EE23DP003/eFuse/inkscape/Pics/Setup Pic/overall_setup.jpg

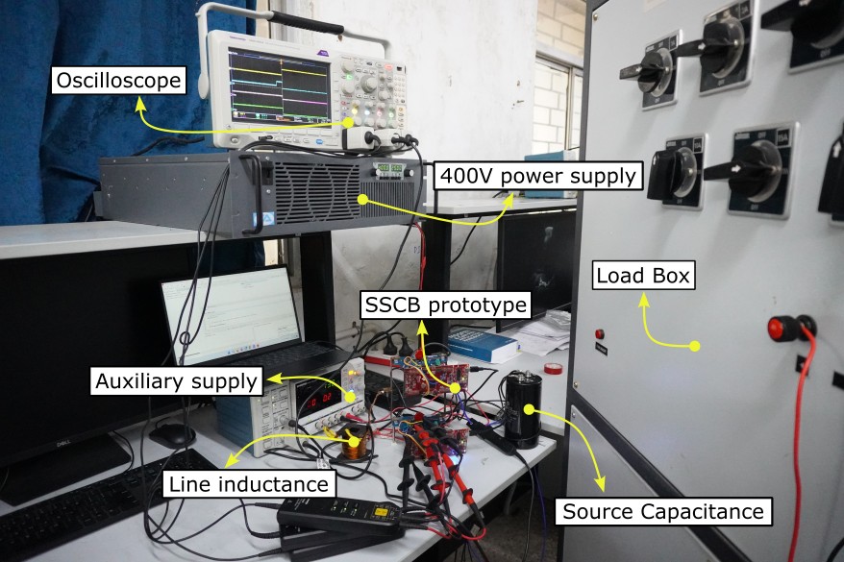
inkscape/Pics/Setup Pic/overall_setup.jpg
