EE23DP003/eFuse/inkscape/Pics/Modular pic/modular_image.jpg

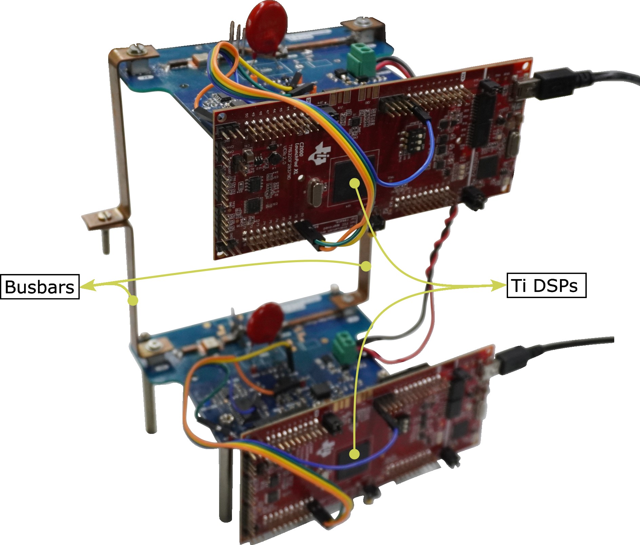
inkscape/Pics/Modular pic/modular_image.jpg
