EE23DP003/eFuse/inkscape/Fixed time modular/fixed-time-modular-10-15A.pdf

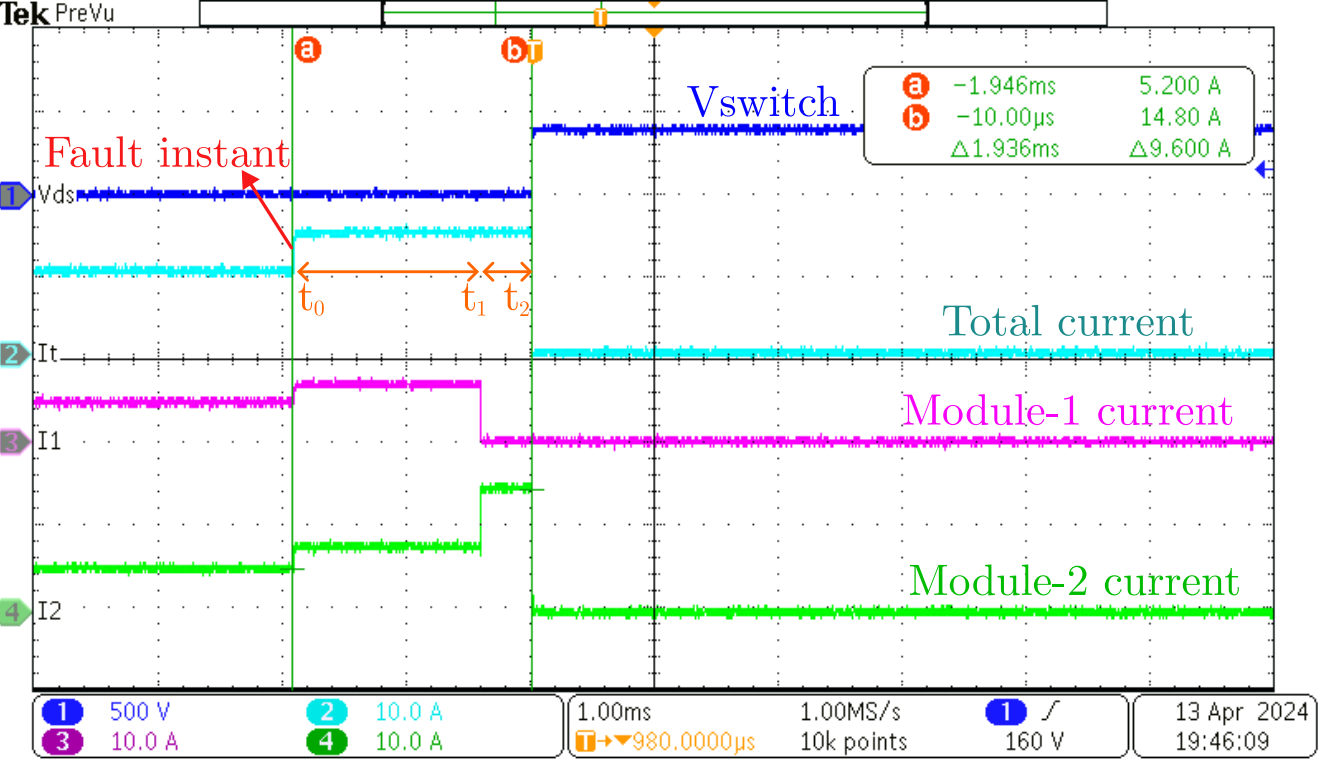
[picture p3: page 1]
