EE23DP003/eFuse/inkscape/Fixed time tripping/Fixed_time_tripping-10-20A.pdf

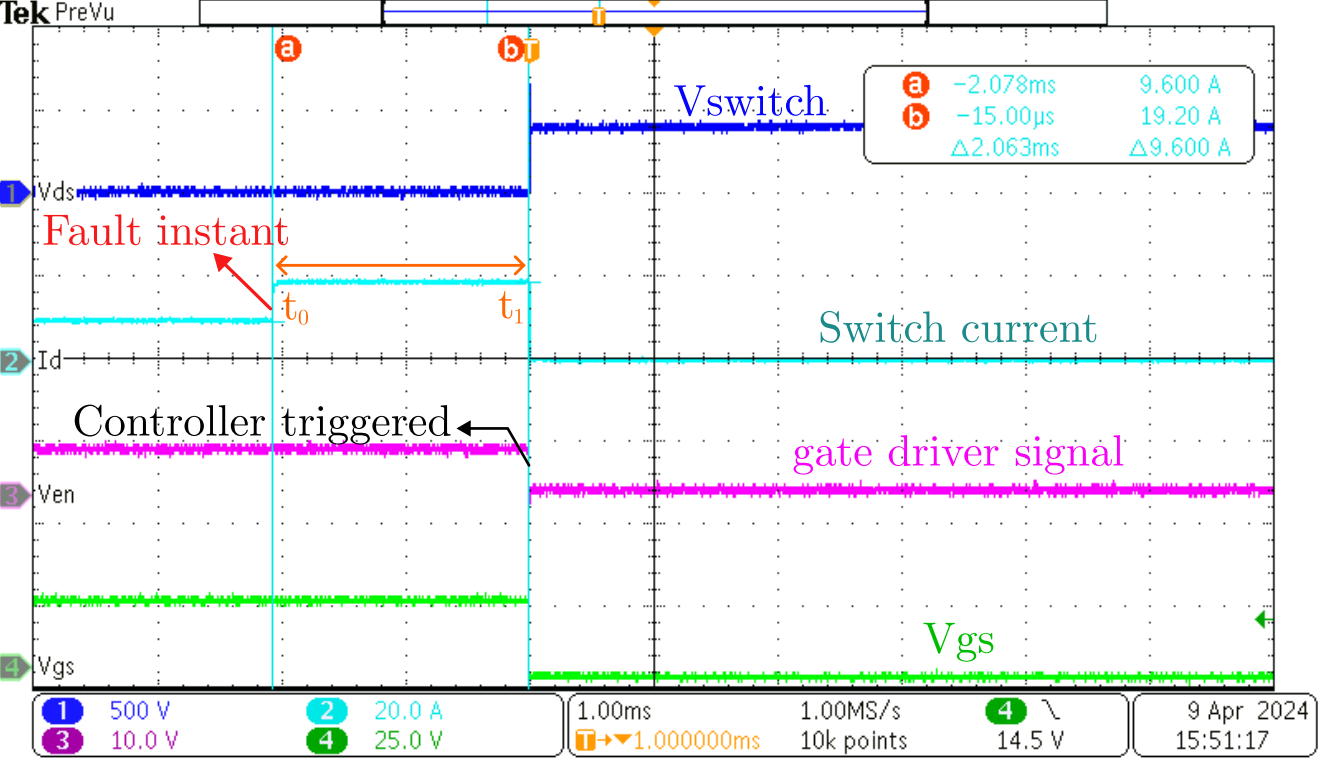
[picture p4: page 1]
