EE23DP003/eFuse/inkscape/Fixed time tripping/Fixed_time_tripping-10-25A.pdf

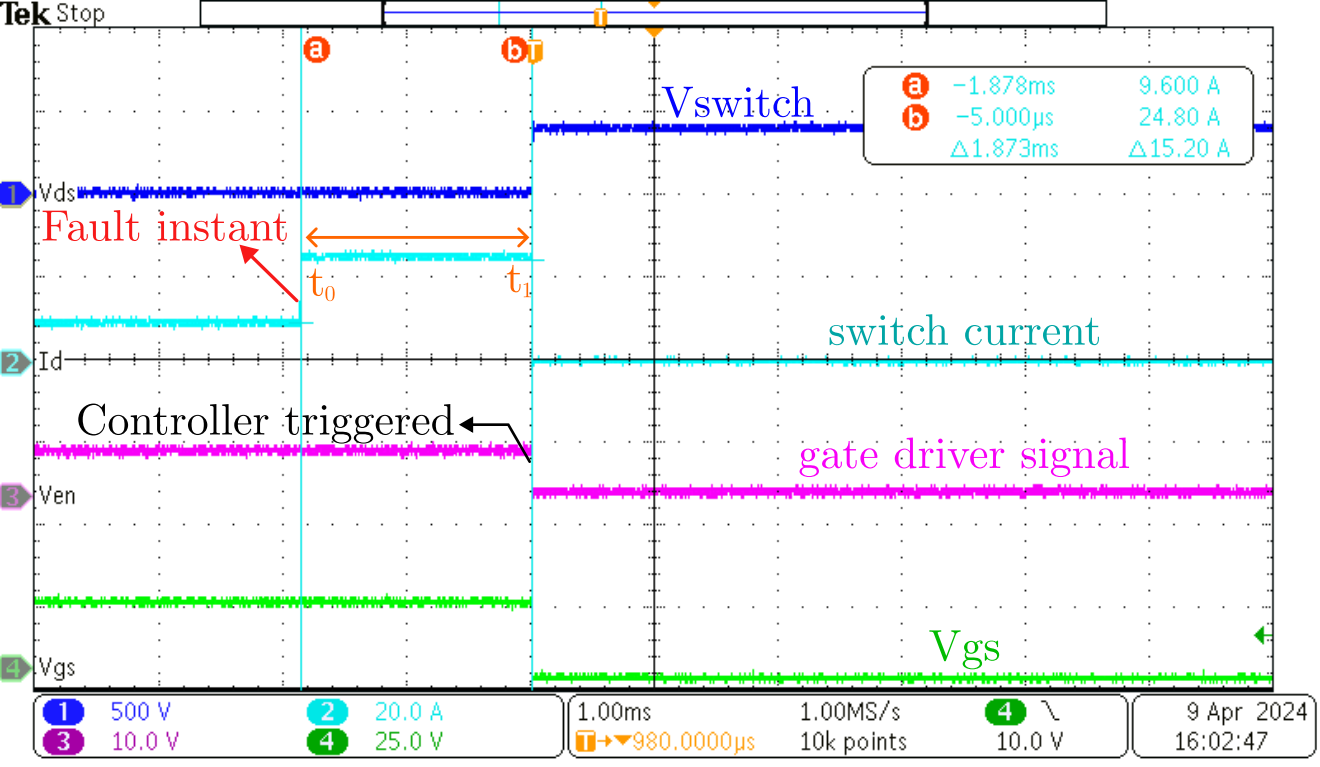
[picture p5: page 1]
