EE23DP003/eFuse/inkscape/I2T back to normal current/I2t_back_to_normal_current.pdf

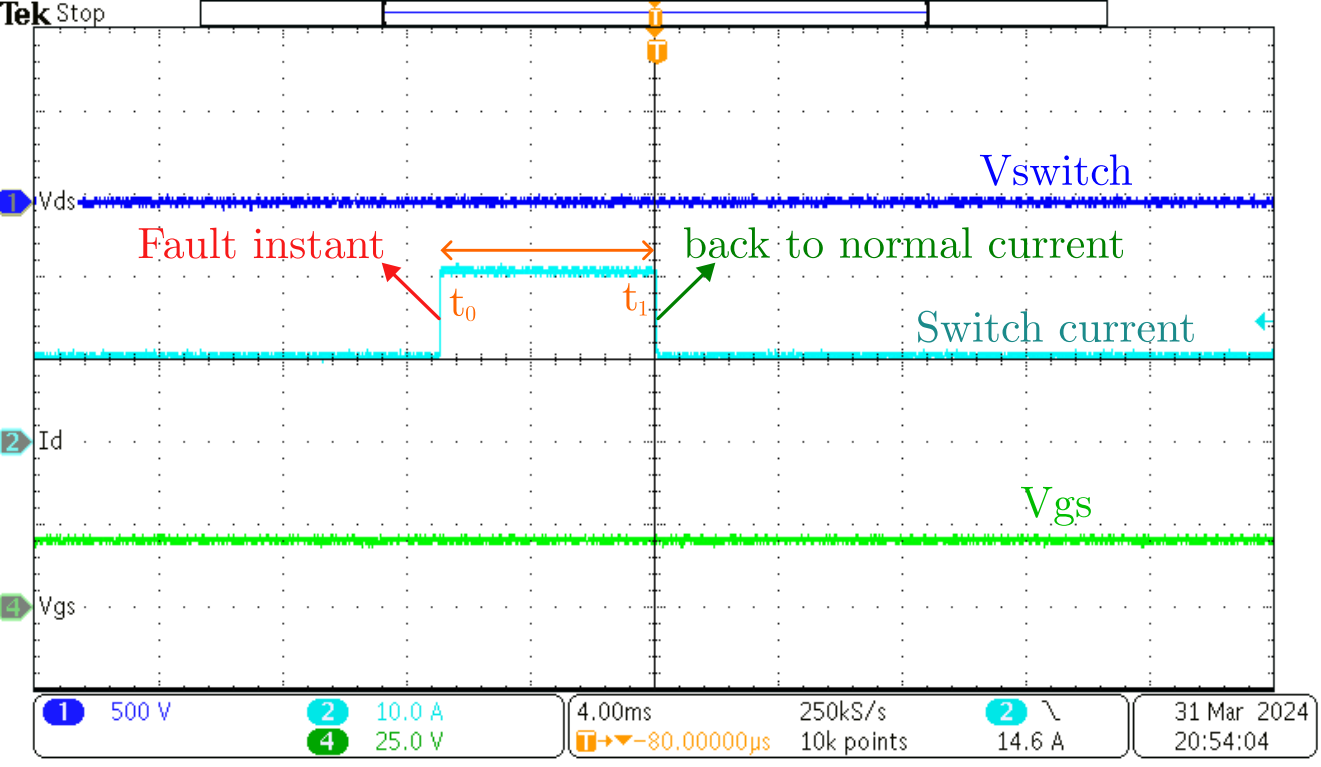
[picture p6: page 1]
