EE23DP003/eFuse/inkscape/I2T single module/i2T_single_module_4-23A.pdf

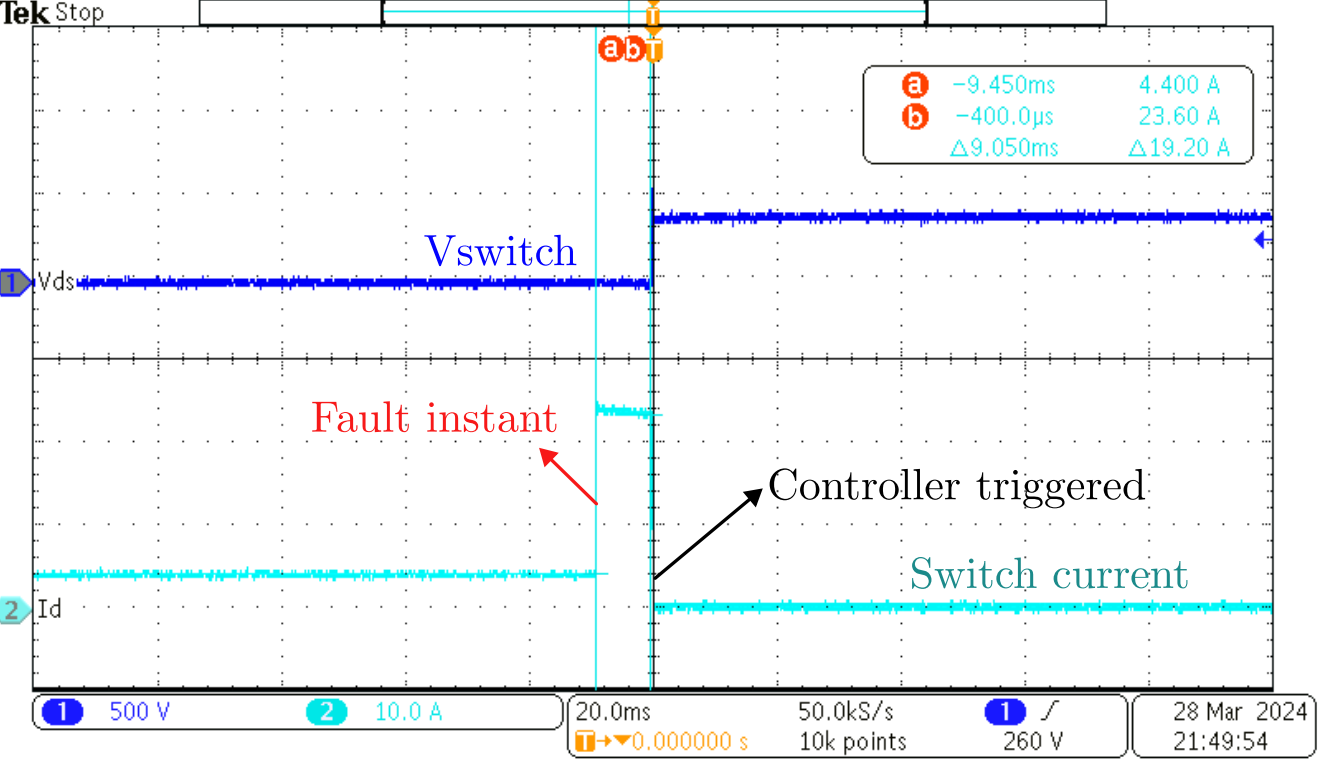
[picture p7: page 1]
