EE23DP003/eFuse/inkscape/I2T single module/i2T_single_module_4-8A.pdf

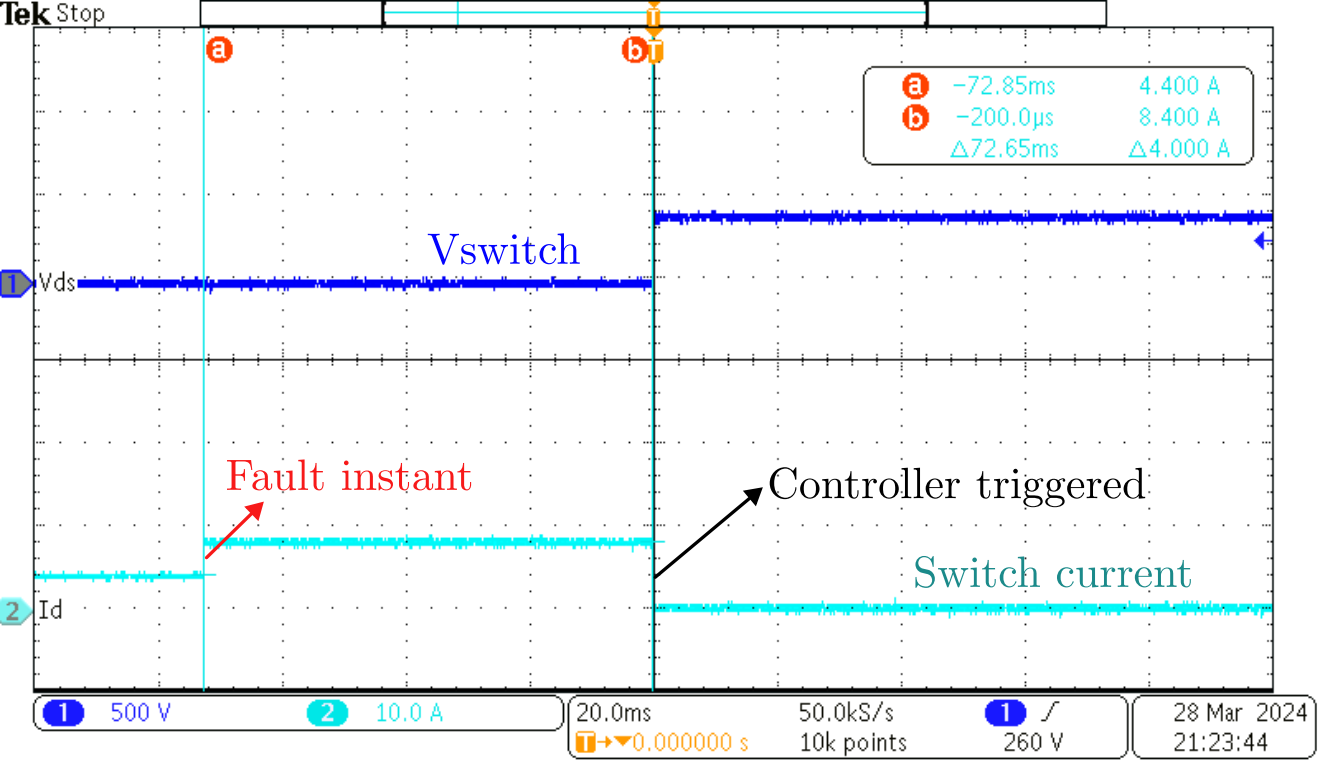
[picture p8: page 1]
