EE23DP003/eFuse/inkscape/I2T-modular/i2t_modular_10-16A_zoomed.pdf

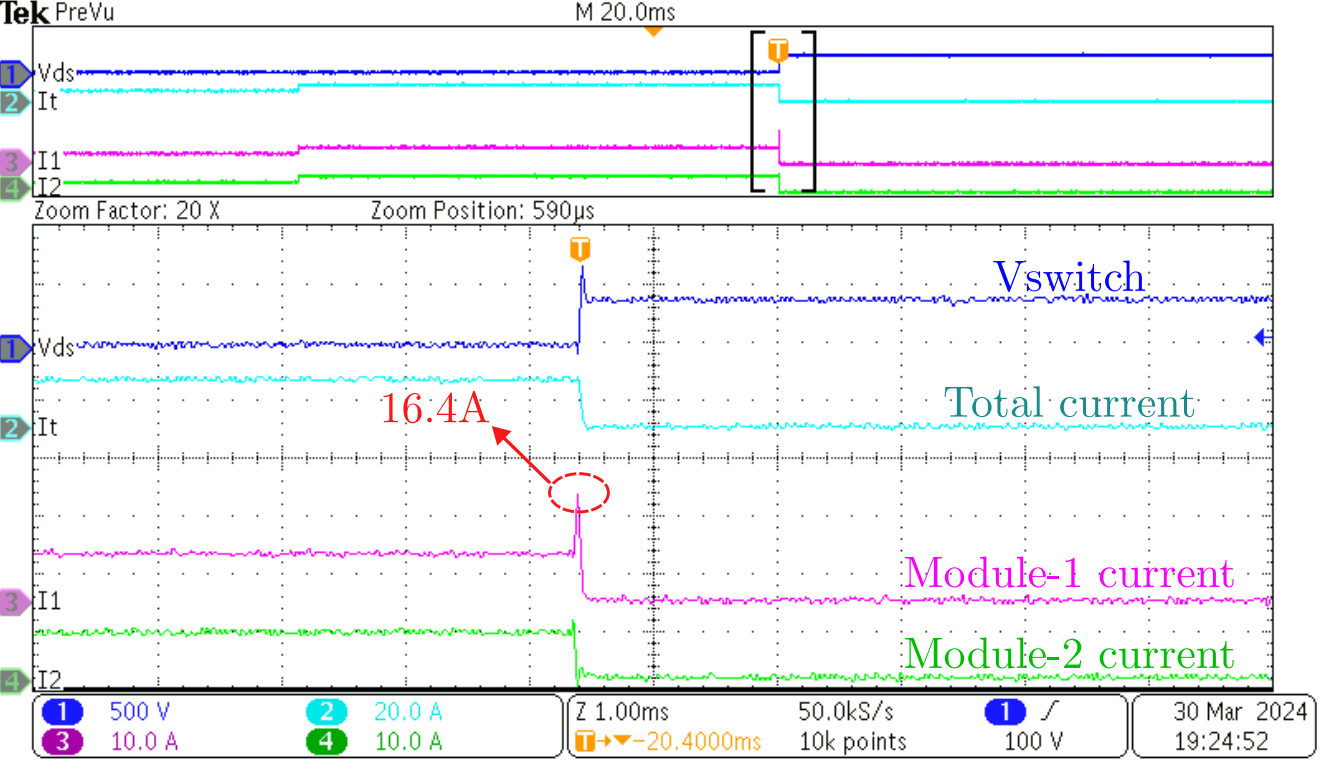
[picture p9: page 1]
