EE23DP003/eFuse/inkscape/I2T-modular/i2t_modular_10-19A.pdf

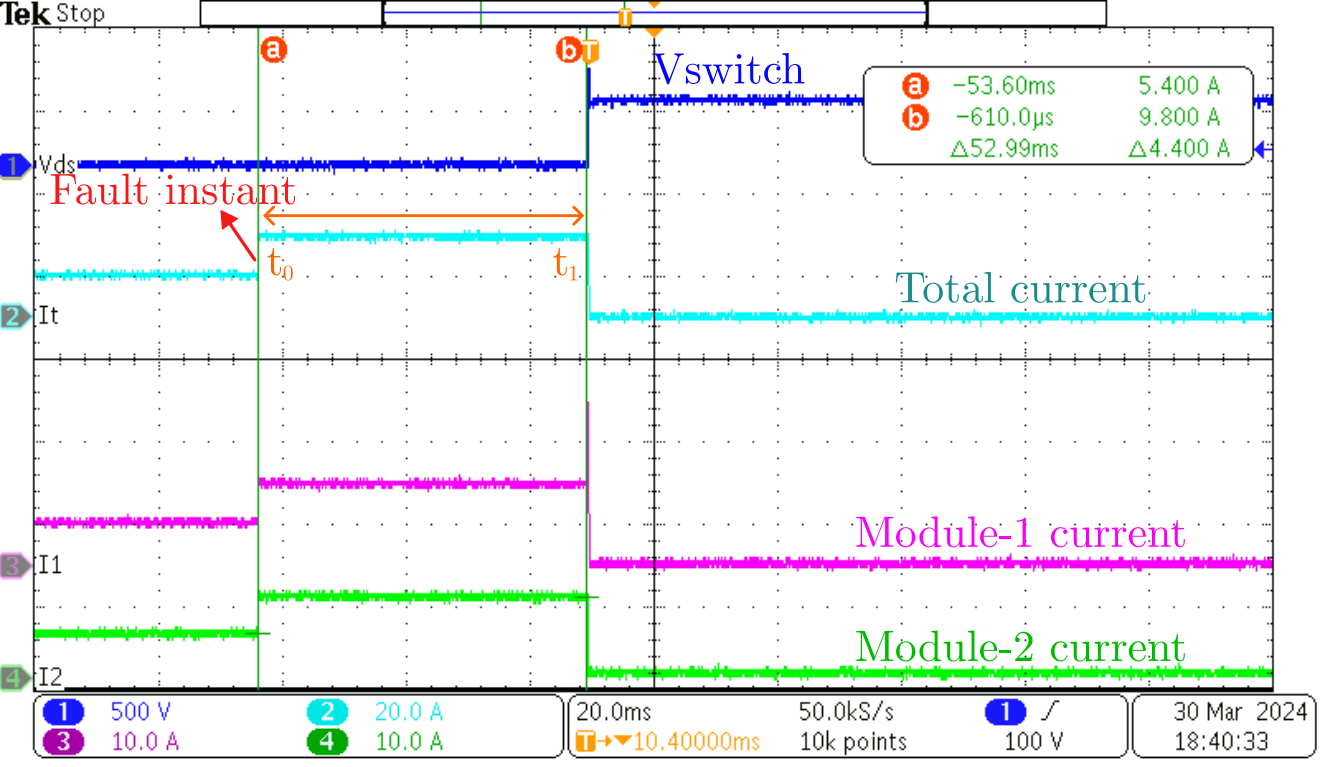
[picture p10: page 1]
