EE23DP003/eFuse/inkscape/I2T-modular/i2t_modular_10-19A_zoomed.pdf

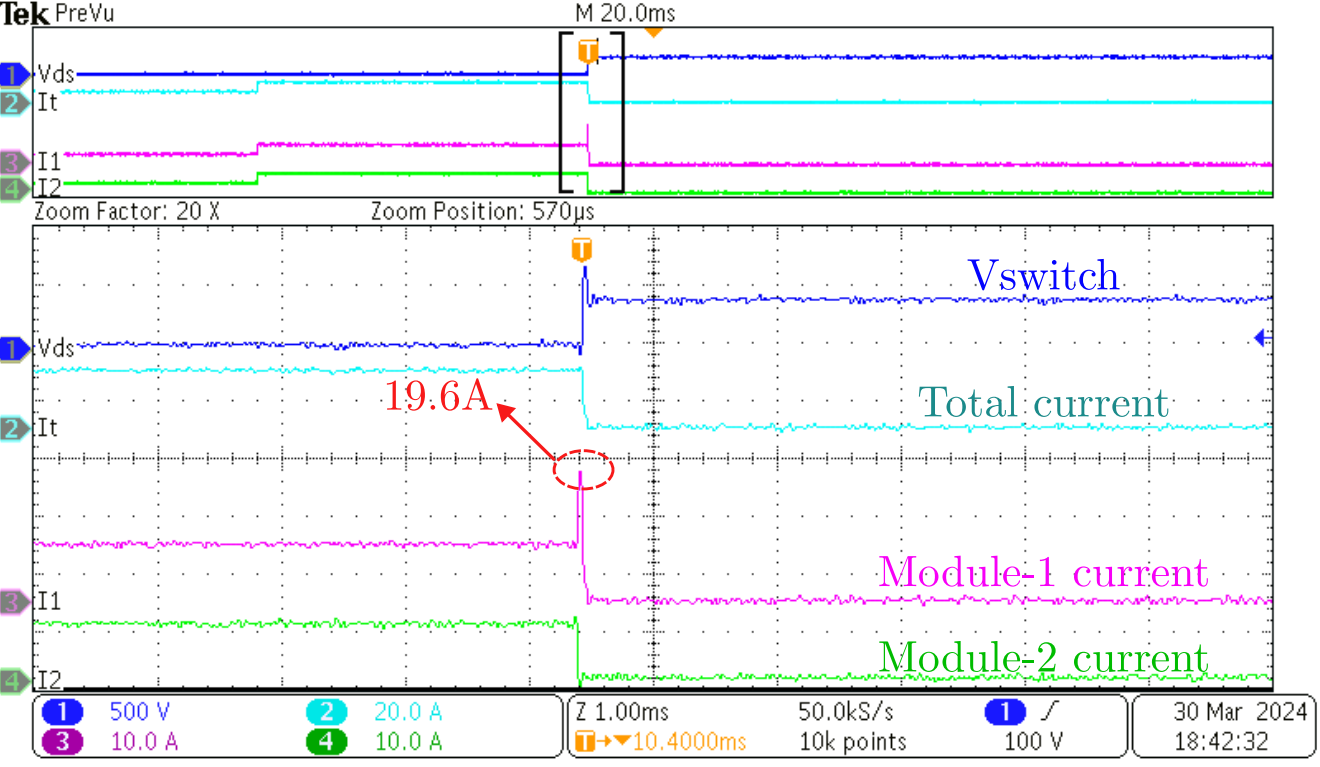
[picture p11: page 1]
