EE23DP003/eFuse/inkscape/I2T-modular/i2t_modular_10-22A.pdf

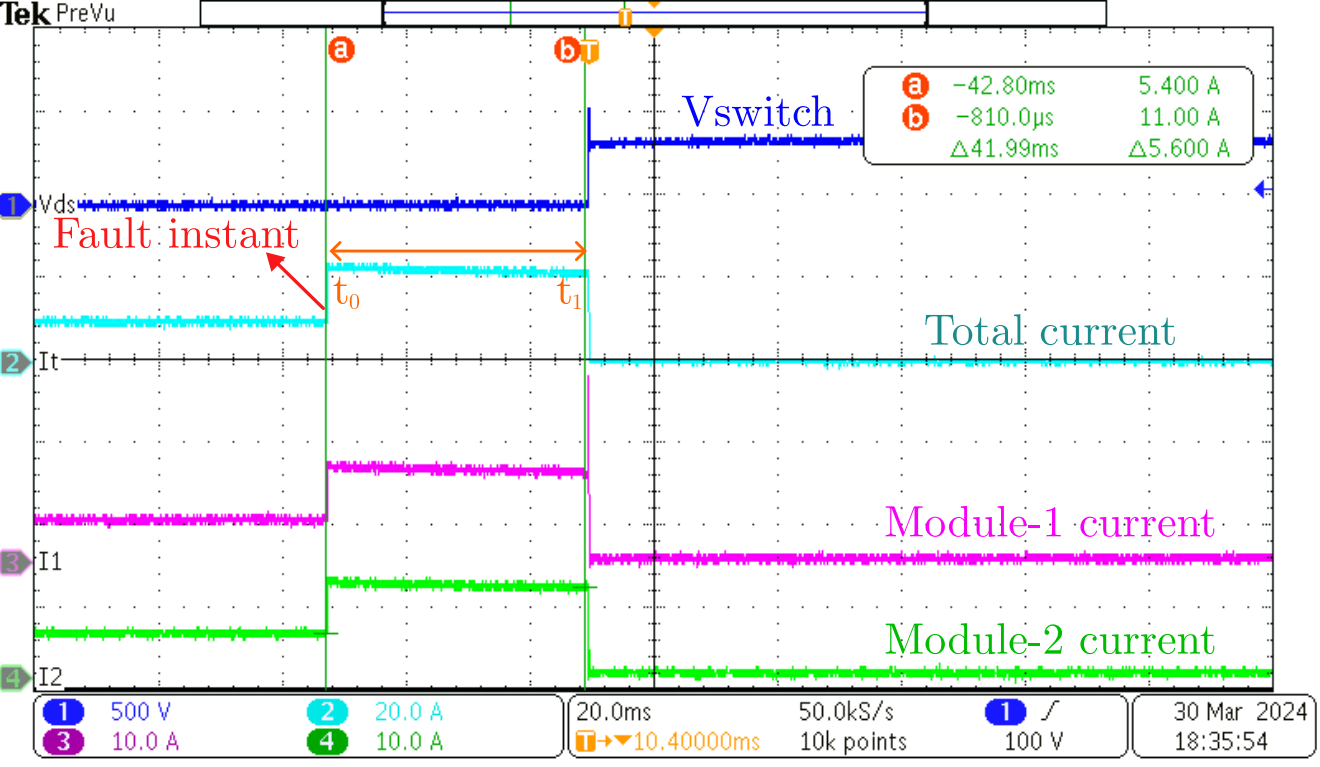
[picture p12: page 1]
