EE23DP003/eFuse/inkscape/I2T-modular/i2t_modular_10-22A_zoomed.pdf

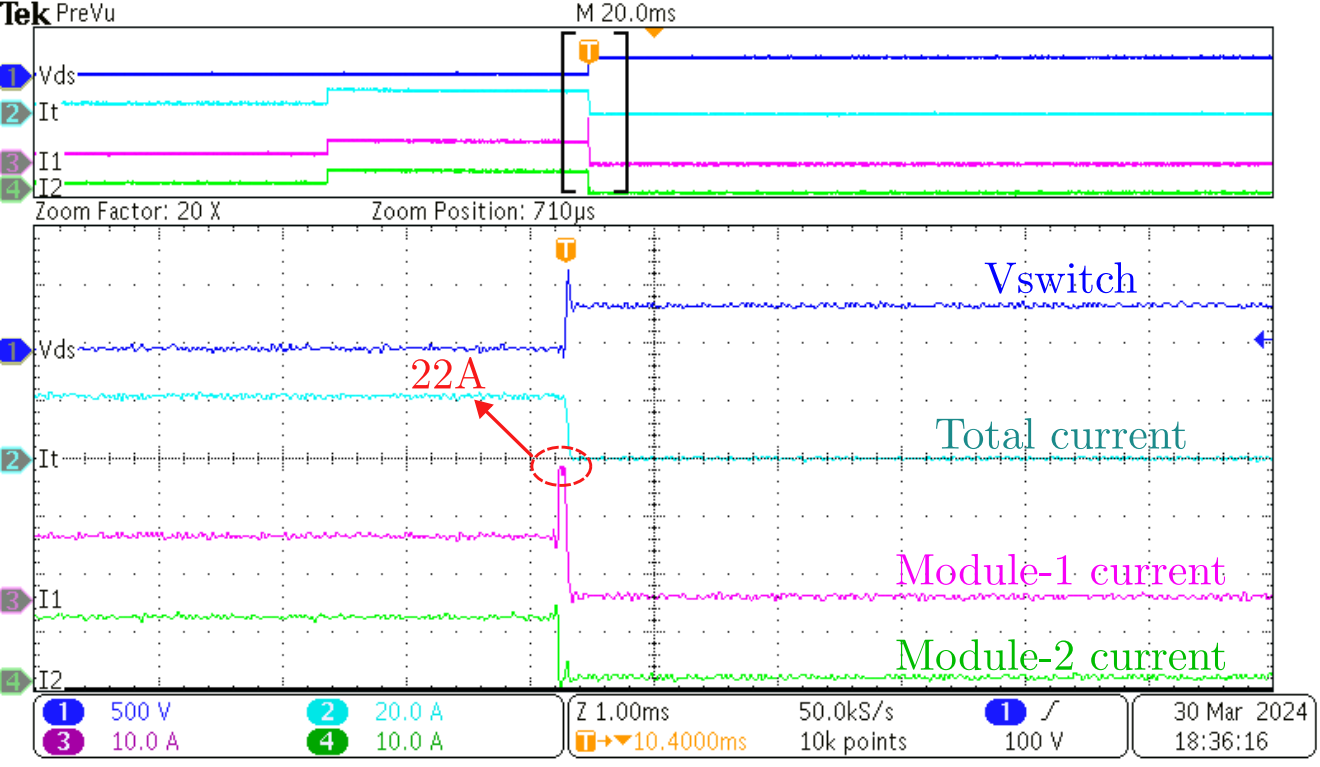
[picture p13: page 1]
