EE23DP003/eFuse/inkscape/Shortcircuit-Modular/modular-shortcircuit_33A.pdf

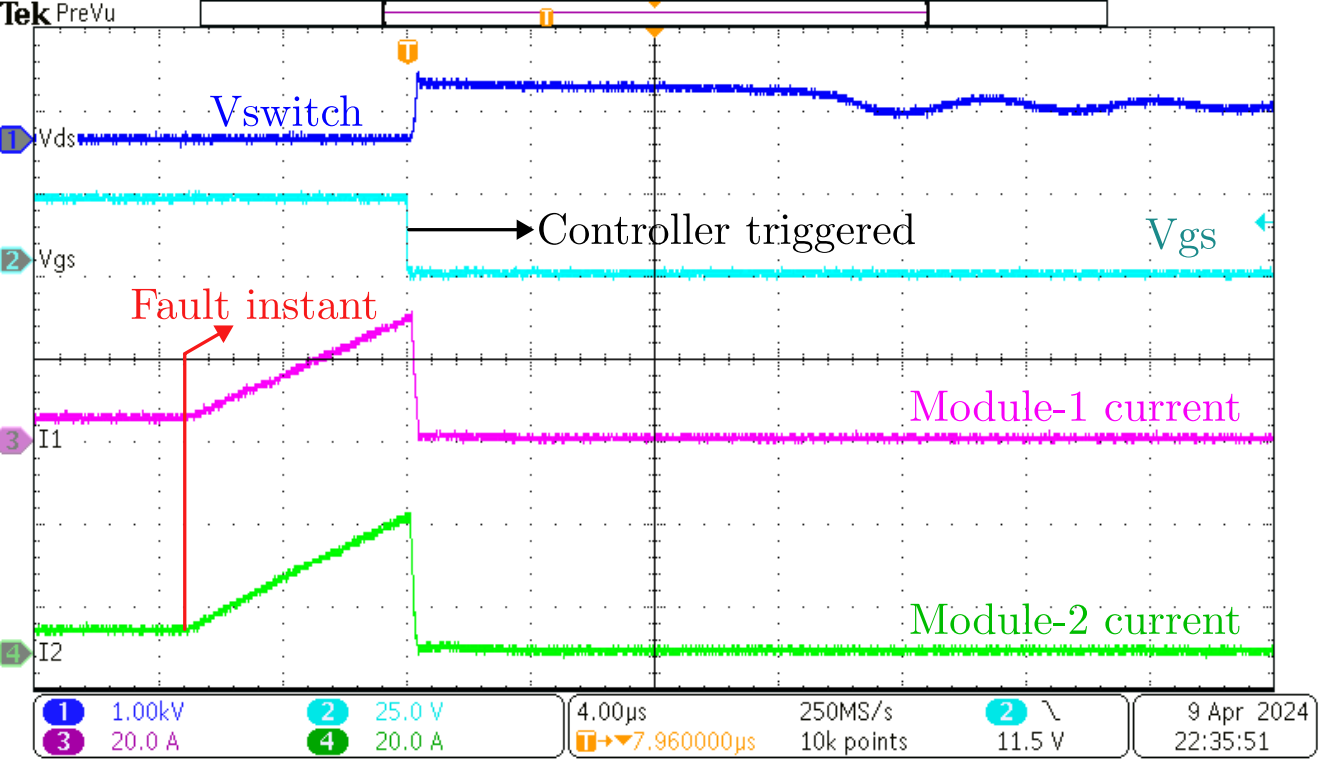
[picture p14: page 1]
