EE23DP003/eFuse/inkscape/Shortcircuit-Modular/modular-shortcircuit_33A_total.pdf

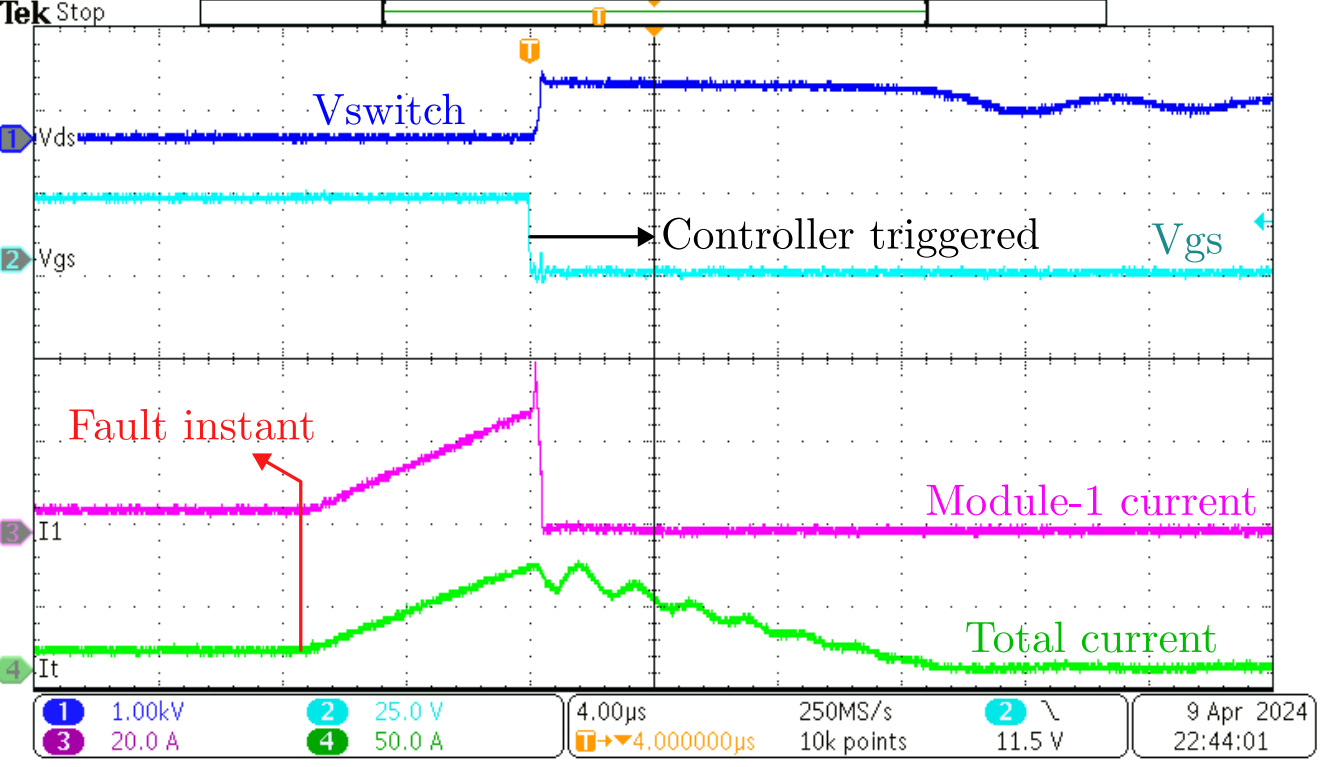
[picture p15: page 1]
