EE23DP003/eFuse/inkscape/Shortcircuit-Modular/modular-shortcircuit_66A_Ovsh.pdf

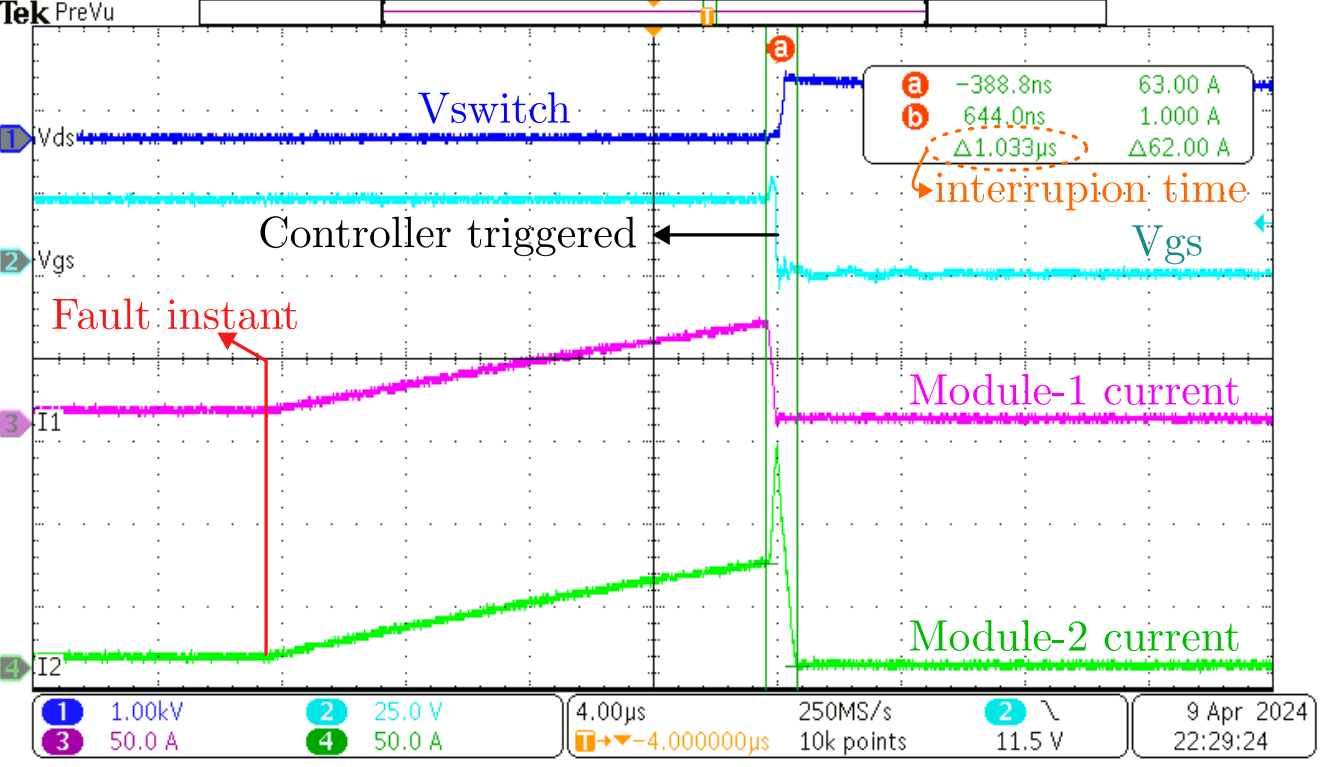
[picture p16: page 1]
