EE23DP003/eFuse/inkscape/Shortcircuit-Modular/modular-shortcircuit_66A_total.pdf

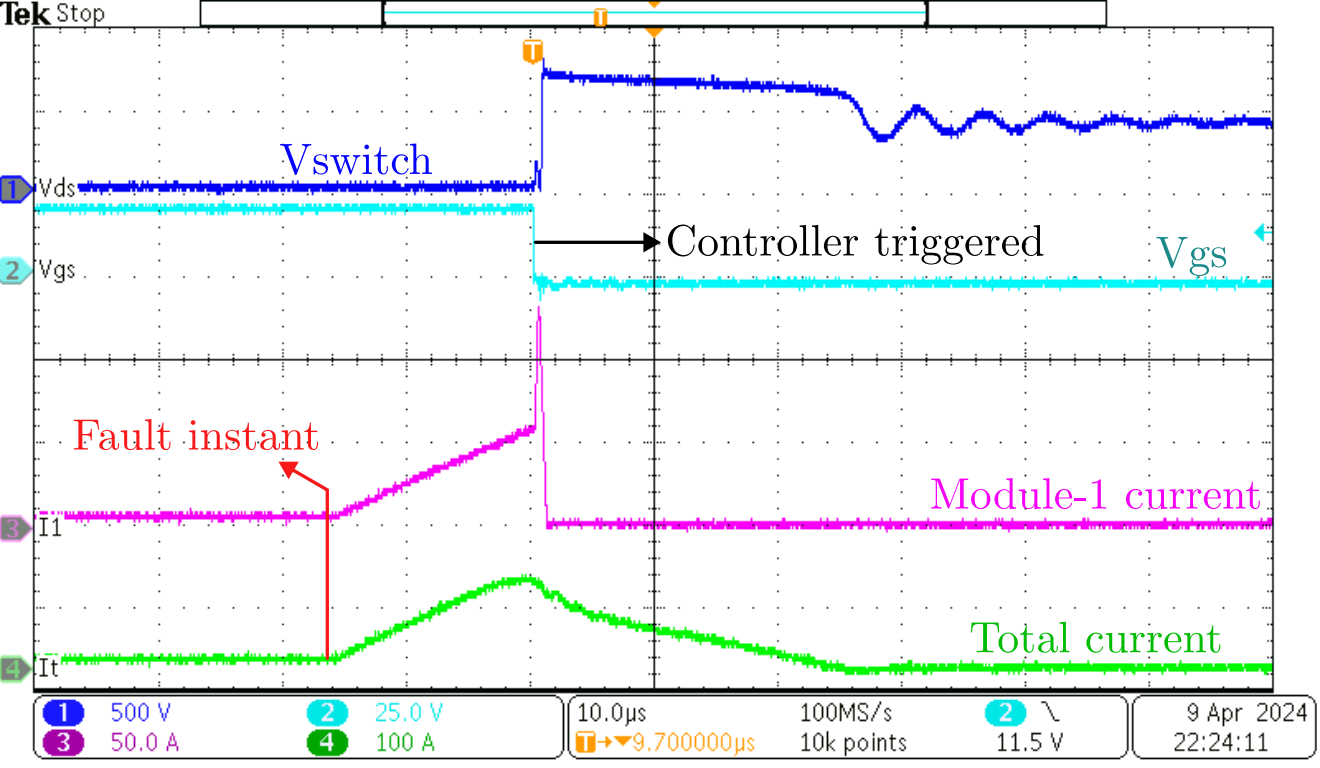
[picture p17: page 1]
