EE23DP003/eFuse/inkscape/Shortcircuit/shortcircuit_32A.pdf

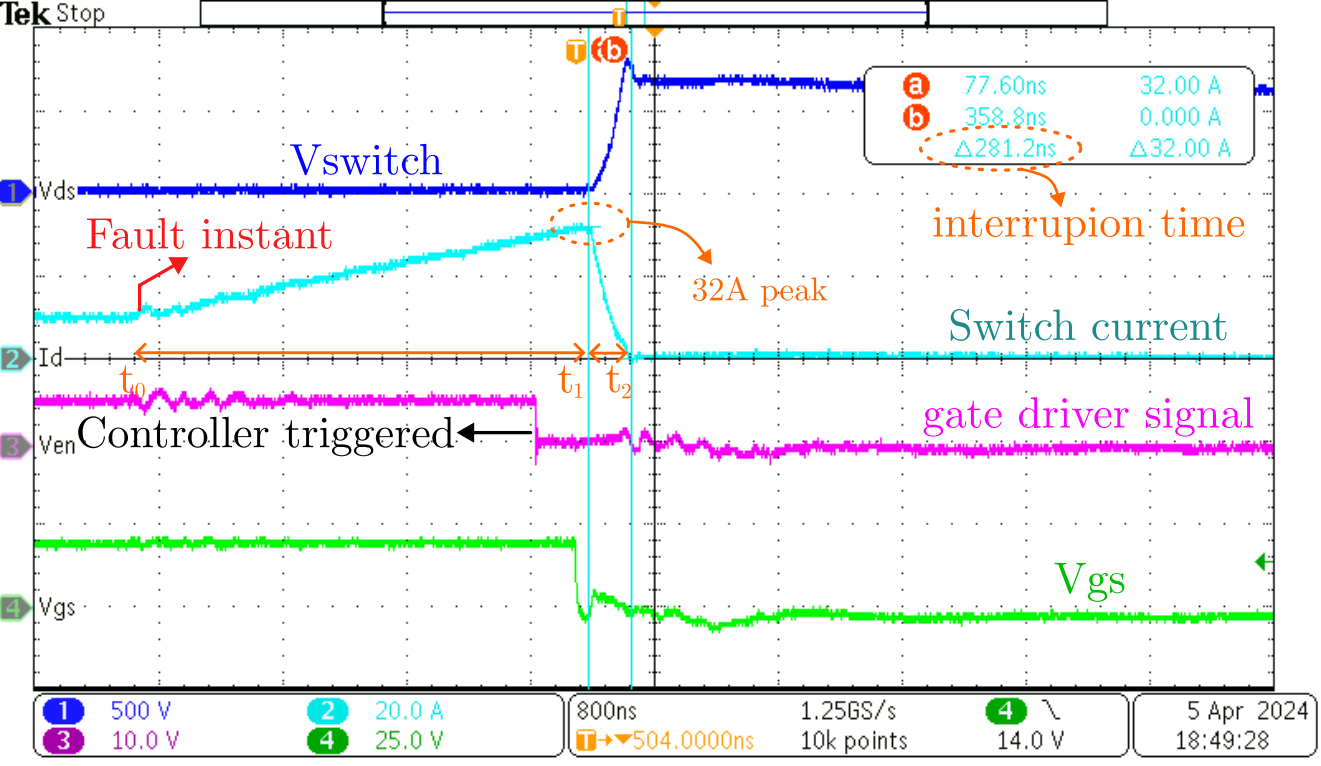
[picture p18: page 1]
