EE23DP003/eFuse/inkscape/Archived/circuit.pdf

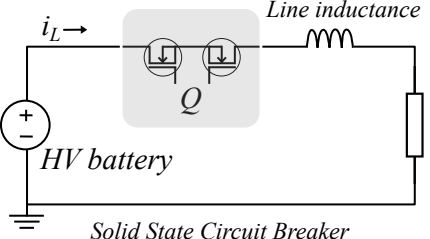
[picture p19: figure]
Solid State Circuit Breaker; Line inductance; HV battery

RL
