EE23DP003/eFuse/inkscape/Archived/overcurrent.pdf

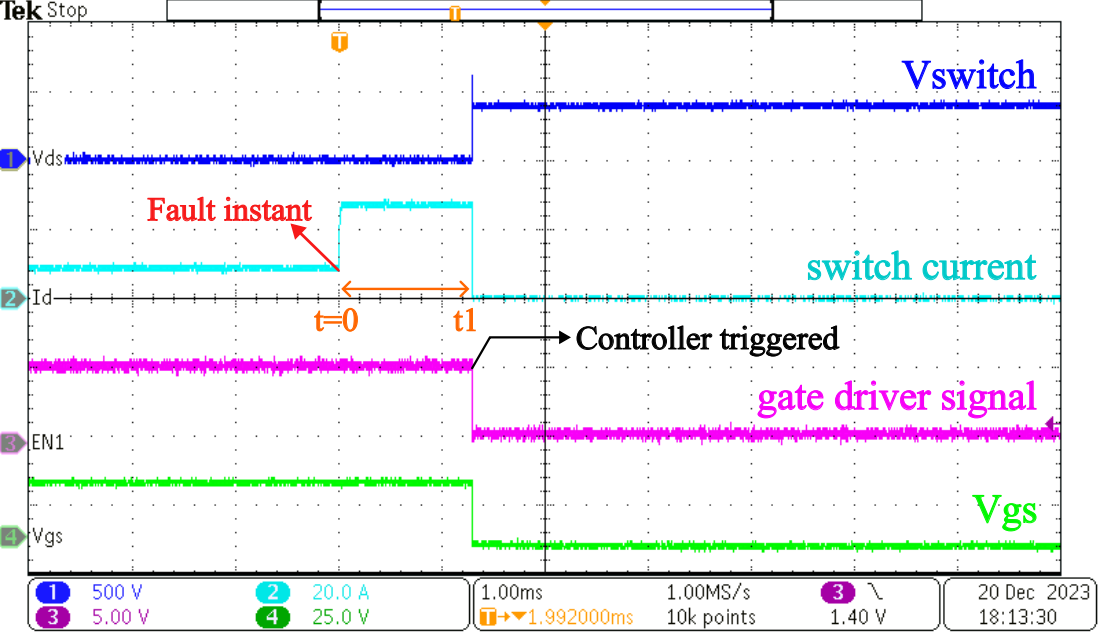
[picture p20: page 1]
switch current; Vgs; Vswitch; Fault instant; Controller triggered

gate driver signal
