EE23DP003/eFuse/inkscape/Archived/shortcircuit.pdf

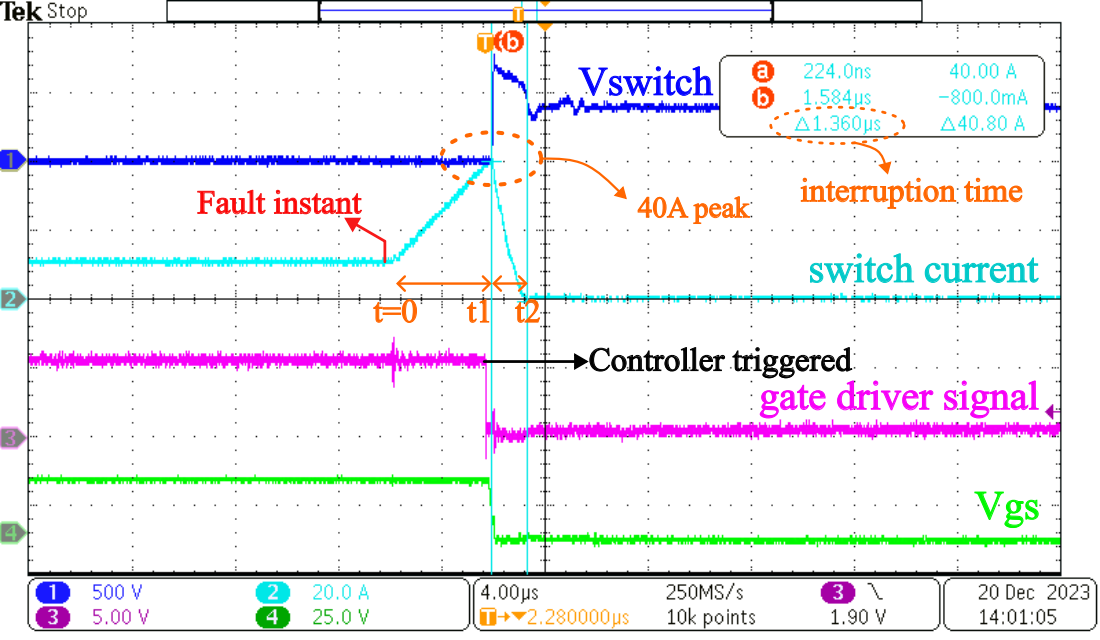
[picture p21: page 1]
Vgs; switch current; Vswitch; 40A peak; Fault instant; interruption time; Controller triggered

gate driver signal
