EE23DP003/eFuse/inkscape/Pics/Single module pic/single_module.jpg

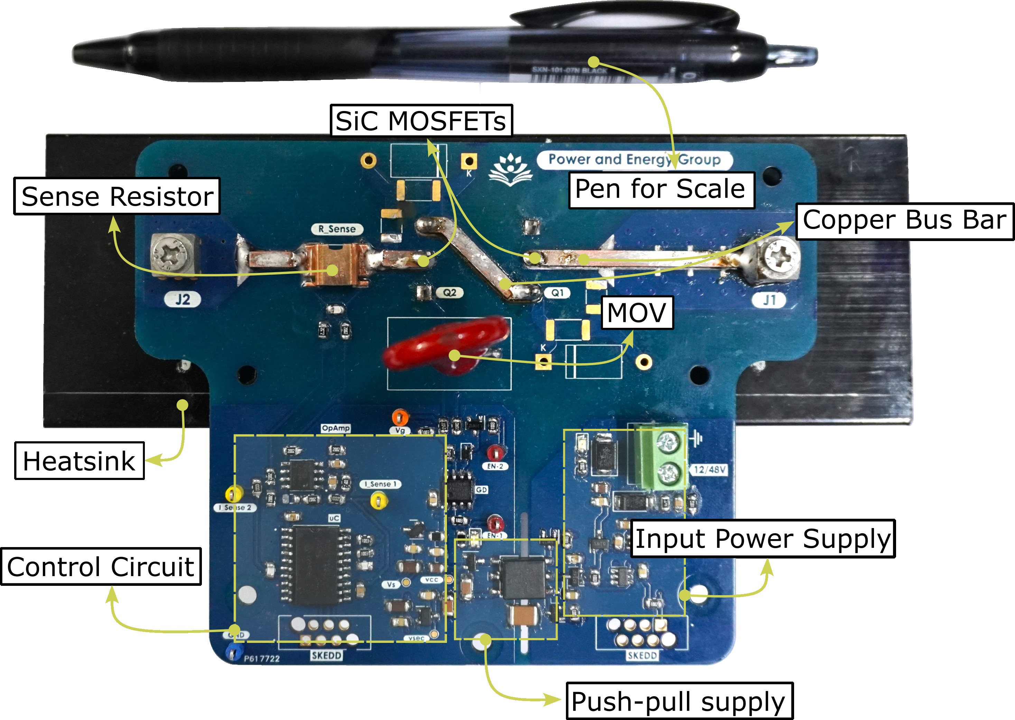
inkscape/Pics/Single module pic/single_module.jpg
