EE23DP003/eFuse/MATLAB/I2T_matlab.jpg

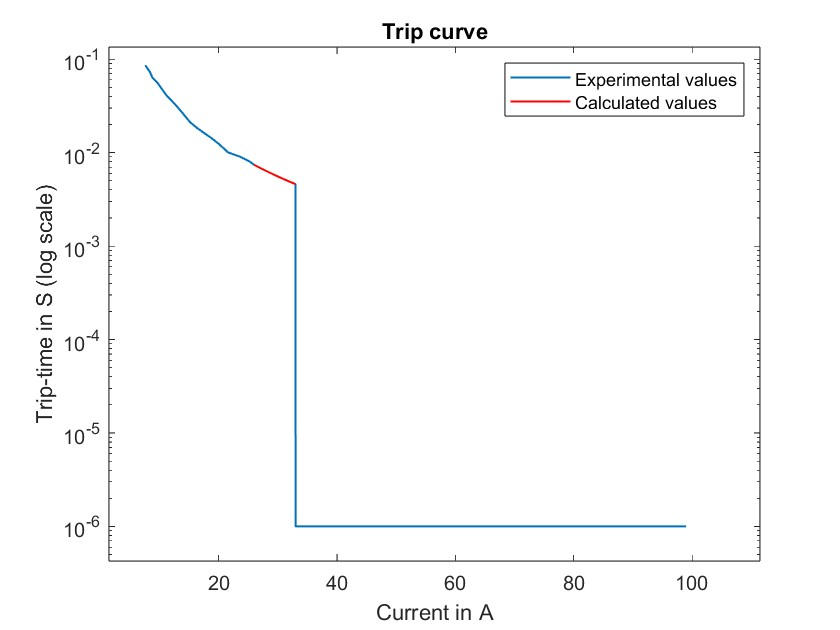
MATLAB/I2T_matlab.jpg
