EE23DP003/eFuse/Pics/Single module pics/board_top.png

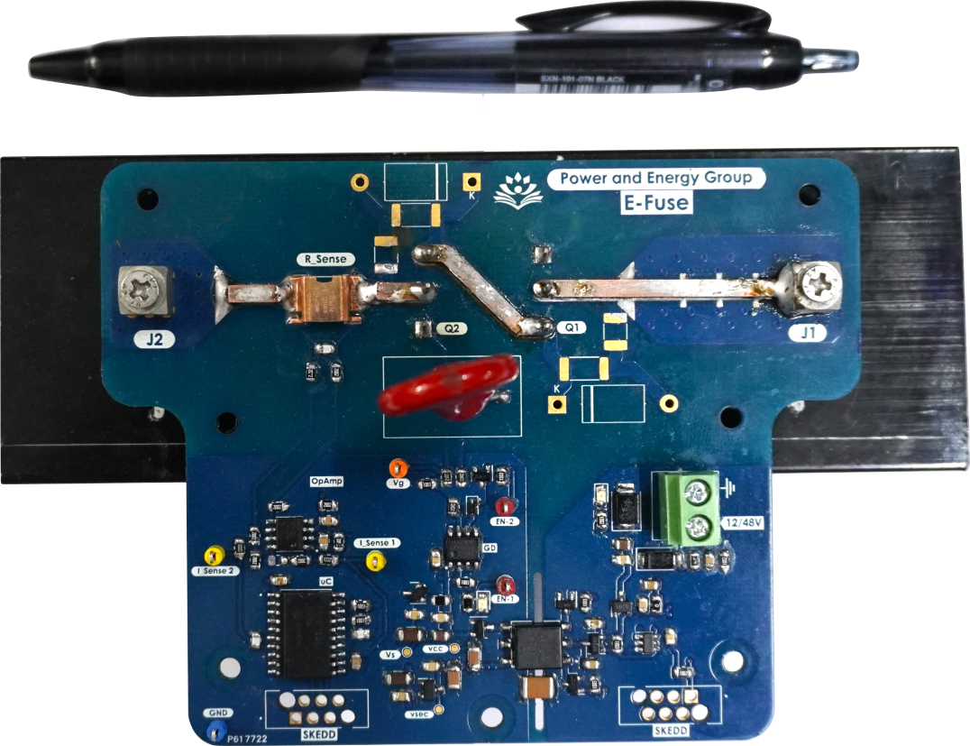
Pics/Single module pics/board_top.png
