EE23DP003/eFuse/PCB files/Footprints&symbols/2EDF7275F/3D/2EDF7275F.stp

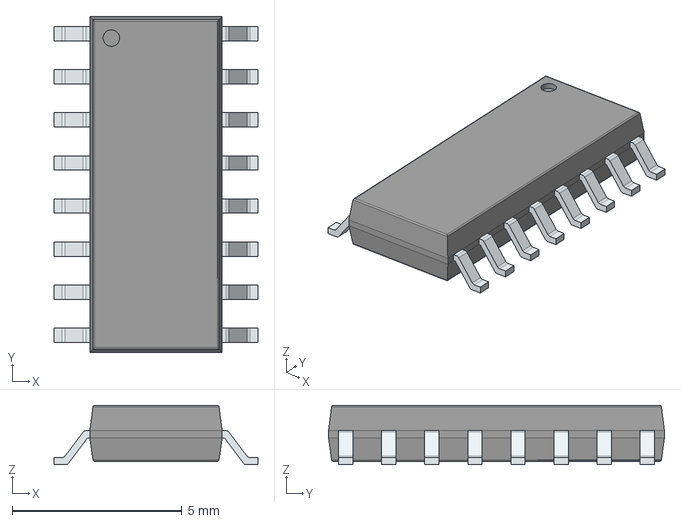
[picture p25: CAD file, 2025-01-24]
PCB files/Footprints&symbols/2EDF7275F/3D/2EDF7275F.stp
6.00 x 9.90 x 1.75 mm
PinsArrayLR
