EE23DP003/eFuse/PCB files/Footprints&symbols/3.3V murata module/3D/NXE2S1205MC-R13.stp

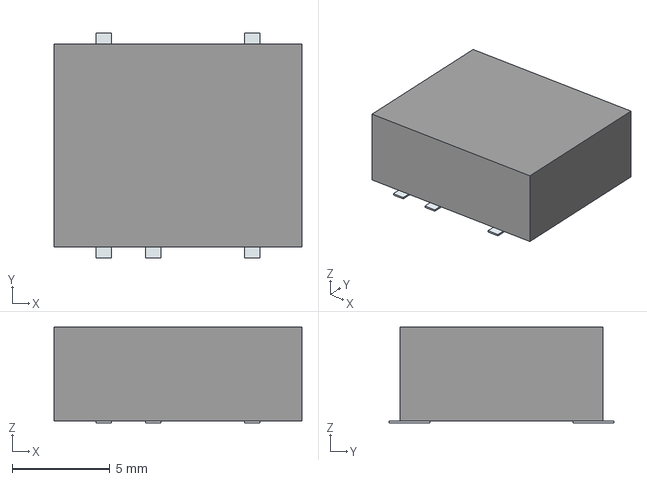
[picture p26: CAD file, 2025-01-24]
PCB files/Footprints&symbols/3.3V murata module/3D/NXE2S1205MC-R13.stp
12.7 x 11.5 x 4.91 mm
Pins
