EE23DP003/eFuse/PCB files/Footprints&symbols/5001 tp/5001.step

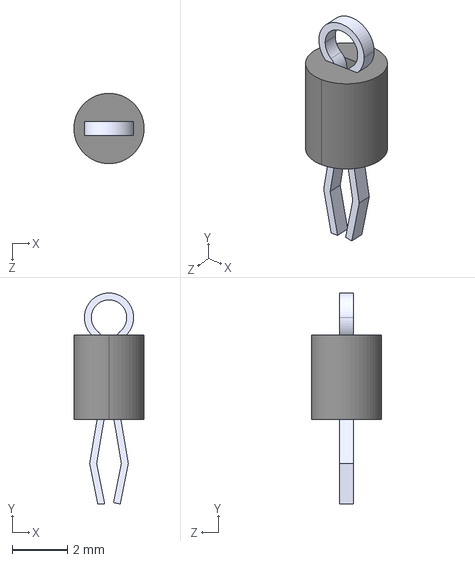
[picture p27: CAD file, 2025-01-24]
PCB files/Footprints&symbols/5001 tp/5001.step
2.54 x 7.62 x 2.54 mm
