EE23DP003/eFuse/PCB files/Footprints&symbols/AP2210N-3.3TRG1/AP2210N-3.3TRG1.step

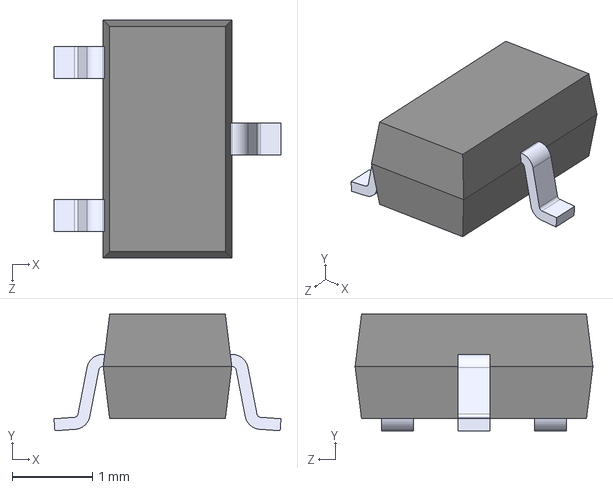
[picture p28: CAD file, 2025-01-24]
PCB files/Footprints&symbols/AP2210N-3.3TRG1/AP2210N-3.3TRG1.step
2.83 x 1.45 x 2.96 mm
