EE23DP003/eFuse/PCB files/Footprints&symbols/GS065060-5TA/GS-065-060-5-T-A.stp

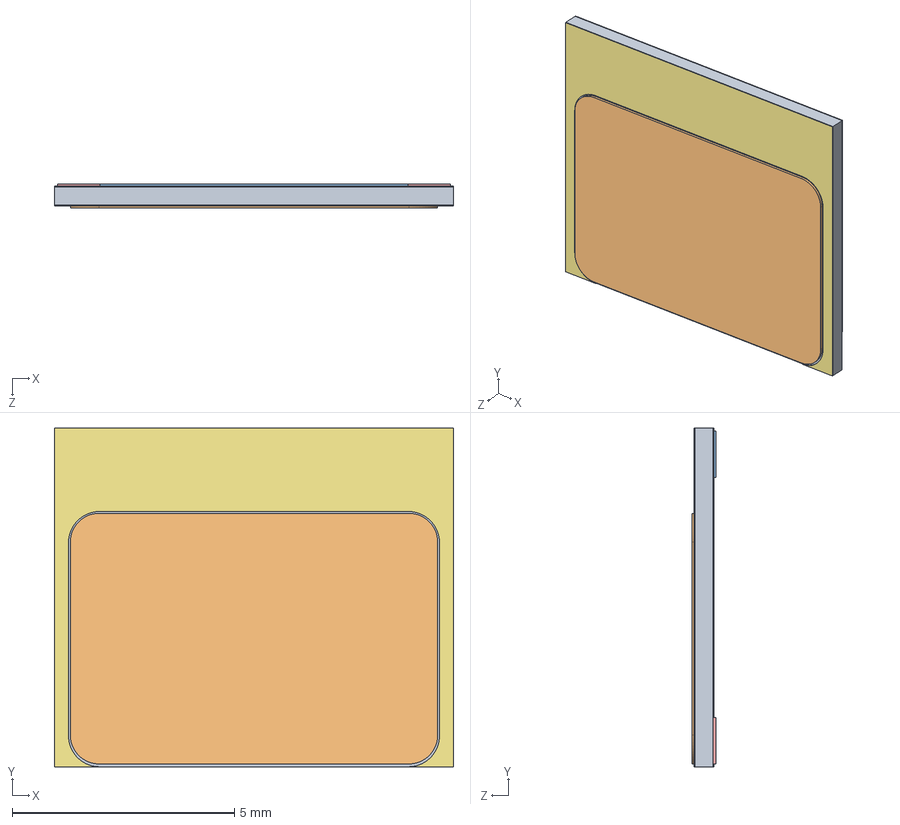
[picture p29: CAD file, 2025-01-24]
PCB files/Footprints&symbols/GS065060-5TA/GS-065-060-5-T-A.stp
8.98 x 7.62 x 0.54 mm
Package
PCB Top
PCB Bottom
SolderMask Bottom
SolderMask Top
