EE23DP003/eFuse/PCB files/Footprints&symbols/IMW120R014M1H/IMW120R014M1H.stp

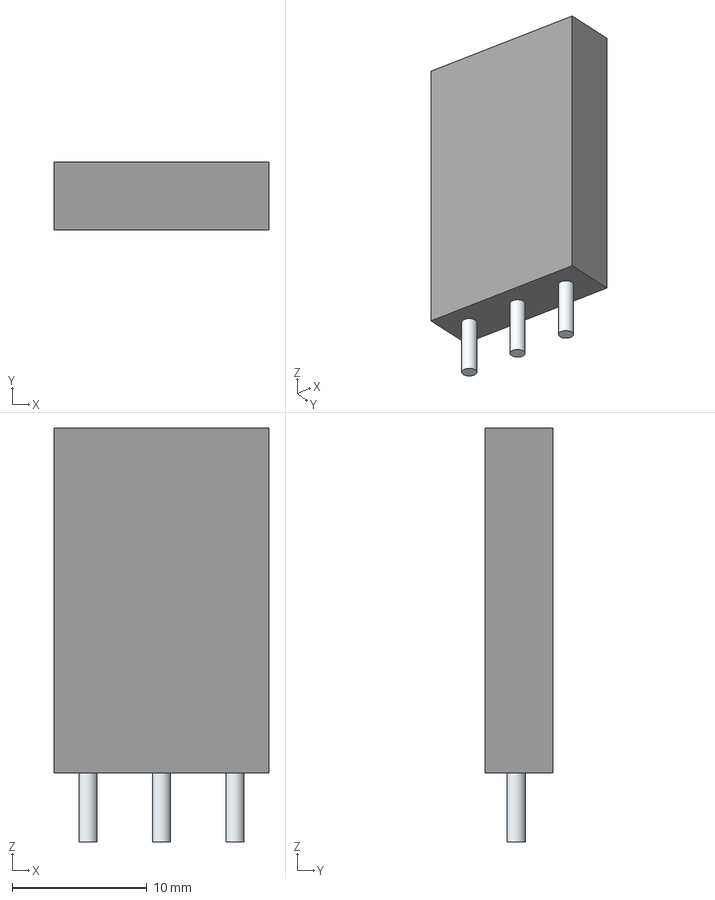
[picture p30: CAD file, 2025-01-24]
PCB files/Footprints&symbols/IMW120R014M1H/IMW120R014M1H.stp
15.9 x 5.03 x 30.7 mm
Leads
