EE23DP003/eFuse/PCB files/Footprints&symbols/MCP1792T-5002H_CB/MCP1792T-5002H_CB.stp

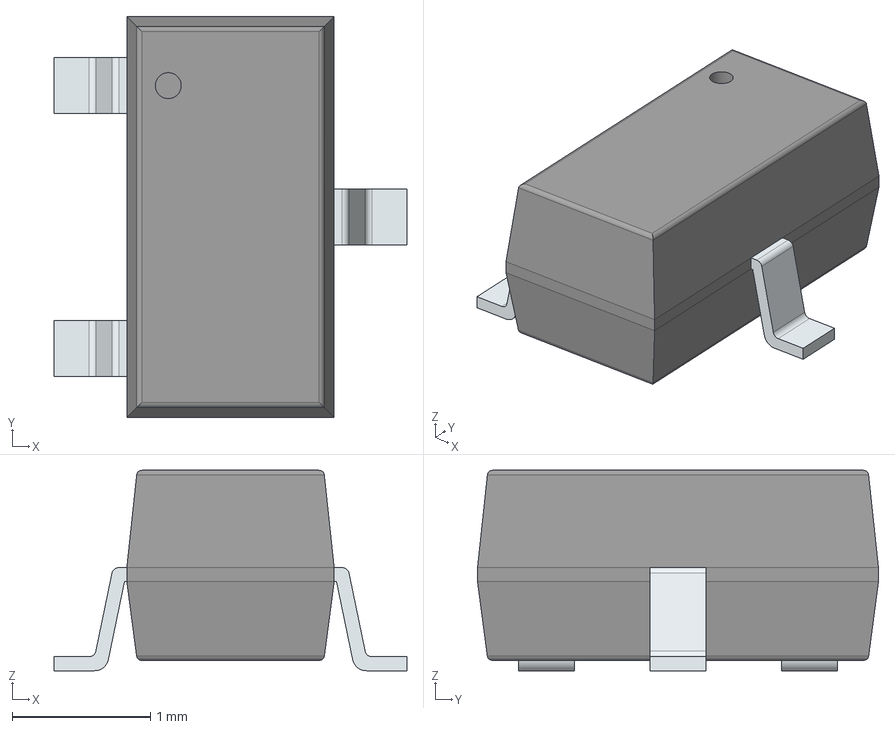
[picture p31: CAD file, 2025-01-24]
PCB files/Footprints&symbols/MCP1792T-5002H_CB/MCP1792T-5002H_CB.stp
2.55 x 2.90 x 1.45 mm
PinsArrayL
FilletPinR
