EE23DP003/eFuse/PCB files/Footprints&symbols/MCP1793T-5002H_OT/MCP1793T-5002H_OT.stp

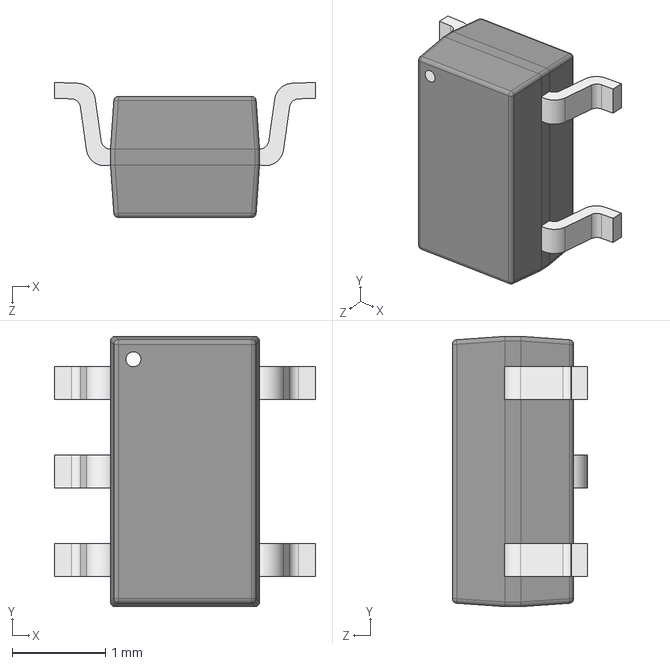
[picture p32: CAD file, 2025-01-24]
PCB files/Footprints&symbols/MCP1793T-5002H_OT/MCP1793T-5002H_OT.stp
2.80 x 2.90 x 1.45 mm
