EE23DP003/eFuse/PCB files/Footprints&symbols/MCP6022-E_SN/MCP6022-E_SN.step

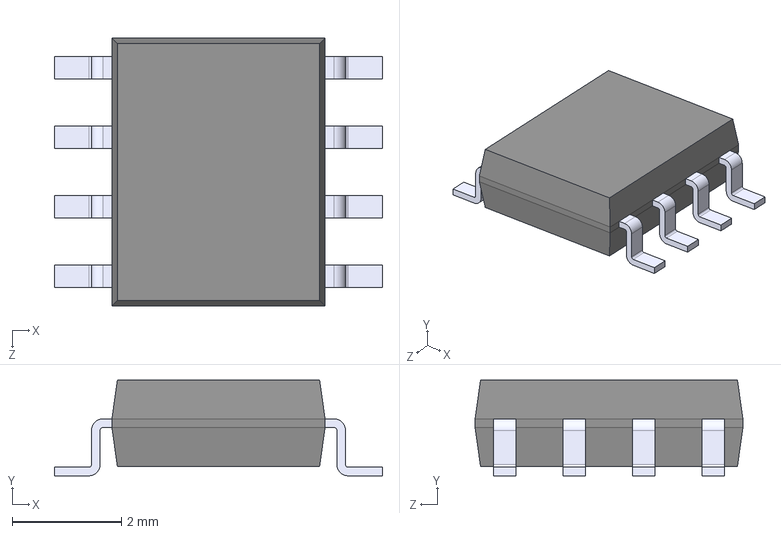
[picture p33: CAD file, 2025-01-24]
PCB files/Footprints&symbols/MCP6022-E_SN/MCP6022-E_SN.step
6.00 x 1.75 x 4.90 mm
