EE23DP003/eFuse/PCB files/Footprints&symbols/MGN1D120603MC/MGN1D120603MC-R7.stp

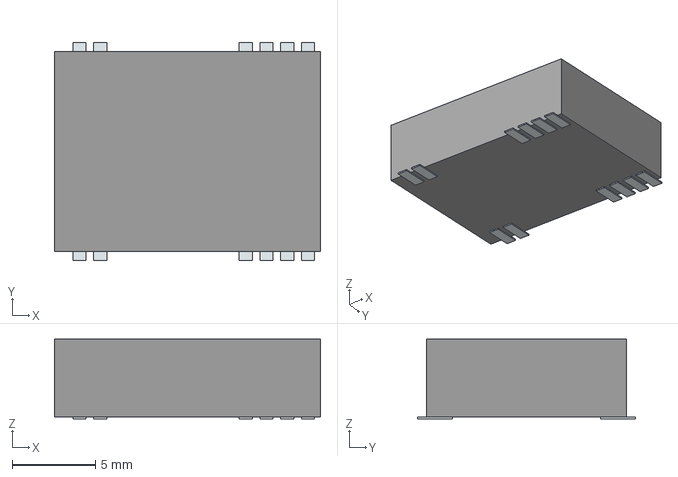
[picture p34: CAD file, 2025-01-24]
PCB files/Footprints&symbols/MGN1D120603MC/MGN1D120603MC-R7.stp
16.0 x 13.1 x 4.80 mm
Pins
