EE23DP003/eFuse/PCB files/Footprints&symbols/OMNI-UNI-27-50/OMNI-UNI-27-50.stp

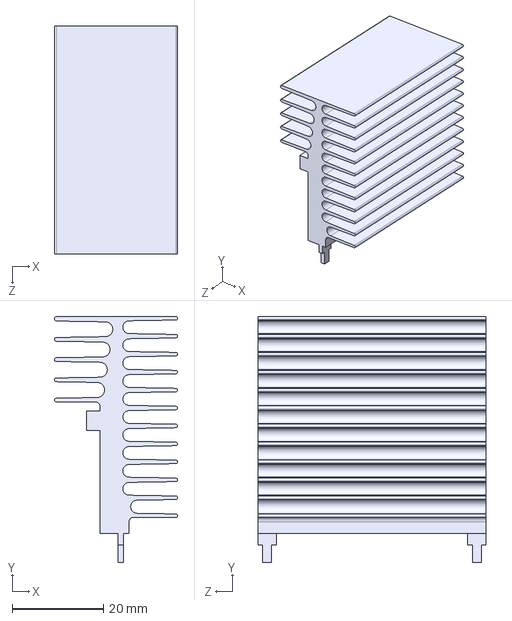
[picture p35: CAD file, 2025-01-24]
PCB files/Footprints&symbols/OMNI-UNI-27-50/OMNI-UNI-27-50.stp
27.0 x 53.9 x 50.0 mm
