EE23DP003/eFuse/PCB files/Footprints&symbols/PIC16F15345-ISO/SOIC127P1030X265-20N.step

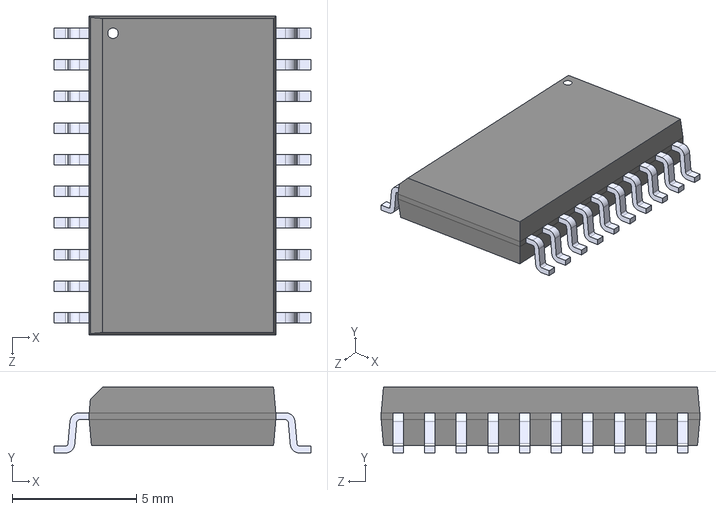
[picture p36: CAD file, 2025-01-24]
PCB files/Footprints&symbols/PIC16F15345-ISO/SOIC127P1030X265-20N.step
10.3 x 2.65 x 12.8 mm
