EE23DP003/eFuse/PCB files/Footprints&symbols/TLE4971/TLE4971A050T5UE0001XUMA1.step

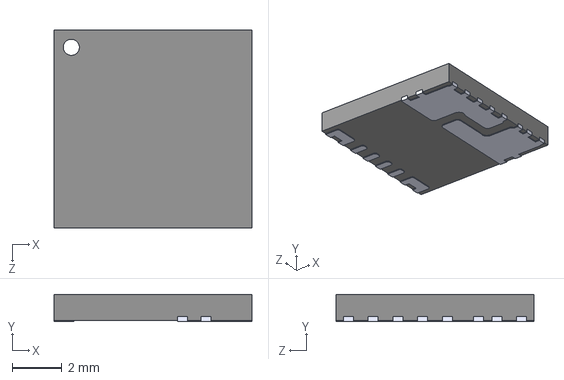
[picture p37: CAD file, 2025-01-24]
PCB files/Footprints&symbols/TLE4971/TLE4971A050T5UE0001XUMA1.step
8.00 x 1.10 x 8.00 mm
