EE23DP003/eFuse/PCB files/Footprints&symbols/WSLP40261L000FEA/3D/WSLP40261L000FEA.stp

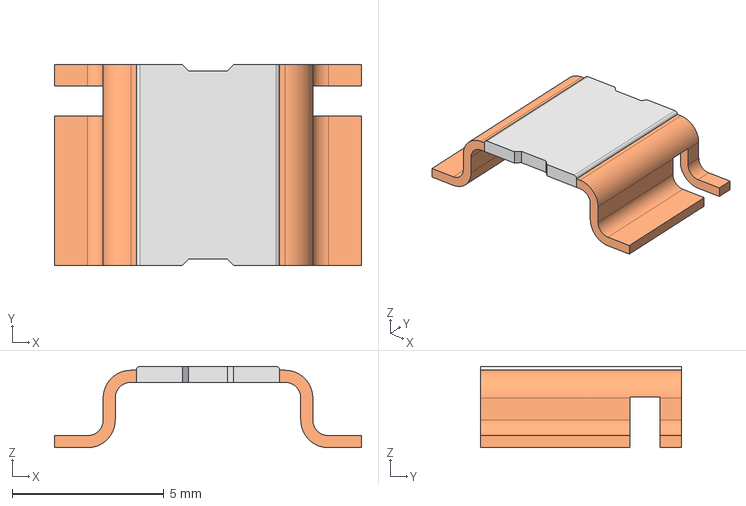
[picture p38: CAD file, 2025-01-24]
PCB files/Footprints&symbols/WSLP40261L000FEA/3D/WSLP40261L000FEA.stp
10.1 x 6.60 x 2.68 mm
