EE23DP003/eFuse/PCB files/Footprints&symbols/IMW120R014M1H/IMW120R045M1.STEP

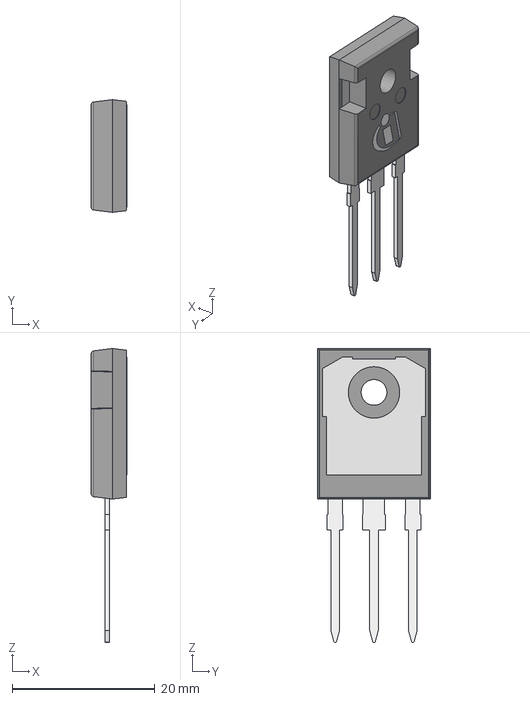
[picture p40: CAD file, 2025-01-24]
PCB files/Footprints&symbols/IMW120R014M1H/IMW120R045M1.STEP
5.01 x 15.8 x 41.2 mm
