EE23DP003/eFuse/(list of files, cad)

Other CAD files:
DSP+PIC codes/I2t codes/i2t_SSCB_with_syscfg/CPU1_FLASH/device/device.obj
DSP+PIC codes/I2t codes/i2t_SSCB_with_syscfg/CPU1_FLASH/syscfg/c2000ware_libraries.obj
DSP+PIC codes/UVLO/CPU1_RAM/device/F2837xD_CodeStartBranch.obj
DSP+PIC codes/UVLO/CPU1_RAM/i2t_SSCB_syscfg.obj
DSP+PIC codes/UVLO/CPU1_RAM/syscfg/board.obj
PCB files/Footprints&symbols/TC4432VOA/TC4432VOA.step
DSP+PIC codes/I2t codes/i2t_SSCB_with_syscfg/CPU1_FLASH/device/F2837xD_CodeStartBranch.obj
DSP+PIC codes/I2t codes/i2t_SSCB_with_syscfg/CPU1_FLASH/syscfg/board.obj
DSP+PIC codes/UVLO/CPU1_RAM/device/device.obj
DSP+PIC codes/UVLO/CPU1_RAM/syscfg/c2000ware_libraries.obj
PCB files/Footprints&symbols/7461057/7461057.stp
PCB files/Footprints&symbols/push pull Transformer/760390014.stp
Solidworks busbar/busbar.SLDDRW
Solidworks busbar/busbar_dec10.DWG
Solidworks busbar/modular_busbar.SLDDRW
