EE23DP003/eFuse/Results/Efficiency/Screen_20231229_132015.png

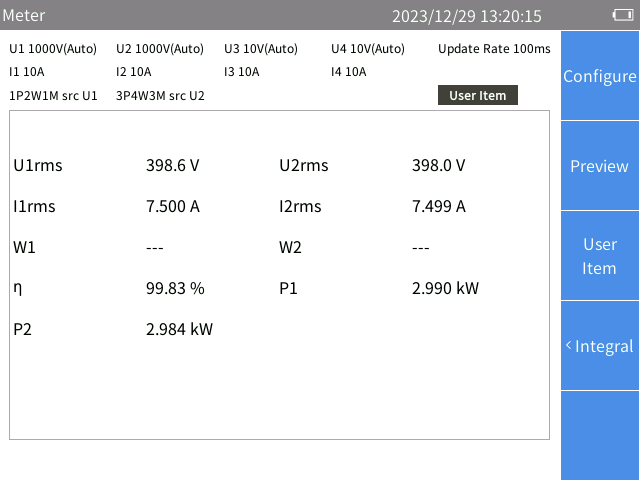
Results/Efficiency/Screen_20231229_132015.png
