EE23DP003/eFuse/Results/Efficiency/Screen_20231230_155959.png

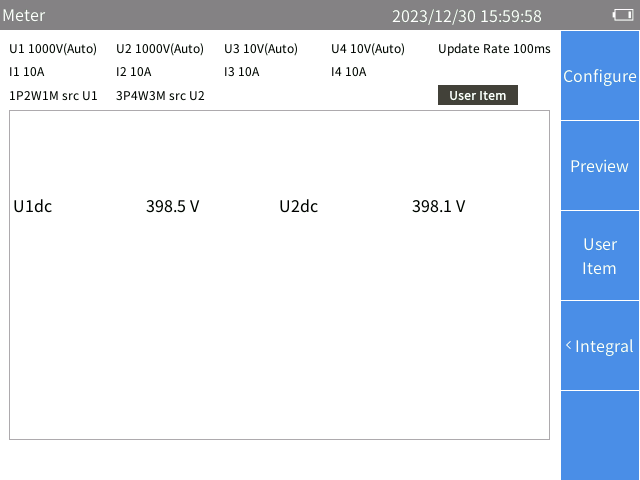
Results/Efficiency/Screen_20231230_155959.png
