EE23DP003/eFuse/Results/Fixed time modular/tek00161.png

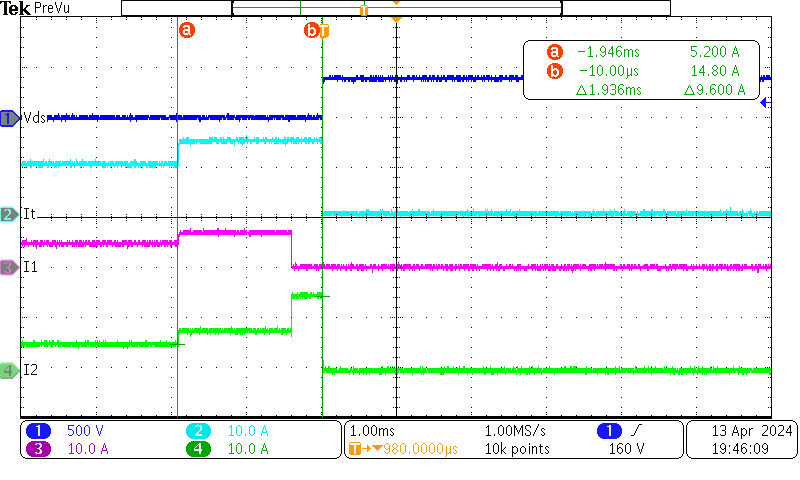
Results/Fixed time modular/tek00161.png
