EE23DP003/eFuse/Results/Fixed time modular/tek00162.png

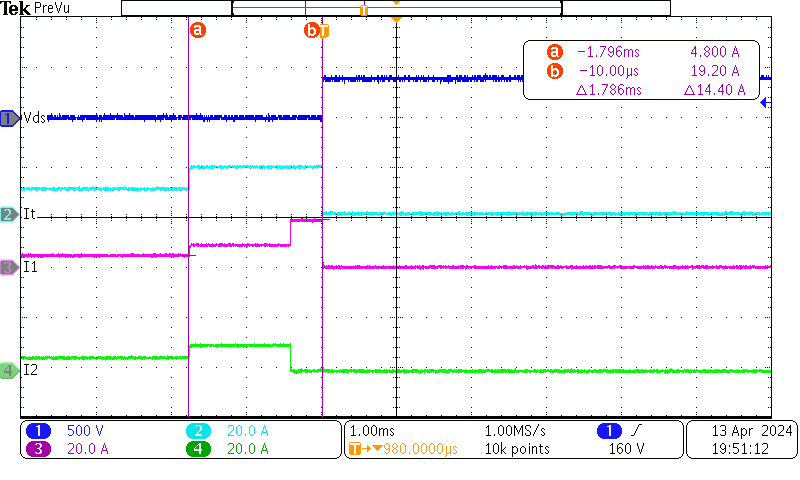
Results/Fixed time modular/tek00162.png
