EE23DP003/eFuse/Results/Fixed time modular/tek00164.png

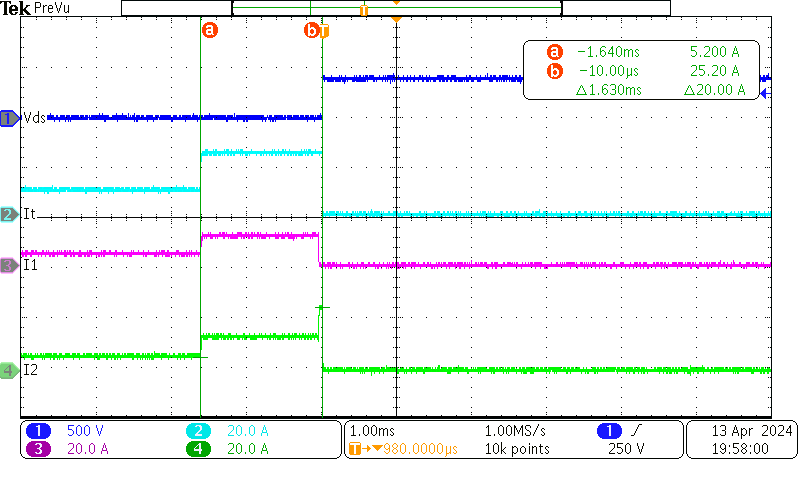
Results/Fixed time modular/tek00164.png
