EE23DP003/eFuse/Results/fixed time tripping/tek00133.png

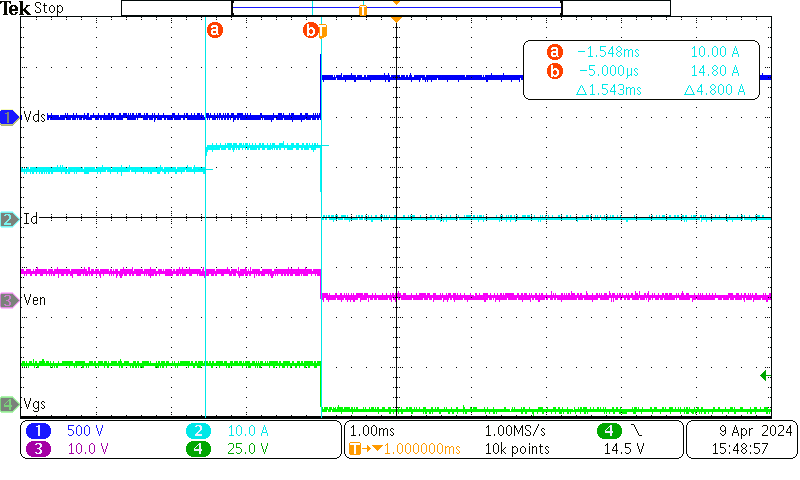
Results/fixed time tripping/tek00133.png
