EE23DP003/eFuse/Results/fixed time tripping/tek00134.png

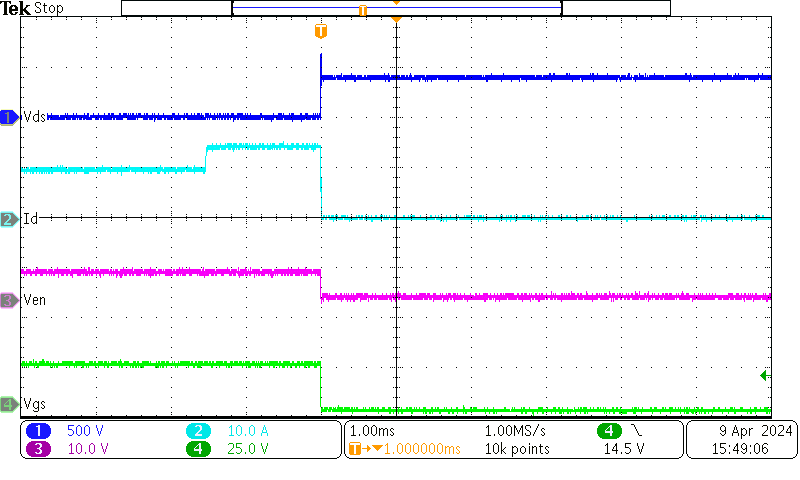
Results/fixed time tripping/tek00134.png
