EE23DP003/eFuse/Results/fixed time tripping/tek00135.png

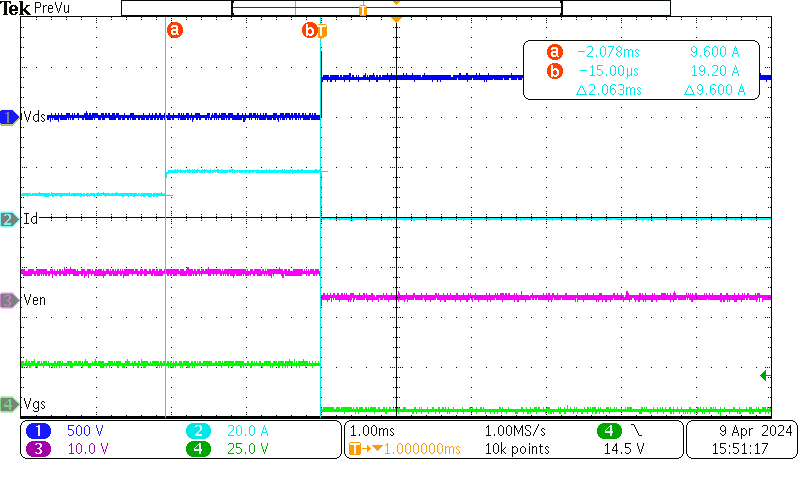
Results/fixed time tripping/tek00135.png
