EE23DP003/eFuse/Results/fixed time tripping/tek00136.png

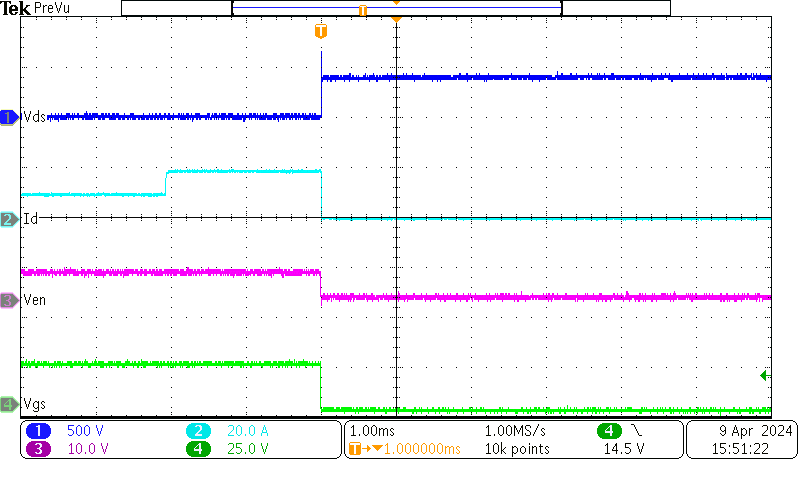
Results/fixed time tripping/tek00136.png
