EE23DP003/eFuse/Results/I2T back to normal current/tek00078.png

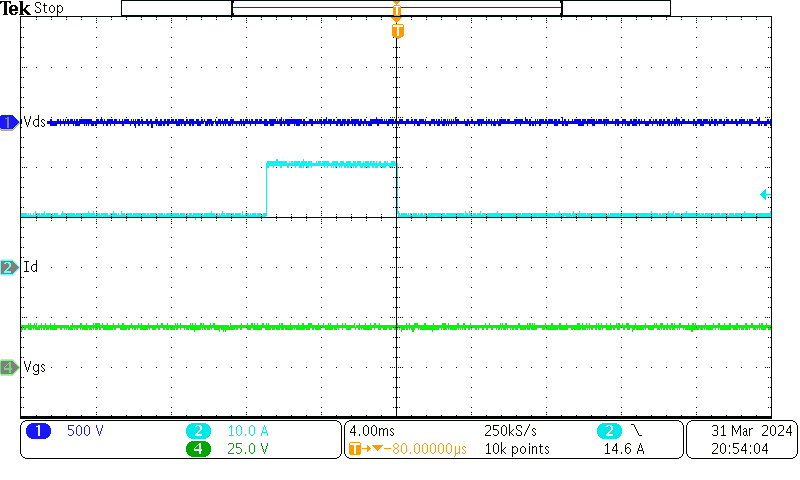
Results/I2T back to normal current/tek00078.png
