EE23DP003/eFuse/Results/I2T matlab/I2T_matlab.jpg

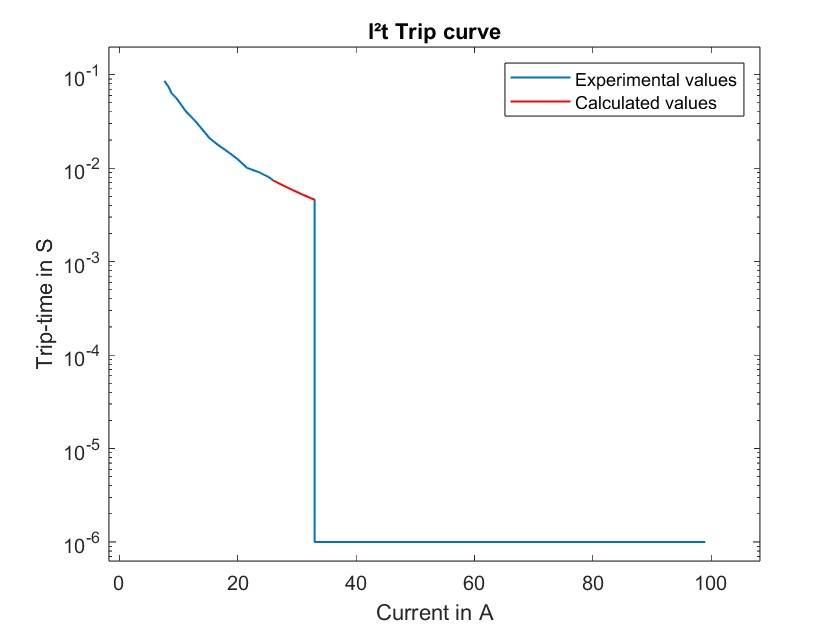
Results/I2T matlab/I2T_matlab.jpg
