EE23DP003/eFuse/Results/I2T modular/tek00045.png

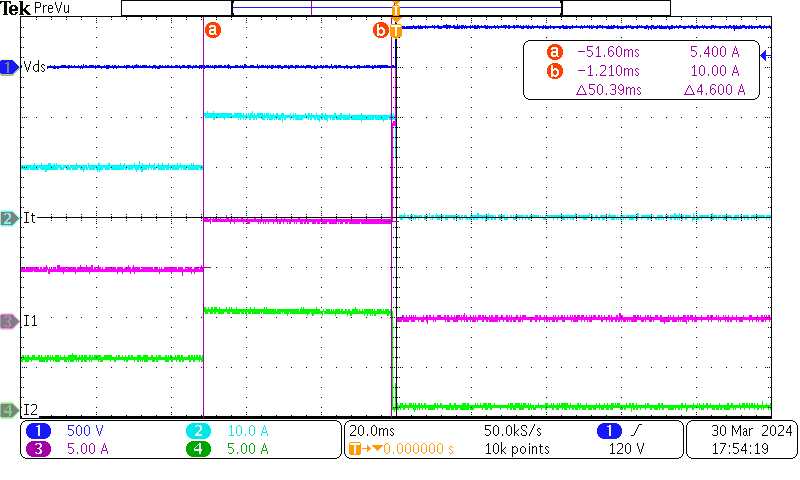
Results/I2T modular/tek00045.png
