EE23DP003/eFuse/Results/I2T modular/tek00049.png

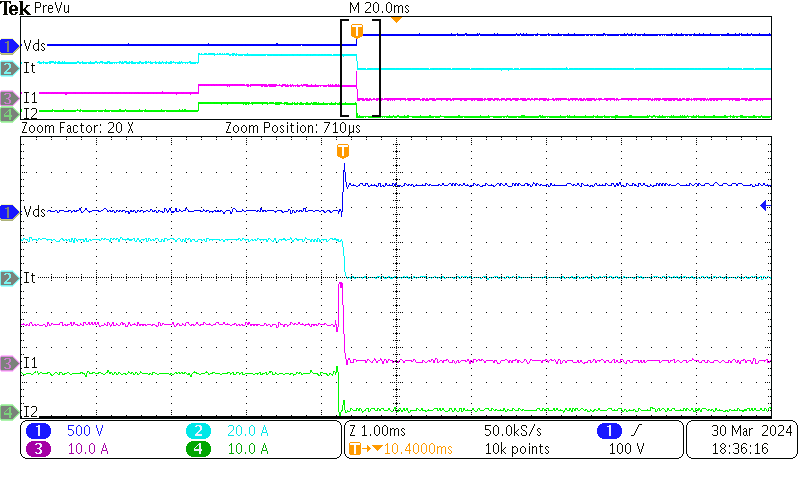
Results/I2T modular/tek00049.png
