EE23DP003/eFuse/Results/I2T modular/tek00053.png

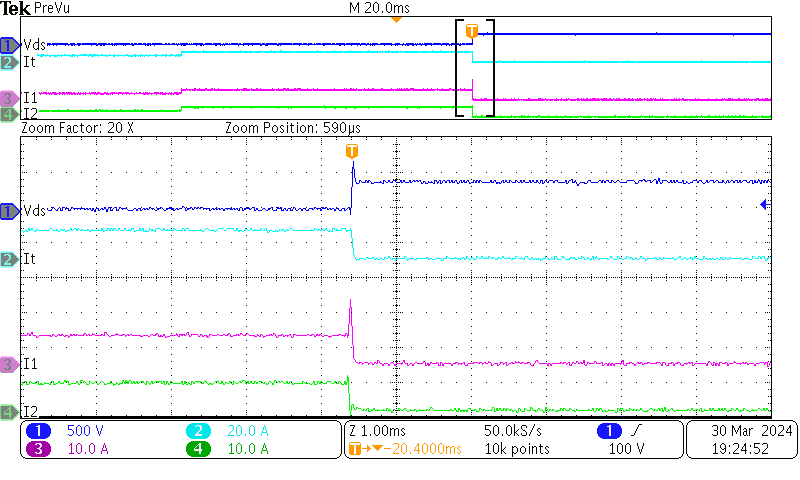
Results/I2T modular/tek00053.png
