EE23DP003/eFuse/Results/I2T single module/tek00034.png

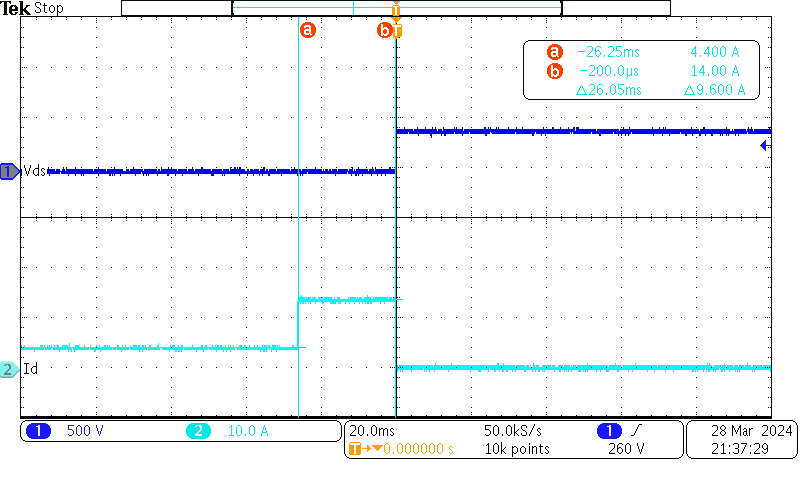
Results/I2T single module/tek00034.png
