EE23DP003/eFuse/Results/Modular shortcircuit/tek00147.png

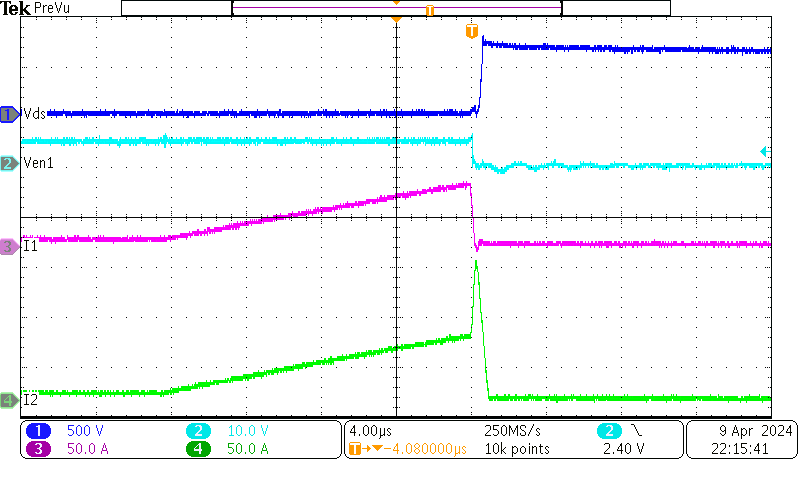
Results/Modular shortcircuit/tek00147.png
