EE23DP003/eFuse/Results/Modular shortcircuit/tek00149.png

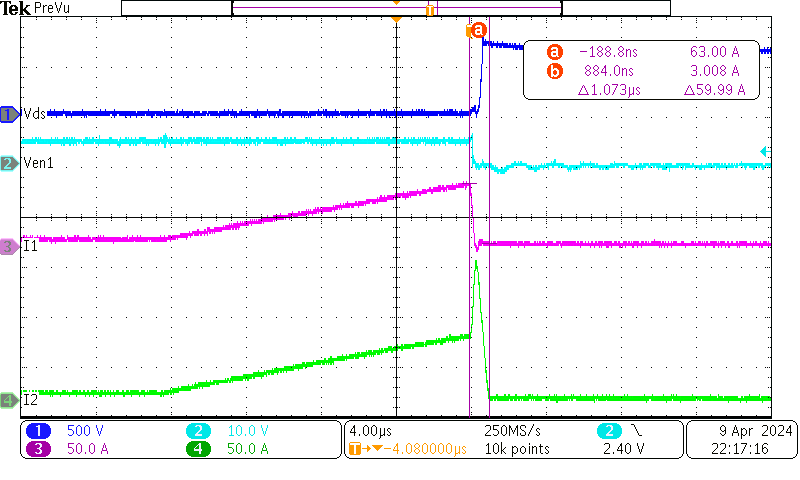
Results/Modular shortcircuit/tek00149.png
