EE23DP003/eFuse/Results/Modular shortcircuit/tek00151.png

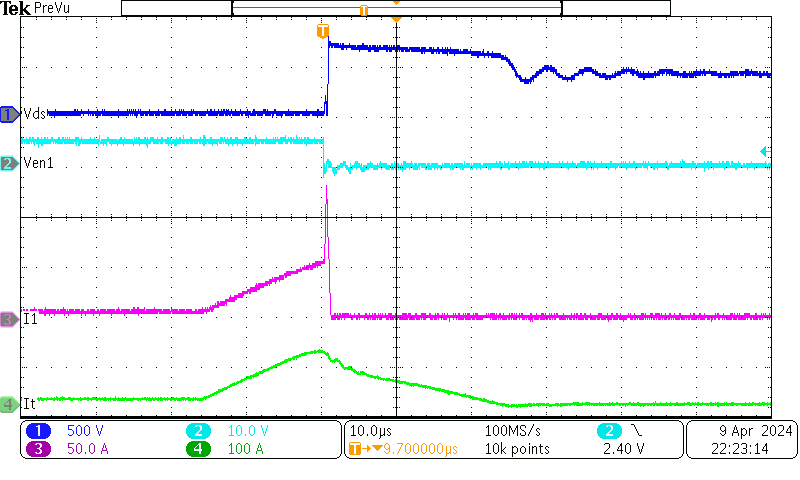
Results/Modular shortcircuit/tek00151.png
