EE23DP003/eFuse/Results/Modular shortcircuit/tek00153.png

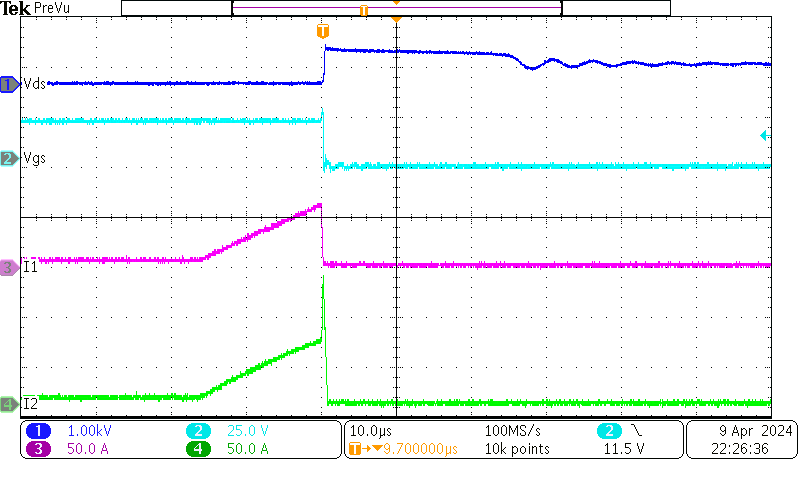
Results/Modular shortcircuit/tek00153.png
