EE23DP003/eFuse/Results/Modular shortcircuit/tek00154.png

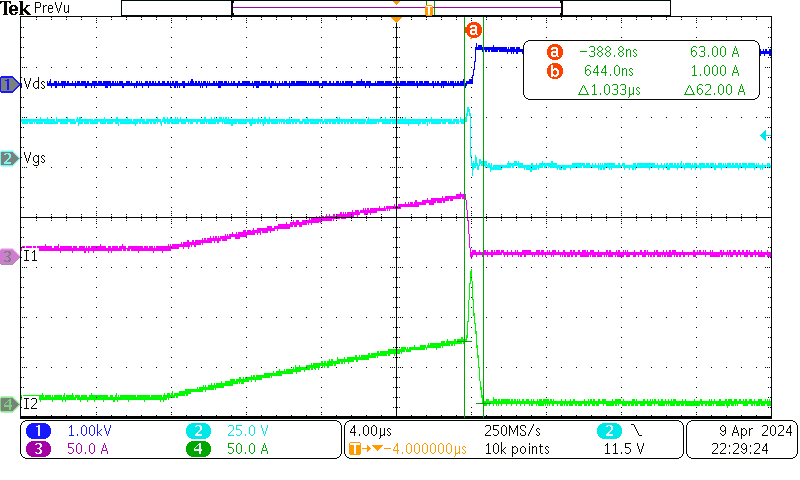
Results/Modular shortcircuit/tek00154.png
