EE23DP003/eFuse/Results/Modular shortcircuit/tek00155.png

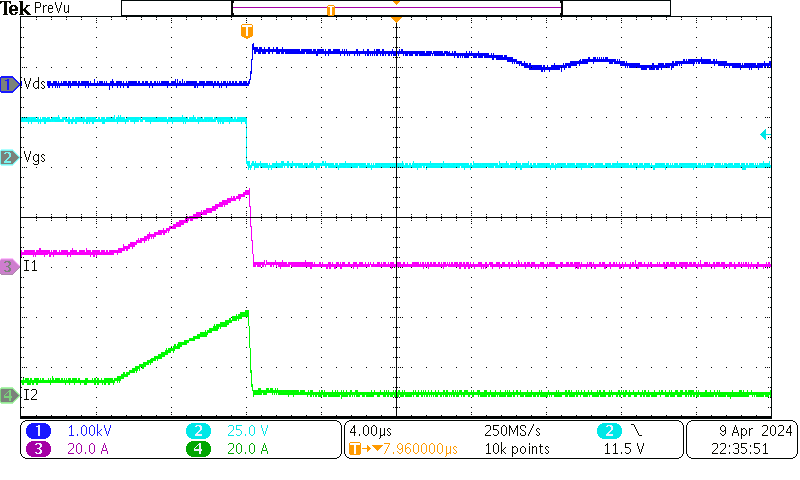
Results/Modular shortcircuit/tek00155.png
