EE23DP003/eFuse/Results/Modular shortcircuit/tek00156.png

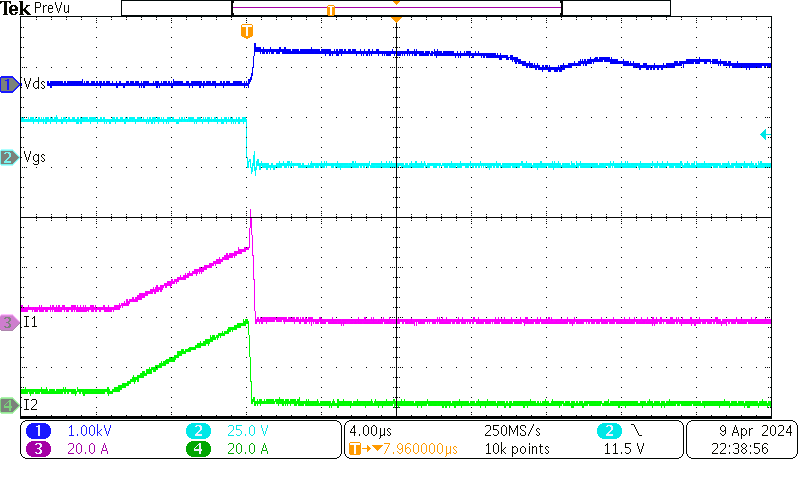
Results/Modular shortcircuit/tek00156.png
