EE23DP003/eFuse/Results/Modular shortcircuit/tek00157.png

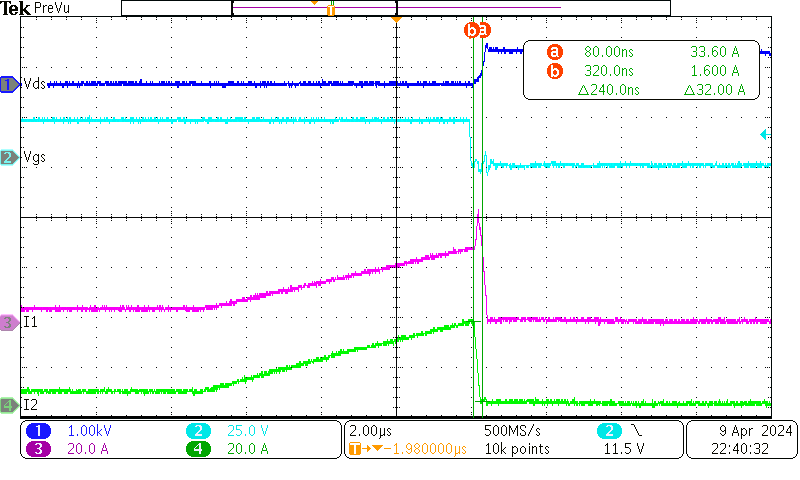
Results/Modular shortcircuit/tek00157.png
