EE23DP003/eFuse/Results/Modular shortcircuit/tek00158.png

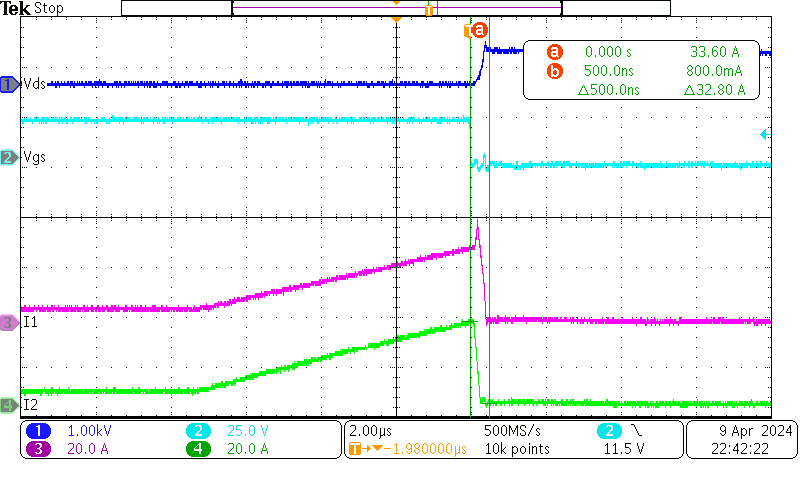
Results/Modular shortcircuit/tek00158.png
