EE23DP003/eFuse/Results/Modular shortcircuit/tek00159.png

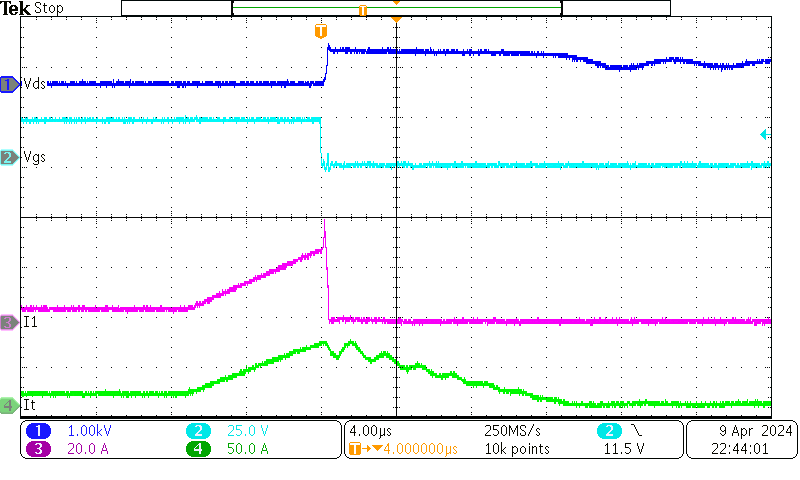
Results/Modular shortcircuit/tek00159.png
