EE23DP003/eFuse/Results/Short-circuit with total current/tek00118.png

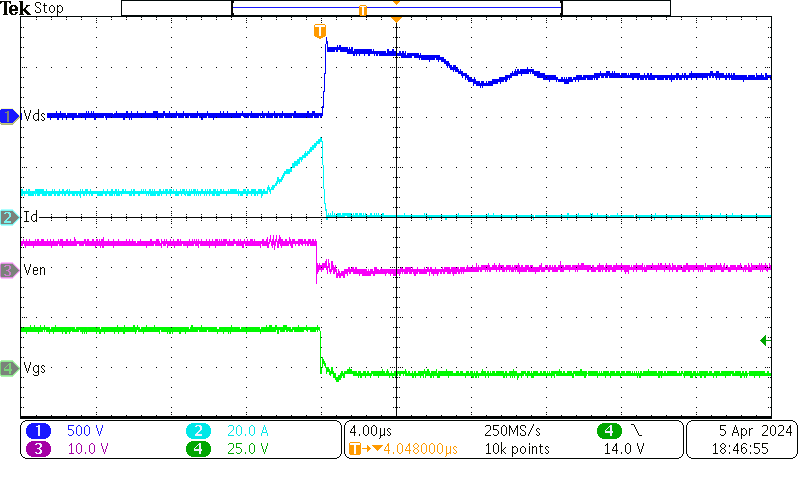
Results/Short-circuit with total current/tek00118.png
