EE23DP003/eFuse/Results/Short-circuit with total current/tek00120.png

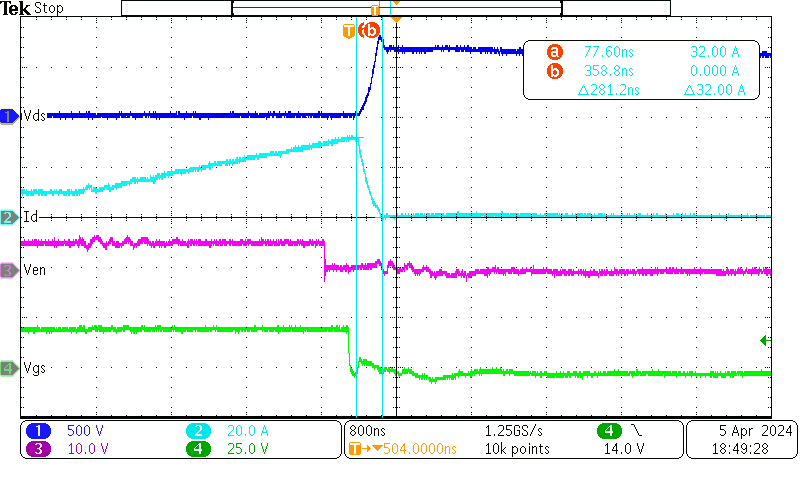
Results/Short-circuit with total current/tek00120.png
