EE23DP003/eFuse/Results/Short-circuit with total current/tek00124.png

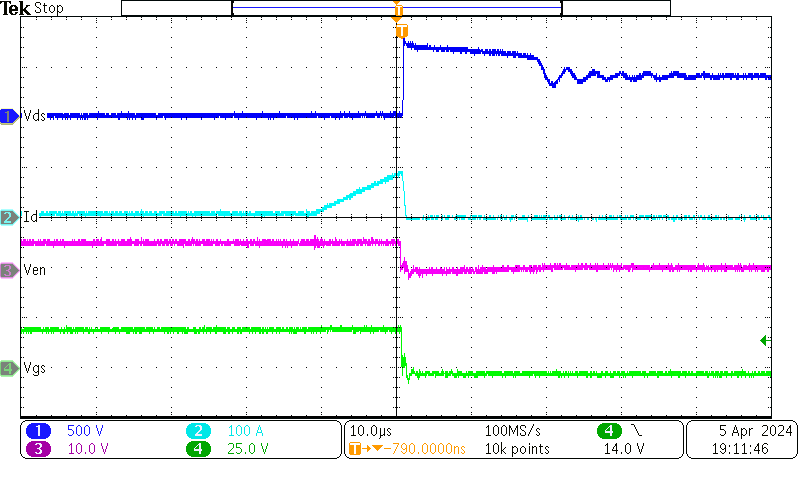
Results/Short-circuit with total current/tek00124.png
