EE23DP003/eFuse/Results/Shortcircuit during overcurrent/tek00126.png

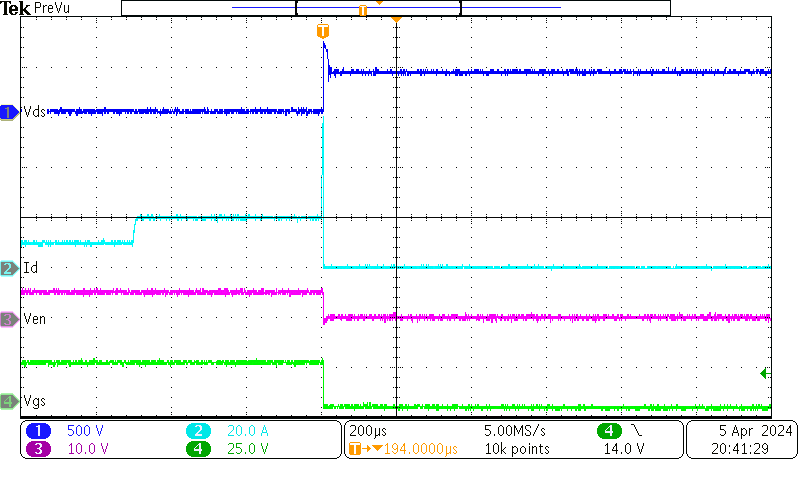
Results/Shortcircuit during overcurrent/tek00126.png
