EE23DP003/eFuse/Results/Shortcircuit during overcurrent/tek00127.png

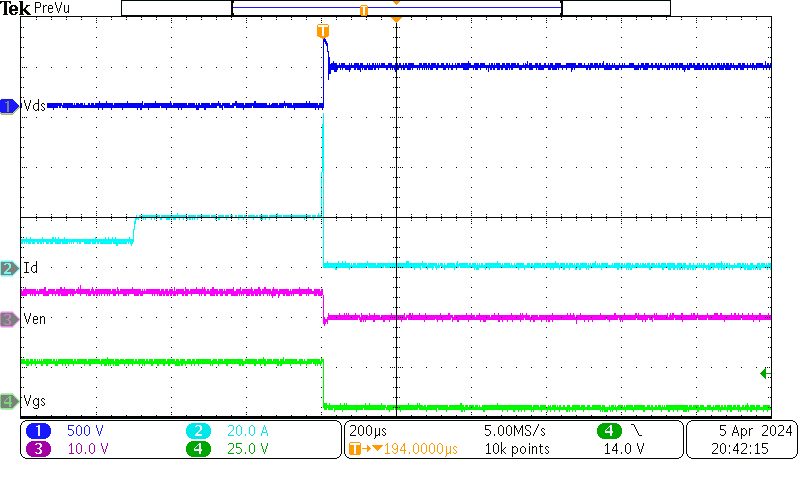
Results/Shortcircuit during overcurrent/tek00127.png
