EE23DP003/eFuse/Results/UVLO/tek00130.png

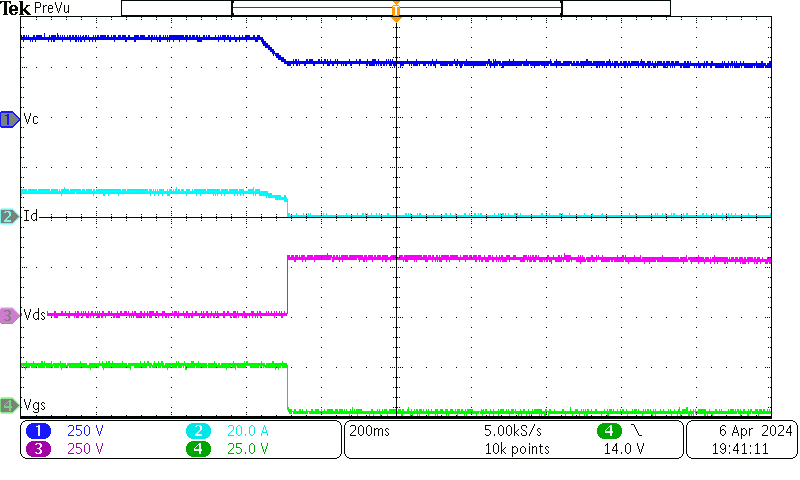
Results/UVLO/tek00130.png
