EE23DP003/eFuse/Results/UVLO/tek00131.png

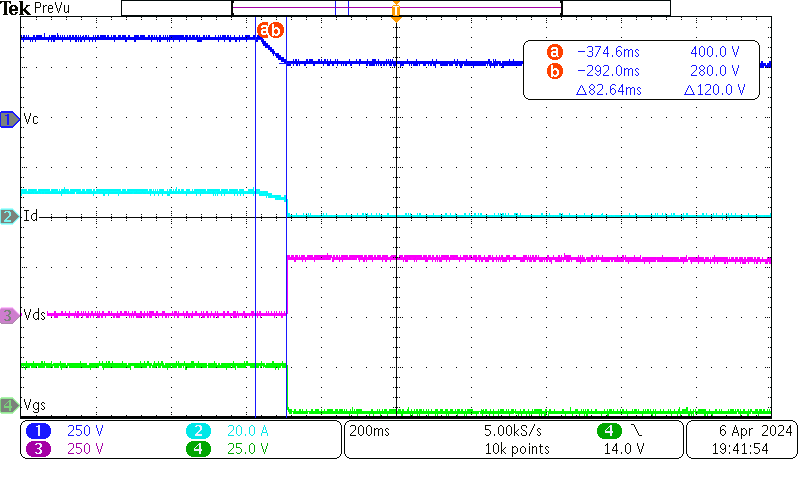
Results/UVLO/tek00131.png
