EE23DP003/eFuse/Results/UVLO/tek00132.png

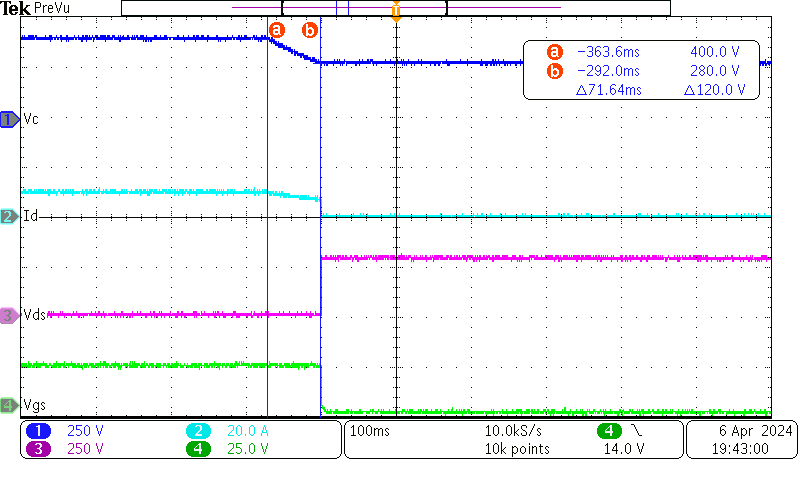
Results/UVLO/tek00132.png
