EE23DP003/eFuse/inkscape/diagrams/block_diagram.pdf

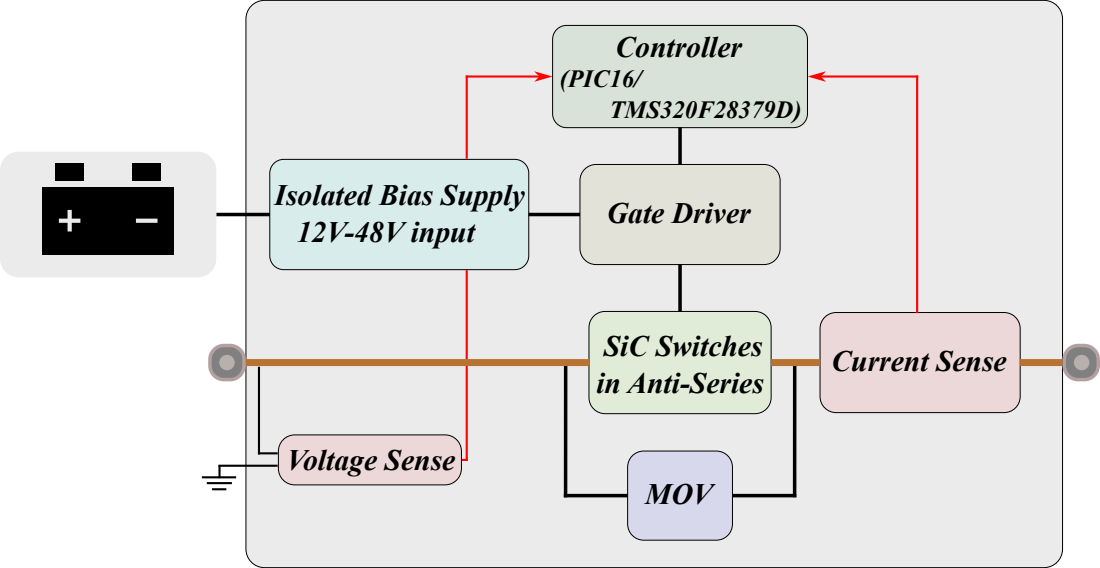
[picture p89: page 1]
MOV; Current Sense; Gate Driver; Voltage Sense; (PIC16/ TMS320F28379D); Controller

Isolated Bias Supply
12V-48V input

SiC Switches
in Anti-Series
