EE23DP003/eFuse/inkscape/diagrams/Circuit_diagram.pdf

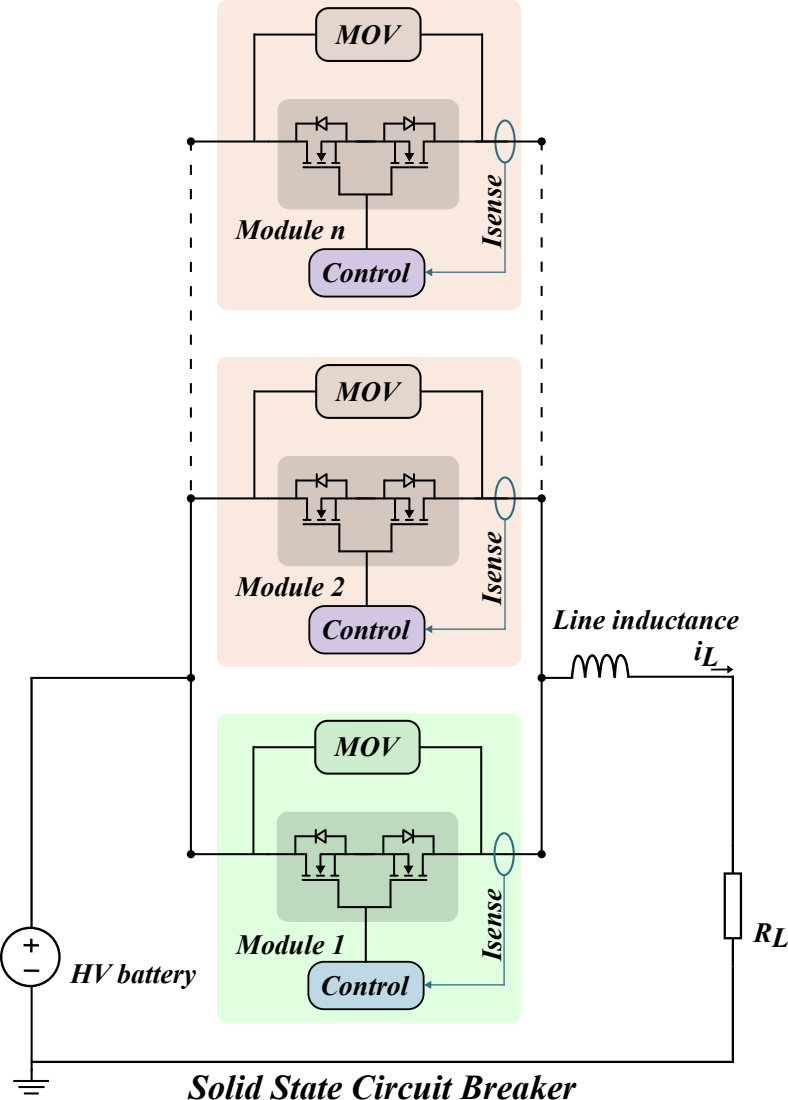
[picture p90: page 1]
Line inductance; Module 1; Module 2; HV battery; Isense; Control; MOV; Module n

Solid State Circuit Breaker
