EE23DP003/eFuse/inkscape/diagrams/HV-distribution.pdf

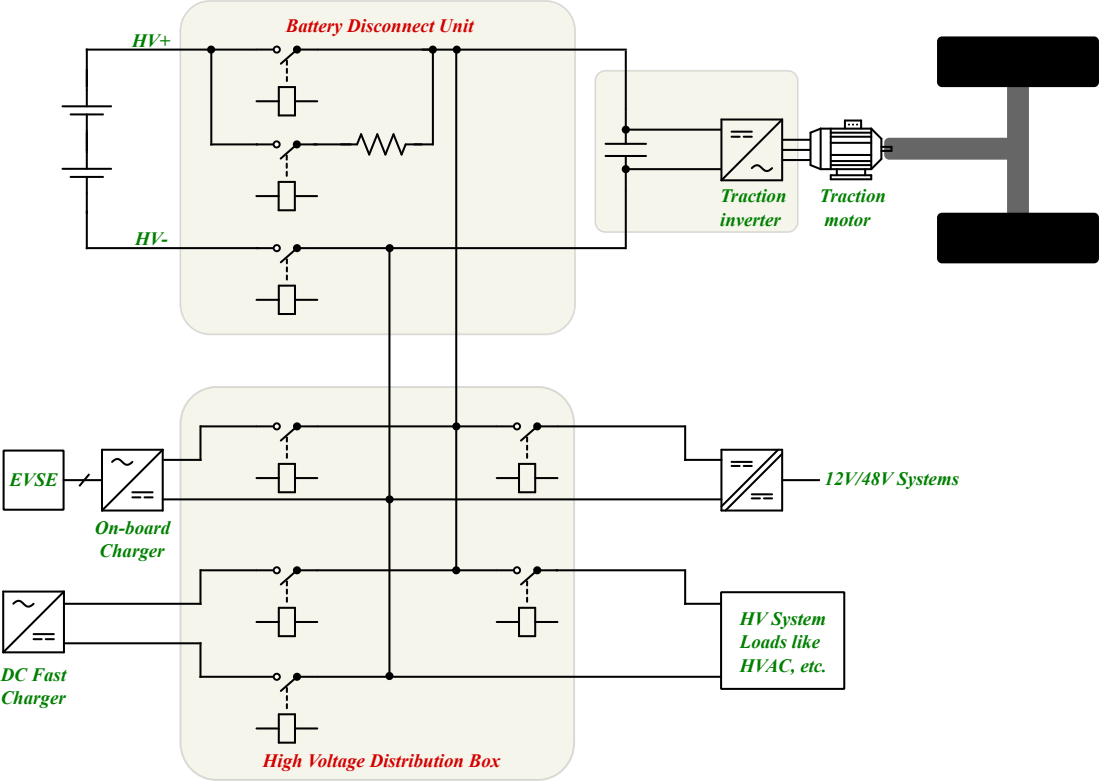
[picture p91: page 1]
EVSE; 12V/48V Systems; HV System Loads like; On-board Charger; Traction inverter; Traction motor

Battery Disconnect Unit

HVAC, etc. DC Fast
Charger

High Voltage Distribution Box
