EE23DP003/eFuse/inkscape/diagrams/I2T_working.pdf

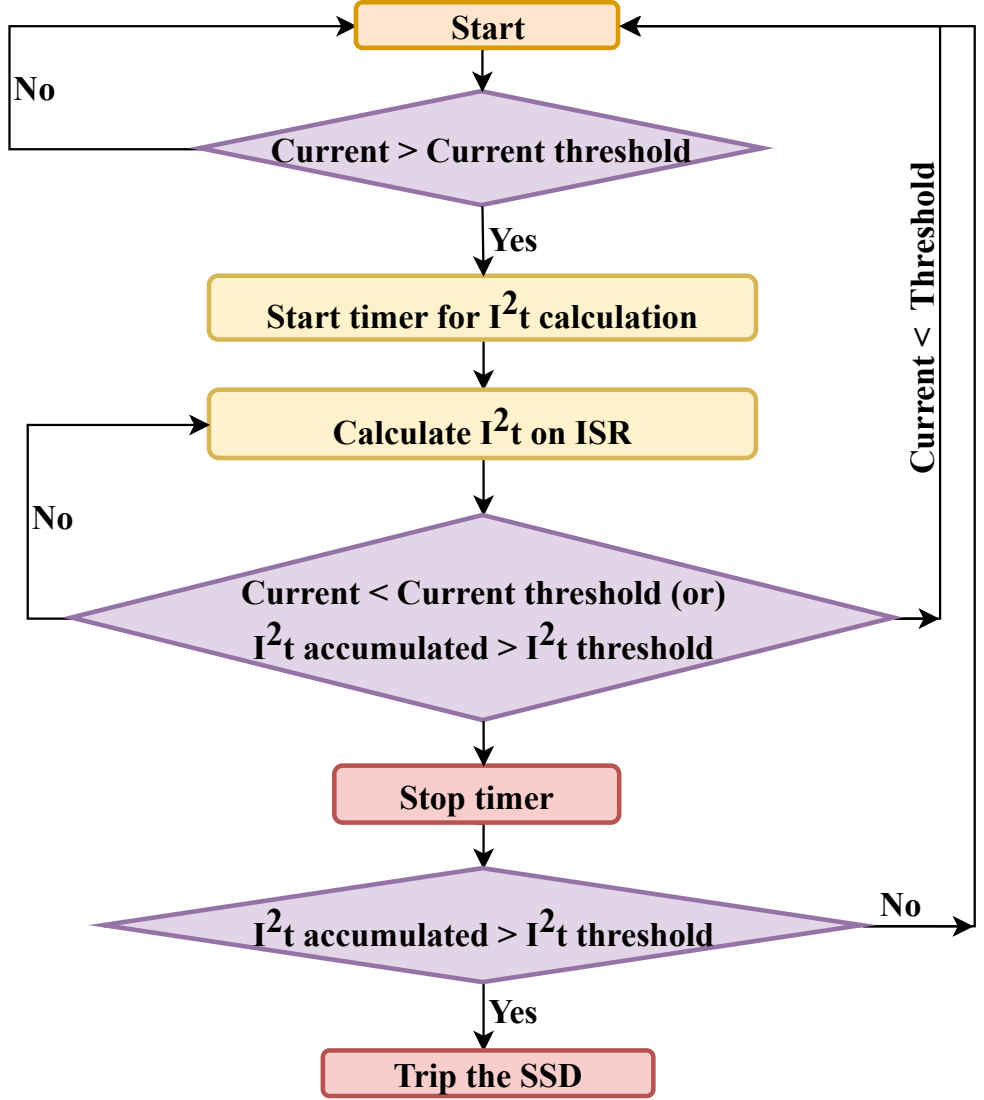
[picture p92: page 1]
Start; t calculation; Calculate I2 t on ISR; Stop timer; 2 t accumulated > I; t threshold; Current < Threshold; Current < Current threshold (or) I; t accumulated > I2; Yes

Current > Current threshold

Start timer for I2

Yes
Trip the SSD
