EE23DP003/eFuse/inkscape/diagrams/mode-1.pdf

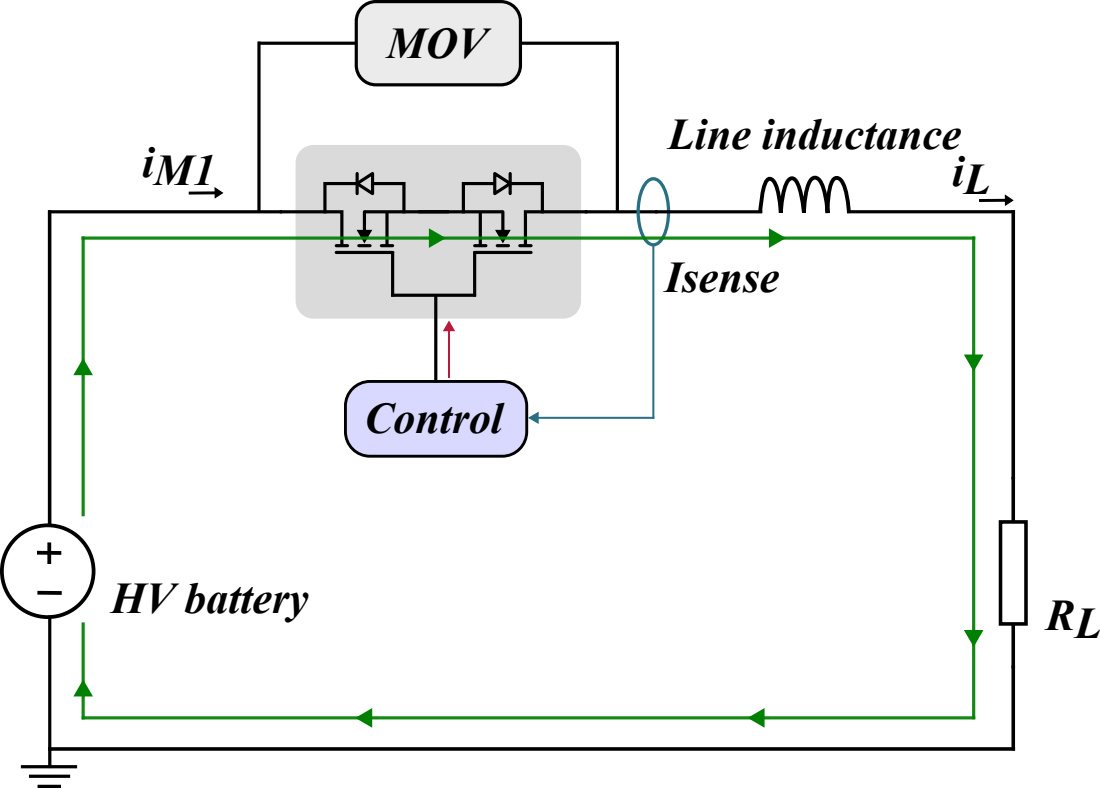
[picture p93: page 1]
Line inductance; HV battery; Isense; Control; MOV
