EE23DP003/eFuse/inkscape/diagrams/mode-2.pdf

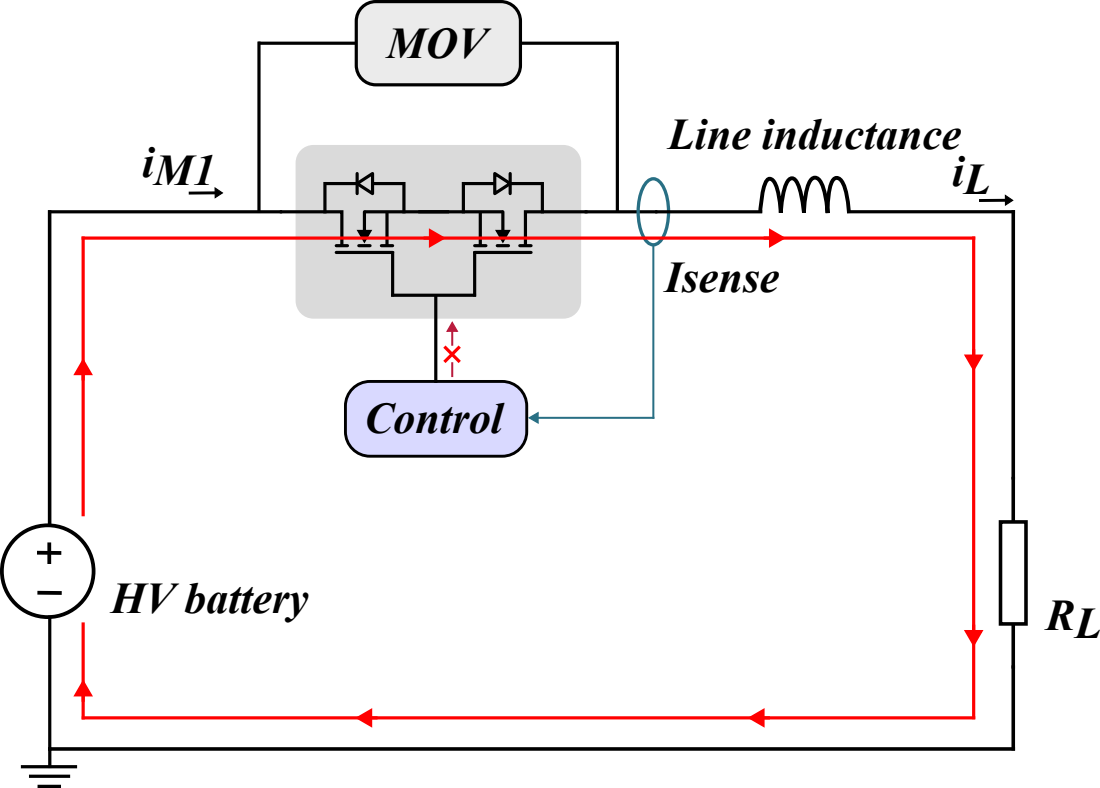
[picture p94: page 1]
Line inductance; HV battery; Isense; Control; MOV
