EE23DP003/eFuse/inkscape/diagrams/mode-3.pdf

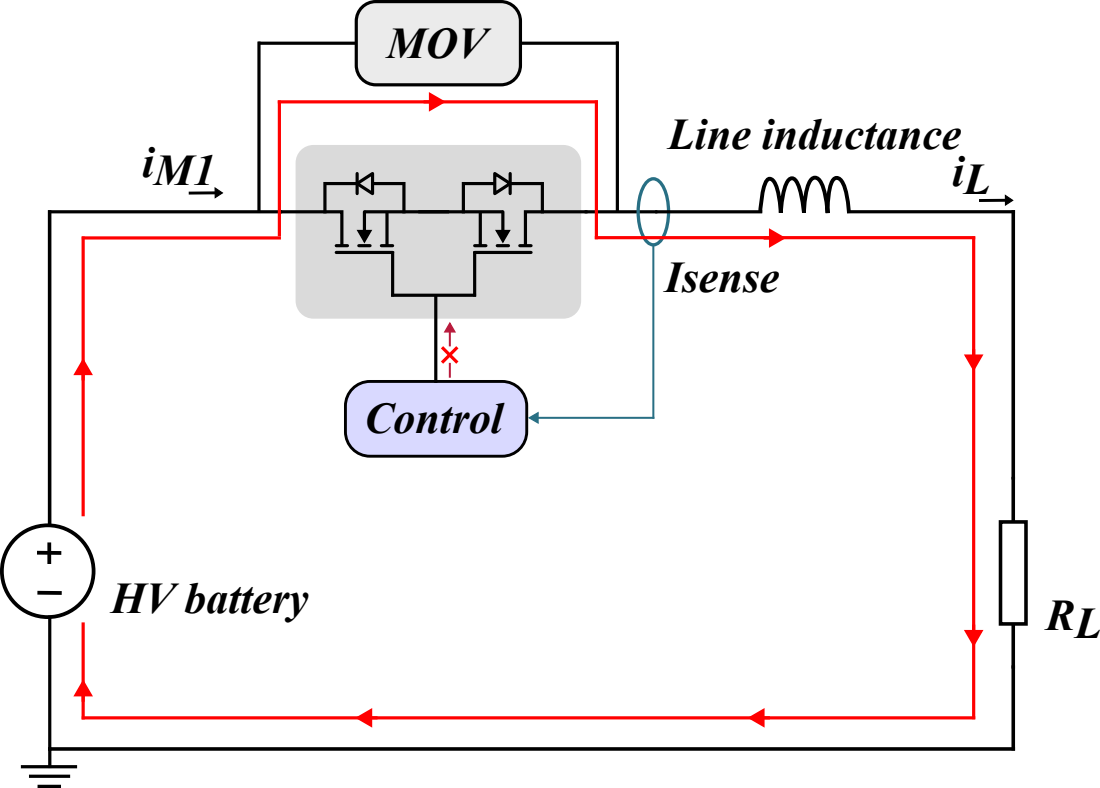
[picture p95: page 1]
Line inductance; HV battery; Isense; Control; MOV
