EE23DP003/eFuse/inkscape/diagrams/modular_connection.pdf

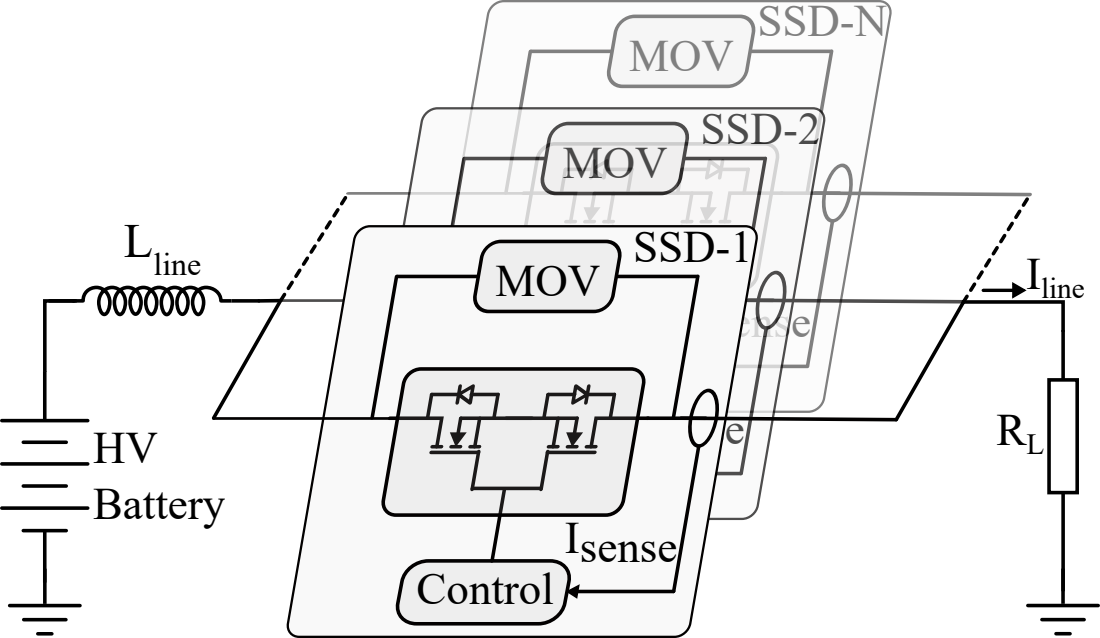
[picture p96: page 1]
SSD-N; MOV; Control; Isense; SSD-2; SSD-1; LIline; Battery Lline
