EE23DP003/eFuse/inkscape/diagrams/overall_working.pdf

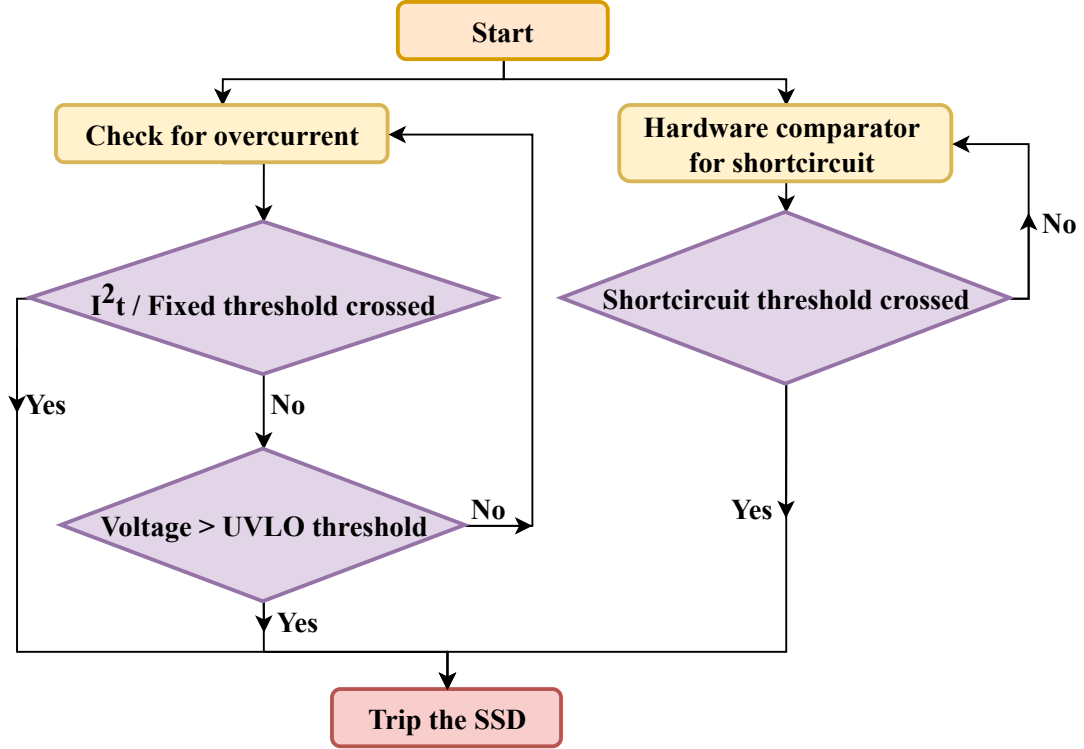
[picture p97: page 1]
Start; Check for overcurrent; Hardware comparator; for shortcircuit; Yes; t / Fixed threshold crossed; Shortcircuit threshold crossed

Voltage > UVLO threshold

Trip the SSD
