EE23DP003/eFuse/MATLAB/I2t Trip Curve.pdf

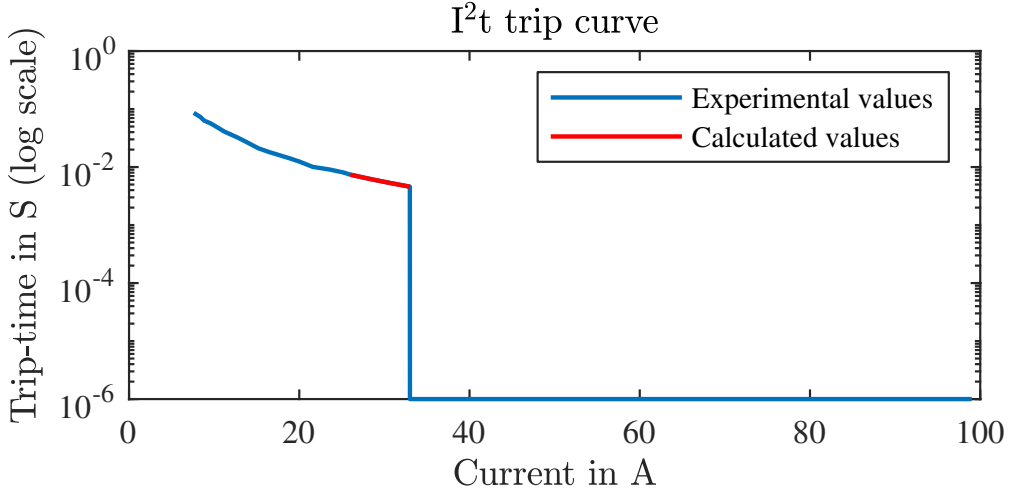
[picture p98: page 1]
Experimental values Calculated values
