EE23DP003/eFuse/MATLAB/i2t.pdf

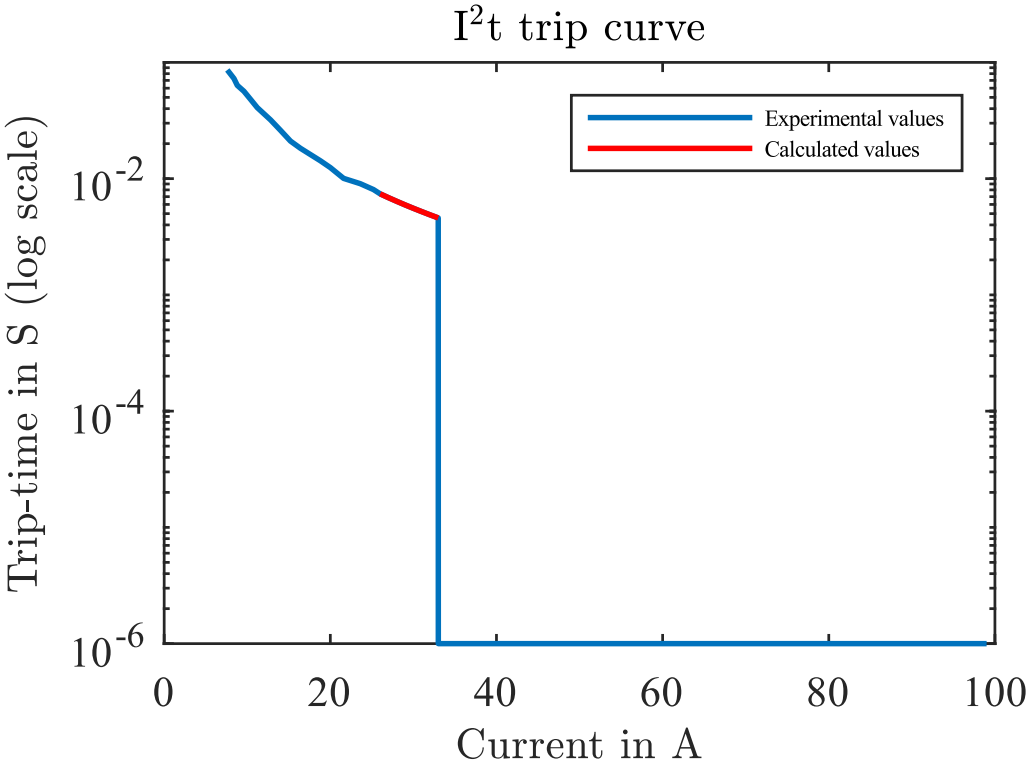
[picture p99: page 1]
