EE23DP003/eFuse/inkscape/diagrams/BlockDiagram.pdf

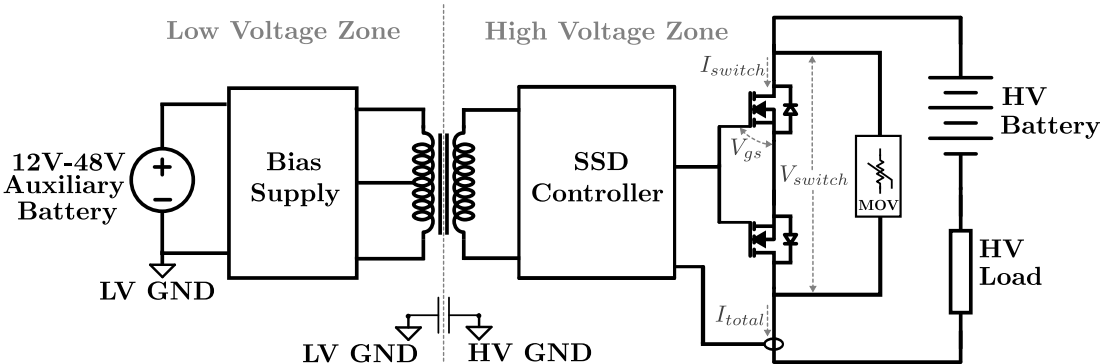
[picture p100: page 1]
