EE23DP003/eFuse/inkscape/diagrams/mode1.pdf

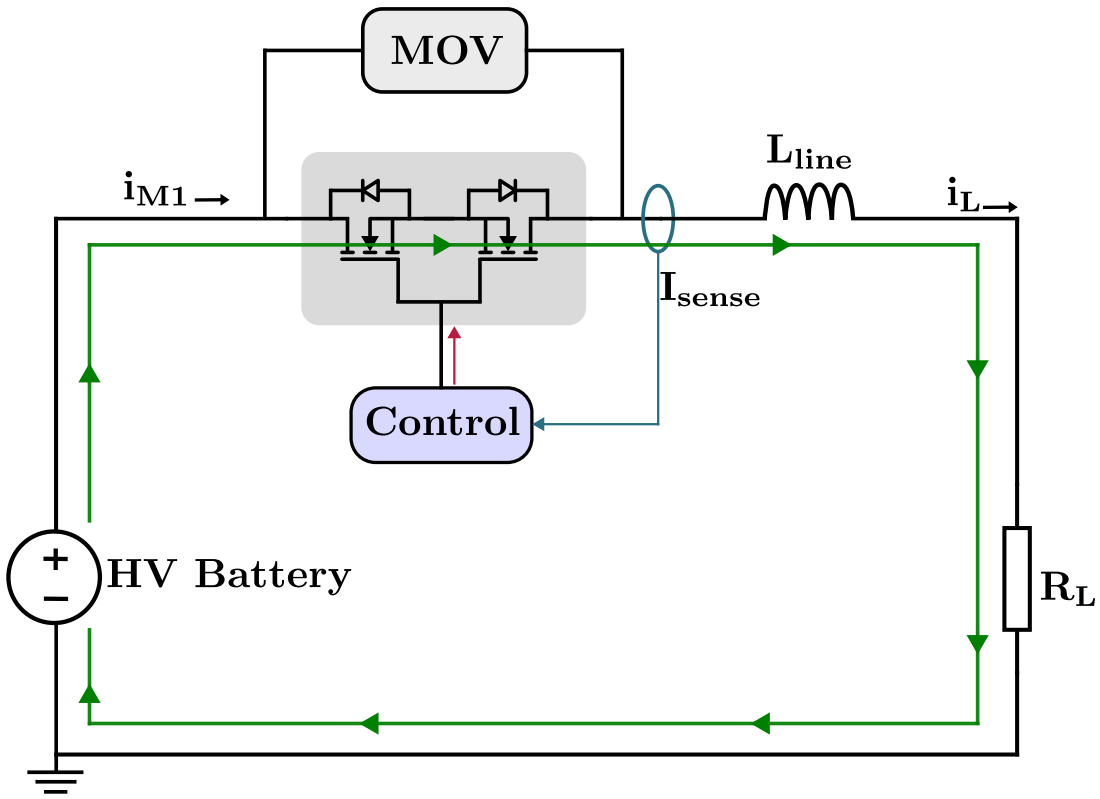
[picture p101: page 1]
