EE23DP003/eFuse/inkscape/diagrams/mode2.pdf

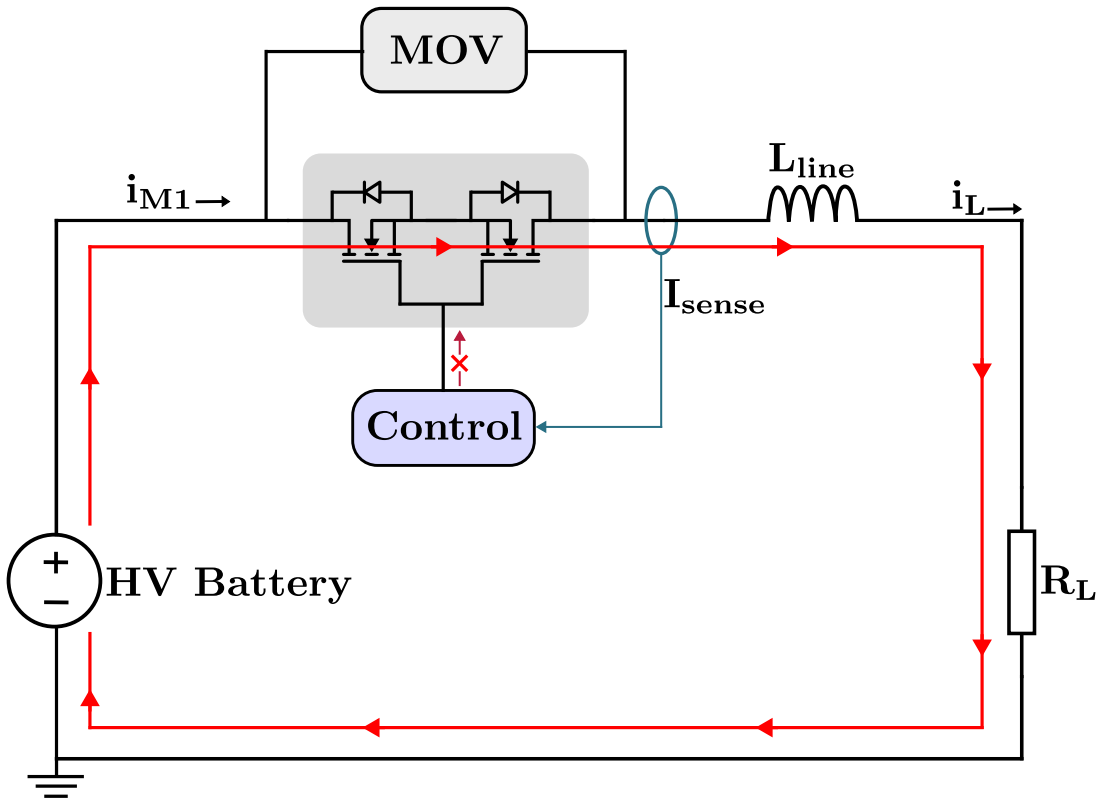
[picture p102: page 1]
