EE23DP003/eFuse/inkscape/diagrams/mode3.pdf

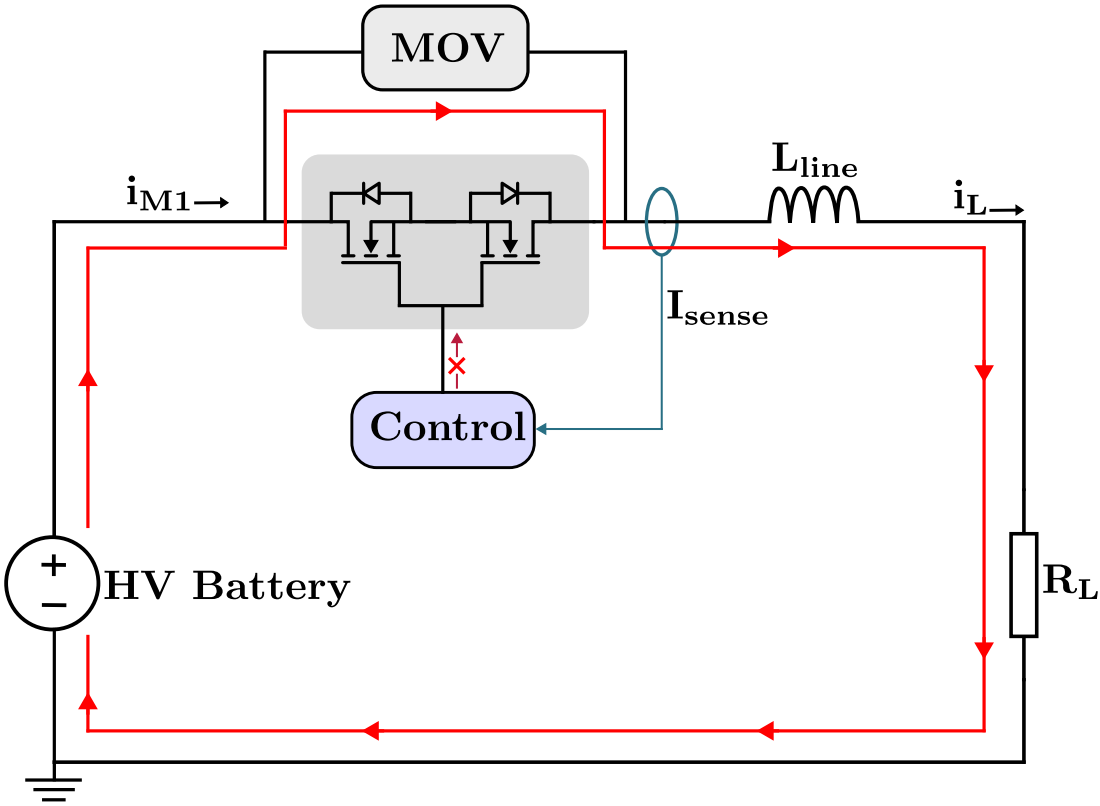
[picture p103: page 1]
