EE23DP003/eFuse/inkscape/diagrams/oc_sc_diagram.pdf

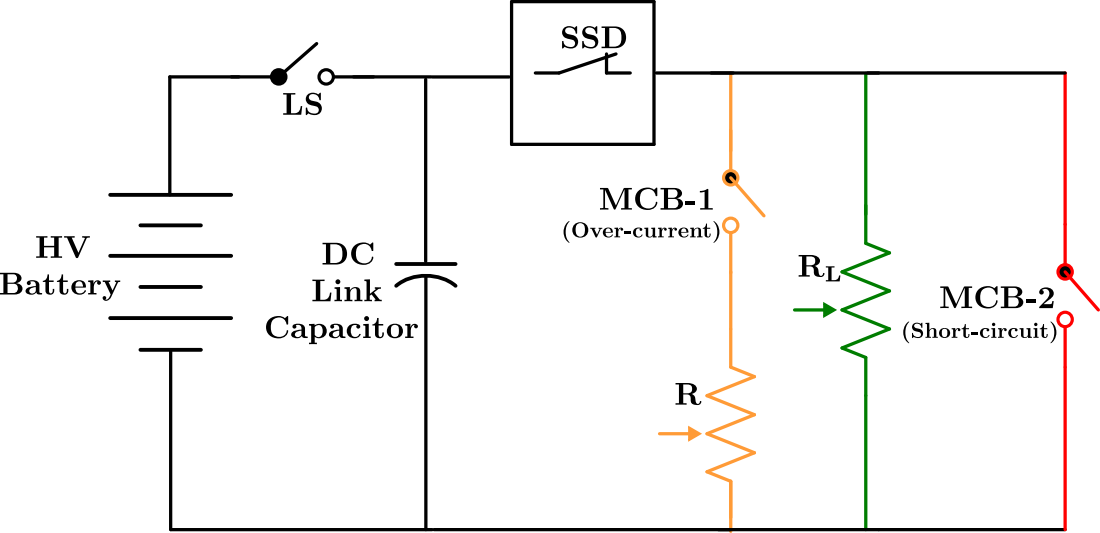
[picture p104: page 1]
