EE23DP003/eFuse/inkscape/Fixed time modular/fixed-time-modular-10-20A.pdf

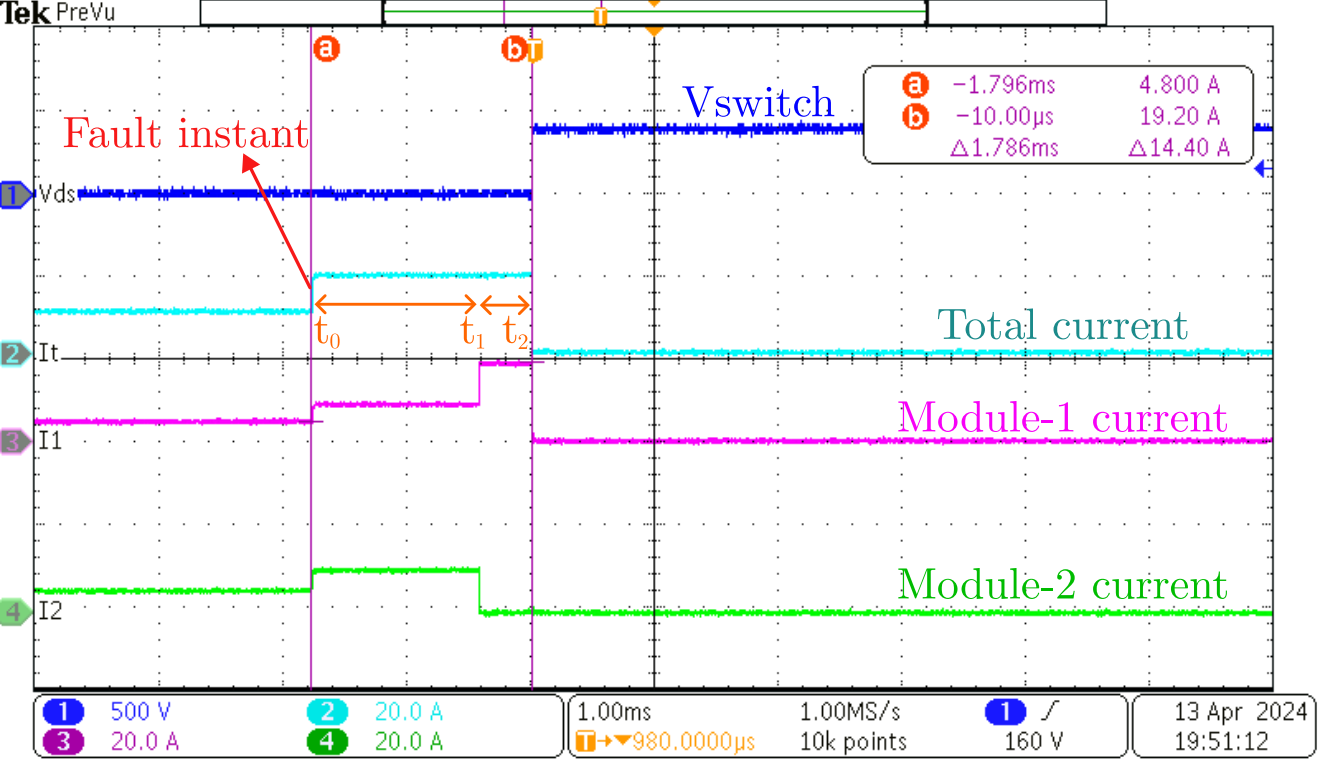
[picture p105: page 1]
