EE23DP003/eFuse/inkscape/Fixed time modular/fixed-time-modular-10-25A.pdf

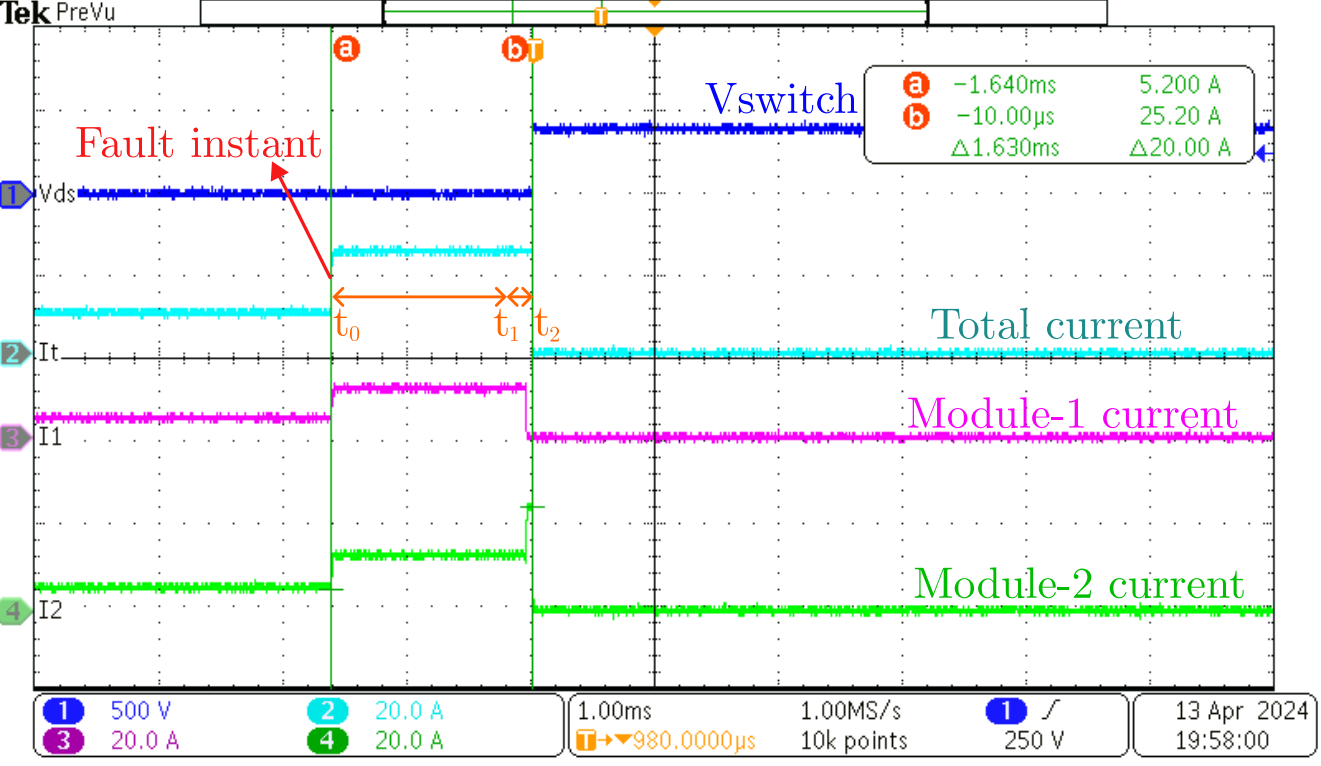
[picture p106: page 1]
