EE23DP003/eFuse/inkscape/Fixed time tripping/Fixed_time_tripping-10-15A.pdf

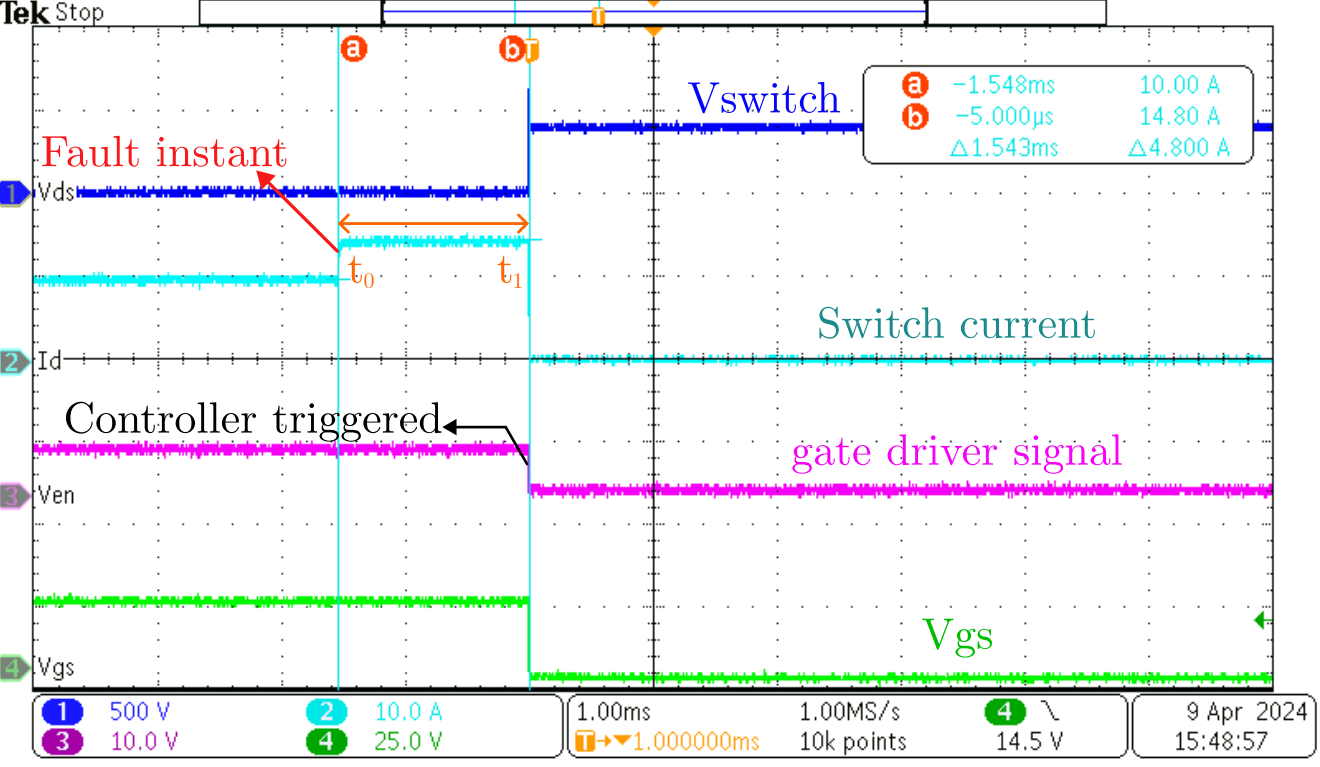
[picture p107: page 1]
