EE23DP003/eFuse/inkscape/I2T single module/i2T_single_module_4-11A.pdf

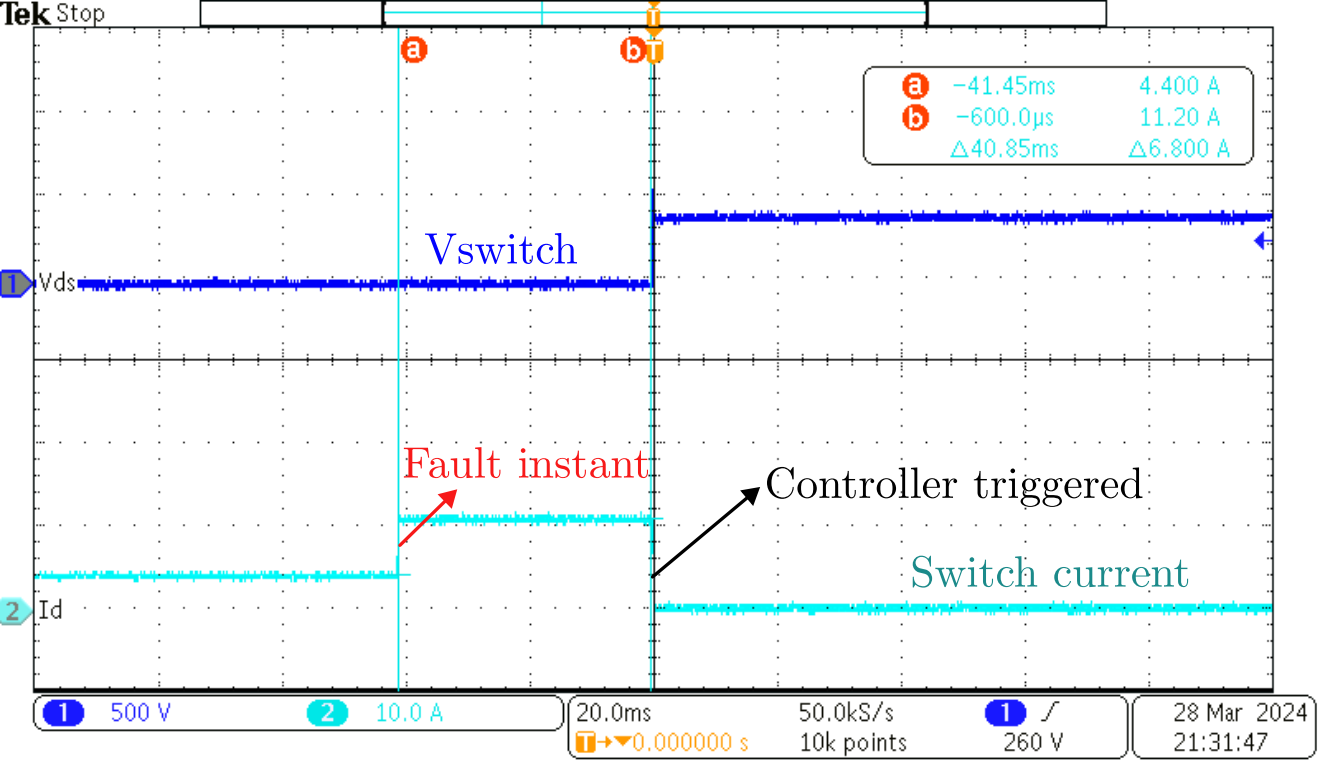
[picture p108: page 1]
