EE23DP003/eFuse/inkscape/I2T-modular/i2t_modular_10-16A.pdf

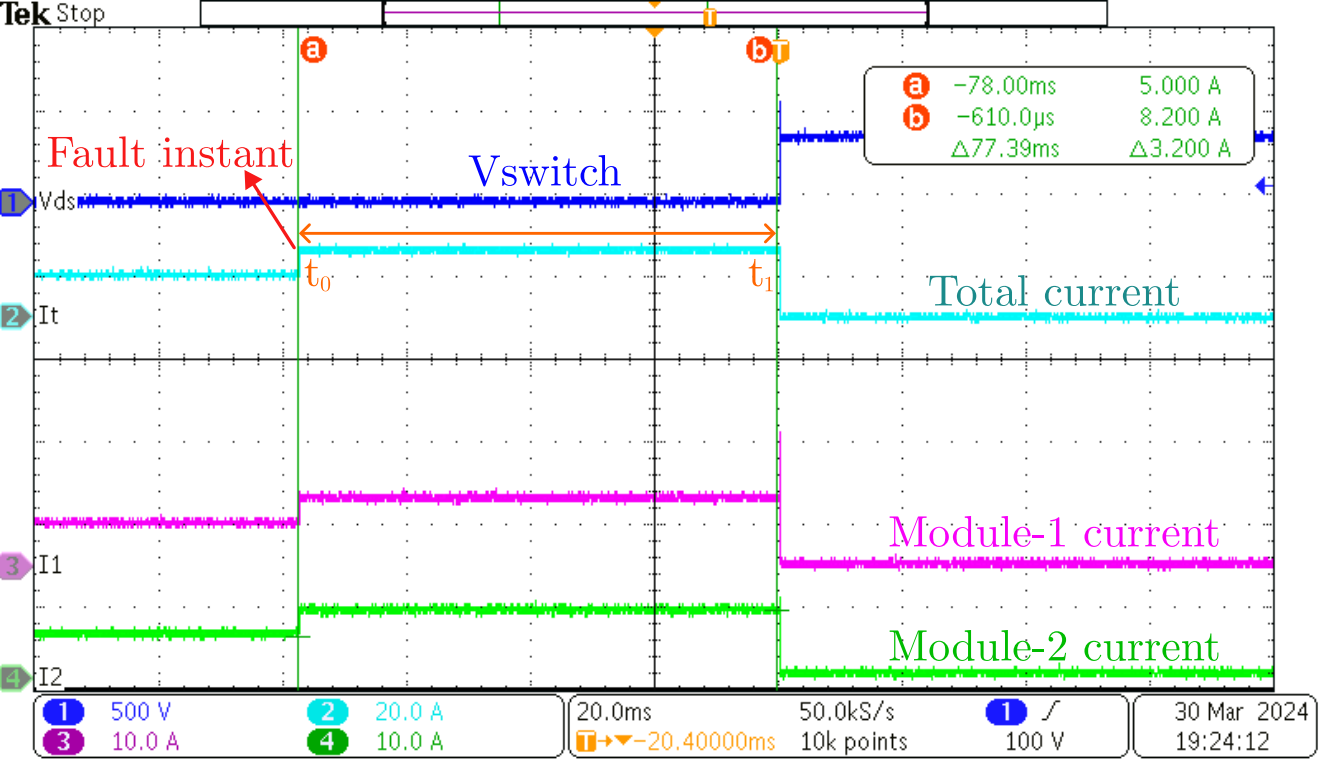
[picture p109: page 1]
