EE23DP003/eFuse/inkscape/Shortcircuit during overcurrent/shortcircuit_during_overcurrent.pdf

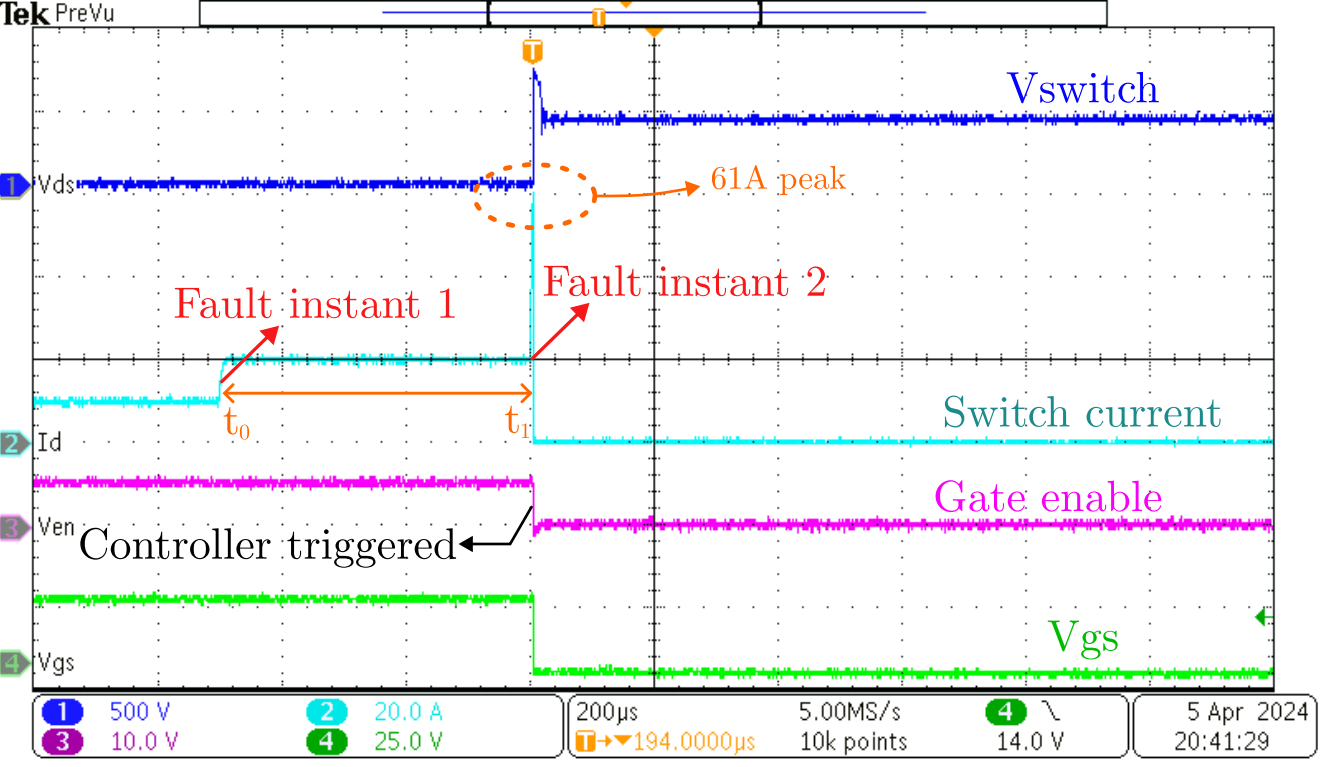
[picture p110: page 1]
