EE23DP003/eFuse/inkscape/Shortcircuit-Modular/modular-shortcircuit_33A_Ovsh.pdf

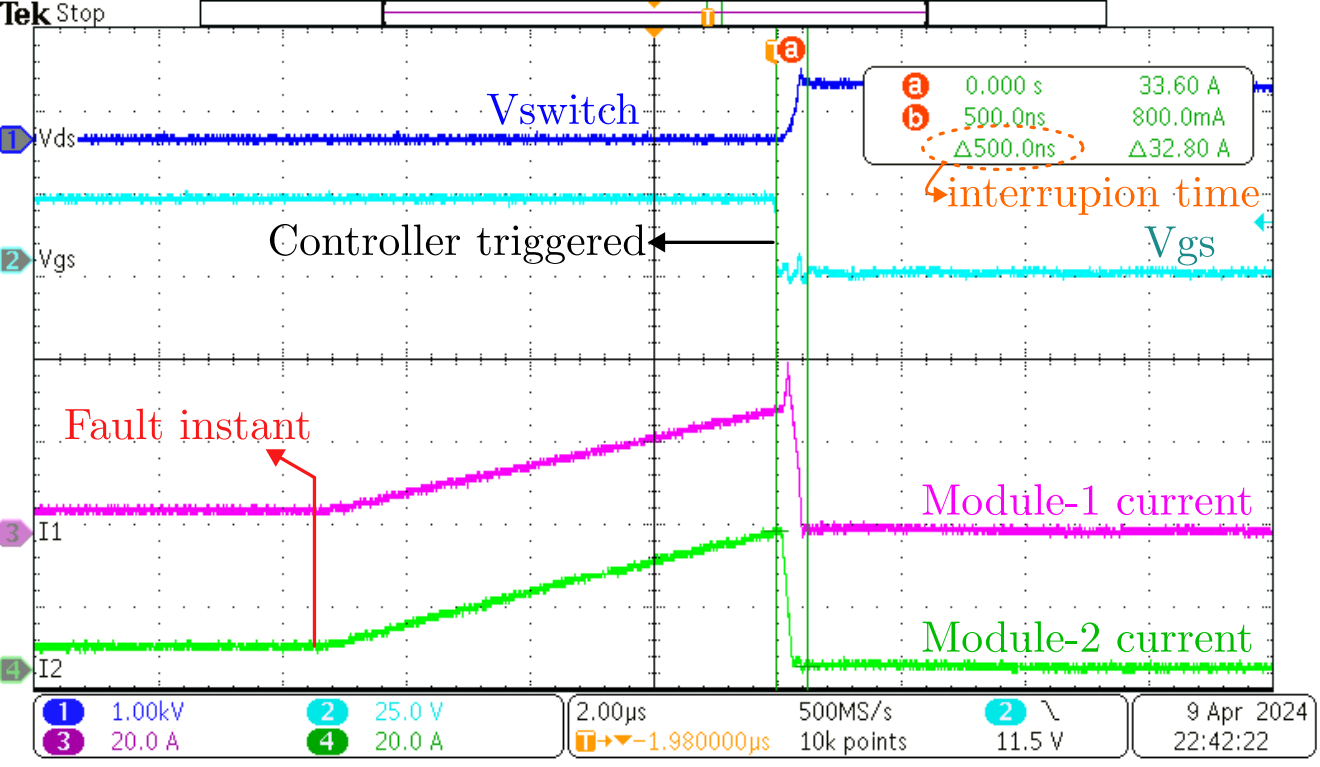
[picture p111: page 1]
