EE23DP003/eFuse/inkscape/Shortcircuit/shortcircuit_64A.pdf

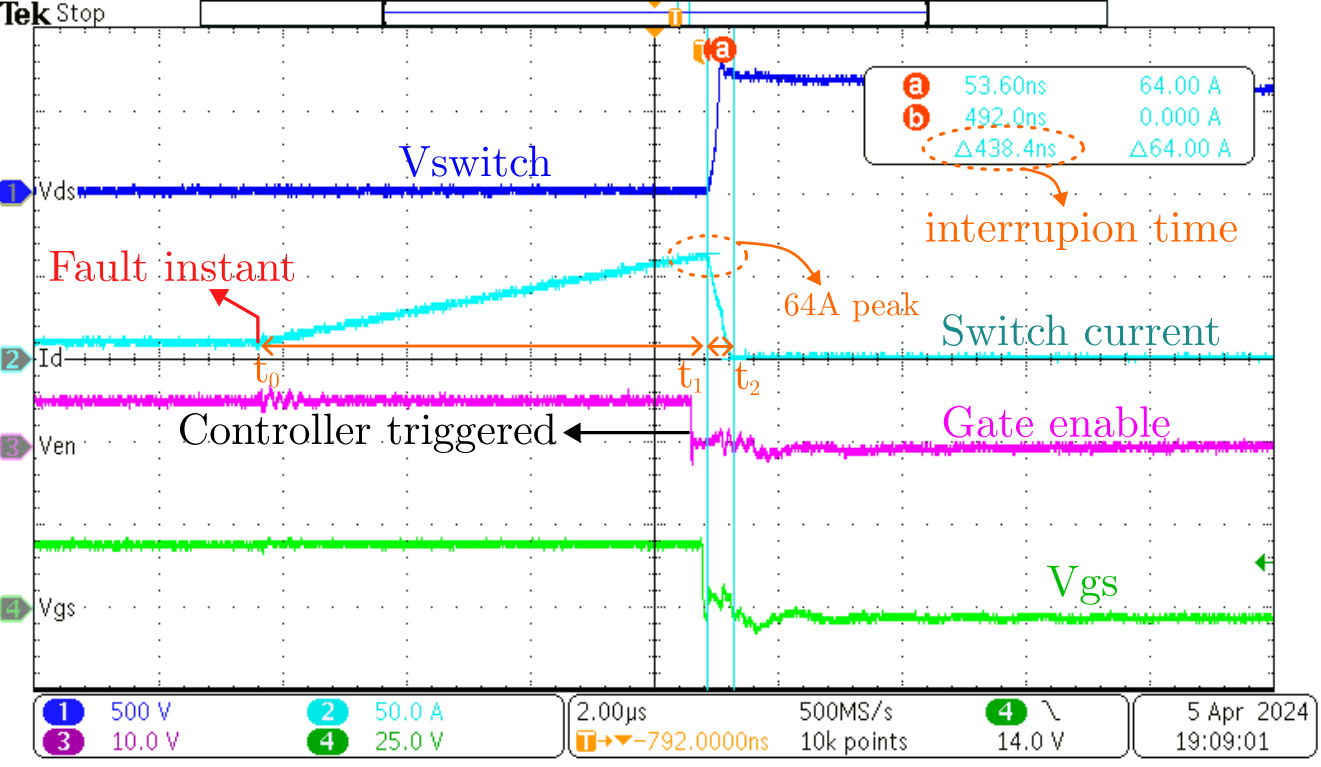
[picture p112: page 1]
