EE23DP003/eFuse/inkscape/Shortcircuit/shortcircuit_92A.pdf

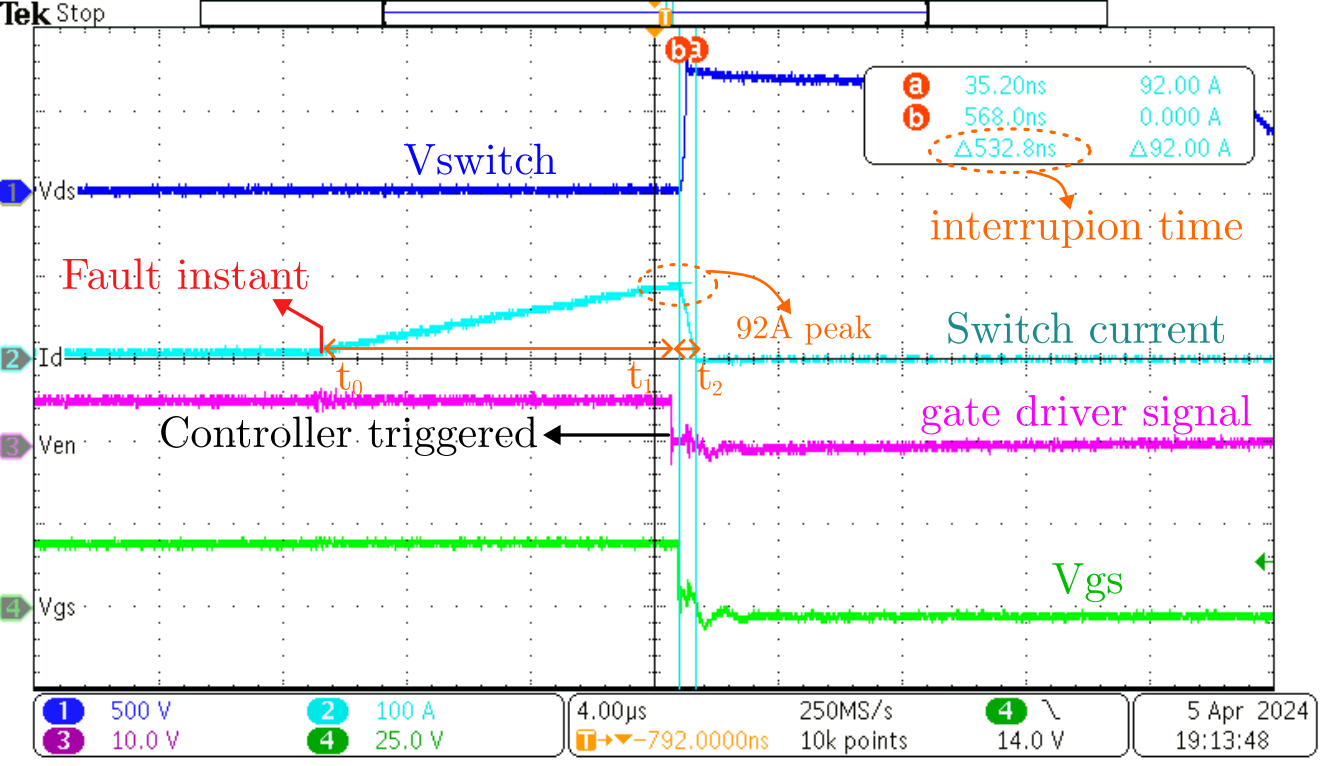
[picture p113: page 1]
