EE23DP003/eFuse/inkscape/UVLO/UVLO.pdf

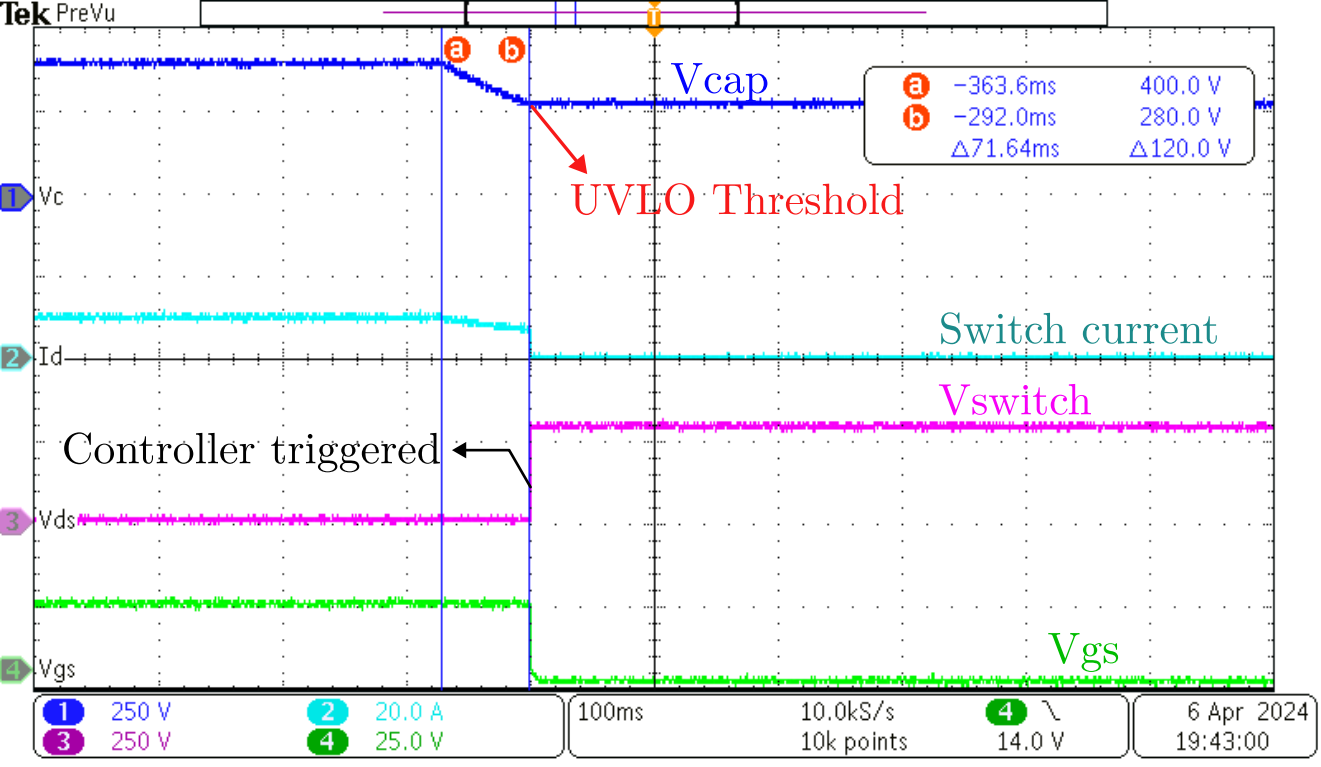
[picture p114: page 1]
