EE23DP003/eFuse/LTspice/RC Filter for ADC.asc

C1: cap; 22p
R1: res; 270
R2: res; 1k
V1: voltage; AC 1
Named nets: 0
.ac dec 10 1k 10Meg
