EE23DP003/eFuse/PCB files/SiC based Battery Disconnect.kicad_pcb

## KiCad design PCB files/SiC based Battery Disconnect.kicad_pcb (2025-01-24)

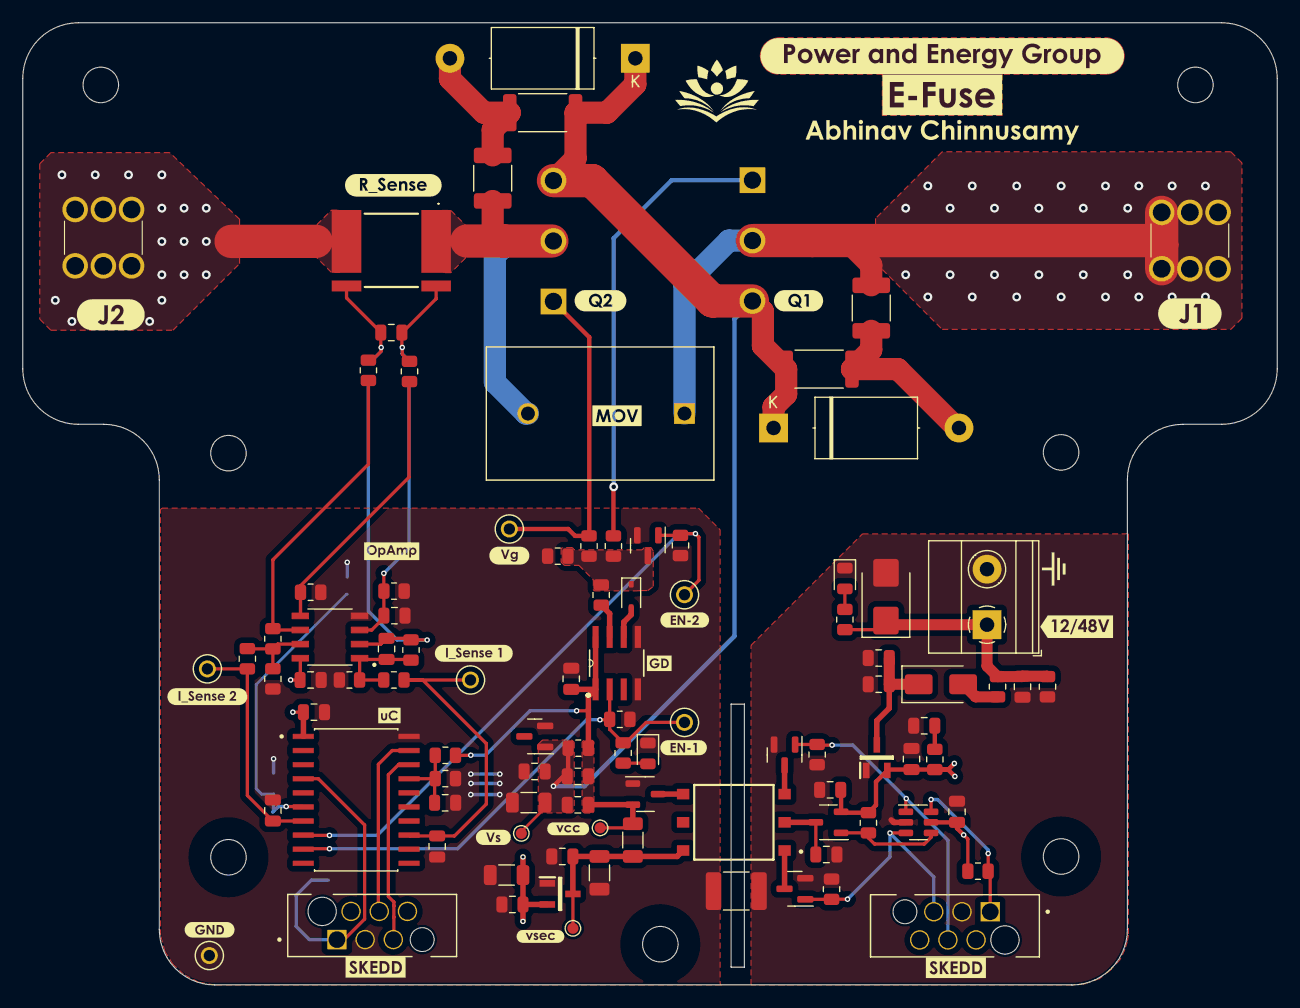
[picture p115: board SiC based Battery Disconnect.kicad_pcb from above]

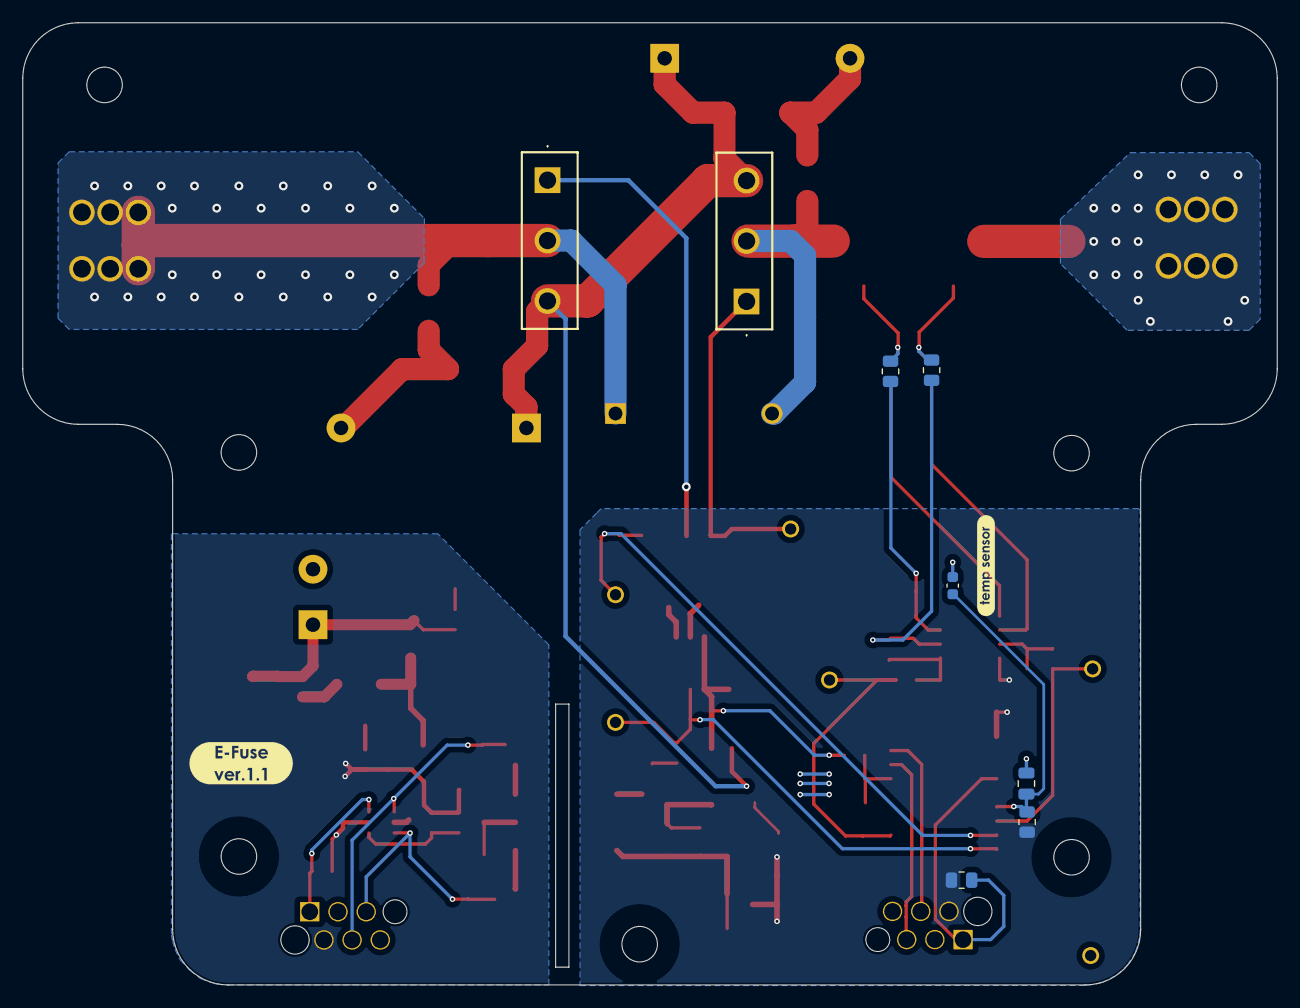
[picture p116: board SiC based Battery Disconnect.kicad_pcb from below]

Board: 2 copper layers, 113.0 x 86.7 mm, 136 parts (10 on the bottom side), 48 nets.

Parts:
C1: 100nF; C_0805_2012Metric
C2, C16: 4.7nF; C_1812_4532Metric
C3, C6, C17, C20, C21, C25, C26, C27, C28, C30: 0.1uF; C_0805_2012Metric
C4, C5: 10uF; C_1206_3216Metric
C7: 1uF; C_0805_2012Metric
C8: 4700pF; C_1812_4532Metric
C9, C12, C15: 100pF; C_0805_2012Metric
C10, C11, C13, C14, C18: 10000pF; C_0805_2012Metric
C19, C23: 10uF; C_0805_2012Metric
C22: 4.7uF; C_0805_2012Metric
C24, C29: 4.7uF; C_1206_3216Metric
D1: BAS70-04; SOT-23-3
D2, D6: LED; LED_0805_2012Metric
D3: SM6T68CA; D_SMB
D4: US1G; D_SMA
D5: BZX84C6V8; SOT-23
D7: BZX384-B22,115; D_SOD-323
D8, D9: D; D_DO-201AE_P12.70mm_Horizontal
H1, H2, H3, H4, H5, H6, H7: MountingHole; MountingHole_3.2mm_M3
IC2: PIC16F15345-I/SO; SOIC127P1030X265-20N
IC4, IC5: MCP1792T-5002H_CB; SOT95P255X145-3N
J1: Input; 7461057
J2: Output; 7461057
J3: 12V/48V supply; TerminalBlock_Phoenix_MKDS-1,5-2_1x02_P5.00mm_Horizontal
J5, J6: 490107670612; WURTH_490107670612
Q1, Q2: IMW120R014M1H
Q3, Q5, Q6: 2N7002BK,215; SOT-23
Q4: Si2333DS; SOT-23-3
R1, R2, R32: 20R; R_0805_2012Metric
R3: WSLP40261L000FEA
R4, R6, R7, R13, R30, R31, R35: 100k; R_0805_2012Metric
R5, R9, R11, R18, R25, R34: 10k; R_0805_2012Metric
R8: 10K; R_0805_2012Metric
R10, R12: 4.7k; R_0805_2012Metric
R14, R15, R19, R20, R22, R24, R33: 20k; R_0805_2012Metric
R16, R17: 1k; R_0805_2012Metric
R21, R23: 100R; R_0805_2012Metric
R26, R27: 18R; R_2512_6332Metric
R28: 0R; R_0805_2012Metric
R29: 4.7R; R_0805_2012Metric
RV1: Varistor; VARRB750W100L2050T1200H2800
T1: 760390014; 760390015
TH100: 10k; C_0603_1608Metric
TP1, TP2, TP6, TP7, TP9: 5001; KEYSTONE_5001
TP3, TP4, TP8: TestPoint; TestPoint_Pad_D1.0mm
TP5: 5001/TestPoint; KEYSTONE_5001
U1: PIC10F322-IOT; SOT-23-6
U2: MCP6022; SOIC127P599X175-8N
U4: TC4432VOA; SOIC127P600X175-8N
kibuzzard-64D0ED59, kibuzzard-64D0ED59#2: G***; kibuzzard-64D0ED59
kibuzzard-651F86C6: G***; kibuzzard-651F86C6
kibuzzard-651F886F: G***; kibuzzard-651F886F
kibuzzard-6557C38A: G***; kibuzzard-6557C38A
kibuzzard-65082C7F: G***; kibuzzard-65082C7F
kibuzzard-65082D1D: G***; kibuzzard-65082D1D
kibuzzard-65082D52: G***; kibuzzard-65082D52
kibuzzard-65082FCA: G***; kibuzzard-65082FCA
kibuzzard-65082FE1: G***; kibuzzard-65082FE1
kibuzzard-650825C2: G***; kibuzzard-650825C2
kibuzzard-650825F1: G***; kibuzzard-650825F1
kibuzzard-650830BB: G***; kibuzzard-650830BB
kibuzzard-650830F5: G***; kibuzzard-650830F5
kibuzzard-650834CF: G***; kibuzzard-650834CF
kibuzzard-650835E3: G***; kibuzzard-650835E3
kibuzzard-6508239C: G***; kibuzzard-6508239C
kibuzzard-6508248A: G***; kibuzzard-6508248A
kibuzzard-6508304F: G***; kibuzzard-6508304F
kibuzzard-6508305D: G***; kibuzzard-6508305D
kibuzzard-6508313B: G***; kibuzzard-6508313B
kibuzzard-6508355A: G***; kibuzzard-6508355A
kibuzzard-6508356A: G***; kibuzzard-6508356A
kibuzzard-65082383: G***; kibuzzard-65082383
kibuzzard-65082582: G***; kibuzzard-65082582
kibuzzard-65083125: G***; kibuzzard-65083125

Connections:
BATT+(12V-48V): C18.2, D3.1 (A1), J3.1, R11.1, R29.1, R34.1
DRIVER_EN1: IC2.9 (RC7), R10.1, R30.2, TP1.TP, U4.2 (IN)
DRIVER_EN2: IC2.8 (RC6), Q6.1 (G), R35.2, TP2.TP
Earth: C3.2, C7.2, C8.1, C17.1, C18.1, C19.1, C20.1, C21.1, C22.1, D3.2 (A2), D6.1 (K), IC5.1 (GND), J3.2, J5.3, Q3.2 (S), Q5.2 (S), R4.2, R7.2, R11.2, U1.2 (VSS)
GND: C1.2, C5.2, C6.1, C8.2, C9.2, C10.2, C11.2, C12.2, C13.2, C24.1, C25.1, C27.1, C28.1, C29.1, C30.2, D1.1 (K), D2.1 (K), D5.2 (A), IC2.20 (VSS), IC4.1 (GND), J6.3, Q6.2 (S), R9.1, R19.1, R20.1, R22.1, R25.1, R30.1, R31.1, R35.1, TH100.2, TP5.TP, U2.4 (V-), U4.4 (GND_2), U4.5 (GND)
I_SENSE_ANB4: C13.1, IC2.13 (RB4), R23.1, TP6.TP
I_SENSE_C3IN1-: C12.1, IC2.7 (RC3), R21.1, TP7.TP
I_sense+: C15.1, R3.4, R14.1, R16.1
I_sense-: C15.2, R3.3, R15.1, R17.1
unnamed: C14.2, R22.2, R23.2, R24.2, U2.1
unnamed: C22.2, R28.2
unnamed: D1.3 (A), T1.4
unnamed: D2.2 (A), R10.2
unnamed: D4.2 (A), R29.2
unnamed: C19.2, C20.2, D4.1 (K), IC5.3 (VIN)
unnamed: D6.2 (A), R34.2
unnamed: D7.2 (A), U4.6 (*OUT_2)
unnamed: D7.1 (K), Q6.3 (D), R1.1, R2.1, R31.2, R32.2
unnamed: C16.2, D8.2 (A), R27.1
unnamed: C2.2, D9.2 (A), R26.1
unnamed: C9.1, IC2.17 (RA2), R9.2, R13.1
unnamed: C10.1, IC2.6 (RC4), R12.2, TH100.1
unnamed: J2.1, J2.2, J2.3, J2.4, J2.5, J2.6, R3.2
unnamed: C2.1, J1.1, J1.2, J1.3, J1.4, J1.5, J1.6, Q1.2 (D), RV1.1
unnamed: Q1.1 (G), R1.2
unnamed: C16.1, Q2.2 (D), R3.1, RV1.2
unnamed: Q2.1 (G), R2.2, TP9.TP
unnamed: Q3.3 (D), T1.3
unnamed: C7.1, Q4.3 (D), T1.2
unnamed: Q4.1 (G), R6.1, U1.4 (RA2)
unnamed: Q5.3 (D), T1.1
unnamed: R18.2, R20.2, R21.2, U2.7
unnamed: C11.1, R16.2, R19.2, U2.3 (+)
unnamed: C14.1, R17.2, R24.1, U2.2 (-)
unnamed: R14.2, R25.2, U2.5 (+)
unnamed: R15.2, R18.1, U2.6 (-)
unnamed: R32.1, U4.7 (*OUT)
RA0: IC2.19 (RA0/ICSPDAT), J6.4
RA0_{lv}: J5.4, Q3.1 (G), R4.1, U1.1 (RA0)
RA1: IC2.18 (RA1/ICSPCLK), J6.5
RA1_{lv}: J5.5, Q5.1 (G), R7.1, U1.3 (RA1)
RA3: IC2.4 (~MCLR/VPP/RA3), J6.1, R5.1
RA3_{lv}: J5.1, R8.2, U1.6 (RA3)
VCC: C1.1, C4.1, C23.1, C26.2, D1.2 (K), R13.2, R33.1, TP8.1, U4.1 (VDD_2), U4.8 (VDD)
VDDHV: C6.2, C28.2, C29.2, C30.1, IC2.1 (VDD), IC4.2 (VOUT), J6.2, R5.2, R12.1, U2.8 (V+)
VDDLV: C3.1, C17.2, C21.2, IC5.2 (VOUT), J5.2, Q4.2 (S), R6.2, R8.1, R28.1, U1.5 (VDD)
VSEC: C4.2, C5.1, C27.2, IC4.3 (VIN), T1.6, TP3.1
VSOURCE: C23.2, C24.2, C25.2, C26.1, D5.1 (K), D8.1 (K), D9.1 (K), Q1.3 (S), Q2.3 (S), R26.2, R27.2, R33.2, TP4.1
