EE23DP003/eFuse/DSP+PIC codes/I2t codes/i2t_SSCB_with_syscfg/CPU1_FLASH/syscfg/board.h

/*
 * Copyright (c) 2020 Texas Instruments Incorporated - http://www.ti.com
 * All rights reserved.
 *
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
 * *  Redistributions of source code must retain the above copyright
 *    notice, this list of conditions and the following disclaimer.
 *
 * *  Redistributions in binary form must reproduce the above copyright
 *    notice, this list of conditions and the following disclaimer in the
 *    documentation and/or other materials provided with the distribution.
 *
 * *  Neither the name of Texas Instruments Incorporated nor the names of
 *    its contributors may be used to endorse or promote products derived
 *    from this software without specific prior written permission.
 *
 * THIS SOFTWARE IS PROVIDED BY THE COPYRIGHT HOLDERS AND CONTRIBUTORS "AS IS"
 * AND ANY EXPRESS OR IMPLIED WARRANTIES, INCLUDING, BUT NOT LIMITED TO,
 * THE IMPLIED WARRANTIES OF MERCHANTABILITY AND FITNESS FOR A PARTICULAR
 * PURPOSE ARE DISCLAIMED. IN NO EVENT SHALL THE COPYRIGHT OWNER OR
 * CONTRIBUTORS BE LIABLE FOR ANY DIRECT, INDIRECT, INCIDENTAL, SPECIAL,
 * EXEMPLARY, OR CONSEQUENTIAL DAMAGES (INCLUDING, BUT NOT LIMITED TO,
 * PROCUREMENT OF SUBSTITUTE GOODS OR SERVICES; LOSS OF USE, DATA, OR PROFITS;
 * OR BUSINESS INTERRUPTION) HOWEVER CAUSED AND ON ANY THEORY OF LIABILITY,
 * WHETHER IN CONTRACT, STRICT LIABILITY, OR TORT (INCLUDING NEGLIGENCE OR
 * OTHERWISE) ARISING IN ANY WAY OUT OF THE USE OF THIS SOFTWARE,
 * EVEN IF ADVISED OF THE POSSIBILITY OF SUCH DAMAGE.
 *
 */

#ifndef BOARD_H
#define BOARD_H

//*****************************************************************************
//
// If building with a C++ compiler, make all of the definitions in this header
// have a C binding.
//
//*****************************************************************************
#ifdef __cplusplus
extern "C"
{
#endif

//
// Included Files
//

#include "driverlib.h"
#include "device.h"

//*****************************************************************************
//
// PinMux Configurations
//
//*****************************************************************************

//
// EPWM1 -> myEPWM1 Pinmux
//
//
// EPWM1A - GPIO Settings
//
#define GPIO_PIN_EPWM1A 0
#define myEPWM1_EPWMA_GPIO 0
#define myEPWM1_EPWMA_PIN_CONFIG GPIO_0_EPWM1A
//
// EPWM1B - GPIO Settings
//
#define GPIO_PIN_EPWM1B 1
#define myEPWM1_EPWMB_GPIO 1
#define myEPWM1_EPWMB_PIN_CONFIG GPIO_1_EPWM1B
//
// GPIO7 - GPIO Settings
//
#define EN1_M1_GPIO_PIN_CONFIG GPIO_7_GPIO7
//
// GPIO6 - GPIO Settings
//
#define EN2_M1_GPIO_PIN_CONFIG GPIO_6_GPIO6
//
// GPIO10 - GPIO Settings
//
#define EN1_M2_GPIO_PIN_CONFIG GPIO_10_GPIO10
//
// GPIO11 - GPIO Settings
//
#define EN2_M2_GPIO_PIN_CONFIG GPIO_11_GPIO11
//
// GPIO31 - GPIO Settings
//
#define myBoardLED0_GPIO_GPIO_PIN_CONFIG GPIO_31_GPIO31
//
// GPIO34 - GPIO Settings
//
#define myBoardLED1_GPIO_GPIO_PIN_CONFIG GPIO_34_GPIO34

//*****************************************************************************
//
// ADC Configurations
//
//*****************************************************************************
#define myADC1_BASE ADCA_BASE
#define myADC1_RESULT_BASE ADCARESULT_BASE
#define myADC1_SOC0 ADC_SOC_NUMBER0
#define myADC1_FORCE_SOC0 ADC_FORCE_SOC0
#define myADC1_SAMPLE_WINDOW_SOC0 100
#define myADC1_TRIGGER_SOURCE_SOC0 ADC_TRIGGER_EPWM1_SOCA
#define myADC1_CHANNEL_SOC0 ADC_CH_ADCIN0
void myADC1_init();


//*****************************************************************************
//
// CPUTIMER Configurations
//
//*****************************************************************************
#define I2T_TIMER_0_BASE CPUTIMER0_BASE
void I2T_TIMER_0_init();

//*****************************************************************************
//
// EPWM Configurations
//
//*****************************************************************************
#define myEPWM1_BASE EPWM1_BASE
#define myEPWM1_TBPRD 3999
#define myEPWM1_COUNTER_MODE EPWM_COUNTER_MODE_UP
#define myEPWM1_TBPHS 0
#define myEPWM1_CMPA 0
#define myEPWM1_CMPB 0
#define myEPWM1_CMPC 0
#define myEPWM1_CMPD 0
#define myEPWM1_DBRED 0
#define myEPWM1_DBFED 0
#define myEPWM1_TZA_ACTION EPWM_TZ_ACTION_HIGH_Z
#define myEPWM1_TZB_ACTION EPWM_TZ_ACTION_HIGH_Z
#define myEPWM1_INTERRUPT_SOURCE EPWM_INT_TBCTR_DISABLED

//*****************************************************************************
//
// GPIO Configurations
//
//*****************************************************************************
#define EN1_M1 7
void EN1_M1_init();
#define EN2_M1 6
void EN2_M1_init();
#define EN1_M2 10
void EN1_M2_init();
#define EN2_M2 11
void EN2_M2_init();
#define myBoardLED0_GPIO 31
void myBoardLED0_GPIO_init();
#define myBoardLED1_GPIO 34
void myBoardLED1_GPIO_init();

//*****************************************************************************
//
// INTERRUPT Configurations
//
//*****************************************************************************

// Interrupt Settings for INT_myADC1_1
#define INT_myADC1_1 INT_ADCA1
#define INT_myADC1_1_INTERRUPT_ACK_GROUP INTERRUPT_ACK_GROUP1
extern __interrupt void INT_myADC1_1_ISR(void);

// Interrupt Settings for INT_I2T_TIMER_0
#define INT_I2T_TIMER_0 INT_TIMER0
#define INT_I2T_TIMER_0_INTERRUPT_ACK_GROUP INTERRUPT_ACK_GROUP1
extern __interrupt void INT_I2T_TIMER_0_ISR(void);

//*****************************************************************************
//
// SYNC Scheme Configurations
//
//*****************************************************************************

//*****************************************************************************
//
// Board Configurations
//
//*****************************************************************************
void	Board_init();
void	ADC_init();
void	CPUTIMER_init();
void	EPWM_init();
void	GPIO_init();
void	INTERRUPT_init();
void	SYNC_init();
void	PinMux_init();

//*****************************************************************************
//
// Mark the end of the C bindings section for C++ compilers.
//
//*****************************************************************************
#ifdef __cplusplus
}
#endif

#endif  // end of BOARD_H definition
