EE23DP003/eFuse/DSP+PIC codes/I2t codes/i2t_SSCB_with_syscfg/CPU1_FLASH/syscfg/board.c

/*
 * Copyright (c) 2020 Texas Instruments Incorporated - http://www.ti.com
 * All rights reserved.
 *
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
 * *  Redistributions of source code must retain the above copyright
 *    notice, this list of conditions and the following disclaimer.
 *
 * *  Redistributions in binary form must reproduce the above copyright
 *    notice, this list of conditions and the following disclaimer in the
 *    documentation and/or other materials provided with the distribution.
 *
 * *  Neither the name of Texas Instruments Incorporated nor the names of
 *    its contributors may be used to endorse or promote products derived
 *    from this software without specific prior written permission.
 *
 * THIS SOFTWARE IS PROVIDED BY THE COPYRIGHT HOLDERS AND CONTRIBUTORS "AS IS"
 * AND ANY EXPRESS OR IMPLIED WARRANTIES, INCLUDING, BUT NOT LIMITED TO,
 * THE IMPLIED WARRANTIES OF MERCHANTABILITY AND FITNESS FOR A PARTICULAR
 * PURPOSE ARE DISCLAIMED. IN NO EVENT SHALL THE COPYRIGHT OWNER OR
 * CONTRIBUTORS BE LIABLE FOR ANY DIRECT, INDIRECT, INCIDENTAL, SPECIAL,
 * EXEMPLARY, OR CONSEQUENTIAL DAMAGES (INCLUDING, BUT NOT LIMITED TO,
 * PROCUREMENT OF SUBSTITUTE GOODS OR SERVICES; LOSS OF USE, DATA, OR PROFITS;
 * OR BUSINESS INTERRUPTION) HOWEVER CAUSED AND ON ANY THEORY OF LIABILITY,
 * WHETHER IN CONTRACT, STRICT LIABILITY, OR TORT (INCLUDING NEGLIGENCE OR
 * OTHERWISE) ARISING IN ANY WAY OUT OF THE USE OF THIS SOFTWARE,
 * EVEN IF ADVISED OF THE POSSIBILITY OF SUCH DAMAGE.
 *
 */

#include "board.h"

//*****************************************************************************
//
// Board Configurations
// Initializes the rest of the modules. 
// Call this function in your application if you wish to do all module 
// initialization.
// If you wish to not use some of the initializations, instead of the 
// Board_init use the individual Module_inits
//
//*****************************************************************************
void Board_init()
{
	EALLOW;

	PinMux_init();
	SYNC_init();
	ADC_init();
	CPUTIMER_init();
	EPWM_init();
	GPIO_init();
	INTERRUPT_init();

	EDIS;
}

//*****************************************************************************
//
// PINMUX Configurations
//
//*****************************************************************************
void PinMux_init()
{
	//
	// PinMux for modules assigned to CPU1
	//
	
	//
	// EPWM1 -> myEPWM1 Pinmux
	//
	GPIO_setPinConfig(myEPWM1_EPWMA_PIN_CONFIG);
	GPIO_setPadConfig(myEPWM1_EPWMA_GPIO, GPIO_PIN_TYPE_STD);
	GPIO_setQualificationMode(myEPWM1_EPWMA_GPIO, GPIO_QUAL_SYNC);

	GPIO_setPinConfig(myEPWM1_EPWMB_PIN_CONFIG);
	GPIO_setPadConfig(myEPWM1_EPWMB_GPIO, GPIO_PIN_TYPE_STD);
	GPIO_setQualificationMode(myEPWM1_EPWMB_GPIO, GPIO_QUAL_SYNC);

	// GPIO7 -> EN1_M1 Pinmux
	GPIO_setPinConfig(GPIO_7_GPIO7);
	// GPIO6 -> EN2_M1 Pinmux
	GPIO_setPinConfig(GPIO_6_GPIO6);
	// GPIO10 -> EN1_M2 Pinmux
	GPIO_setPinConfig(GPIO_10_GPIO10);
	// GPIO11 -> EN2_M2 Pinmux
	GPIO_setPinConfig(GPIO_11_GPIO11);
	// GPIO31 -> myBoardLED0_GPIO Pinmux
	GPIO_setPinConfig(GPIO_31_GPIO31);
	// GPIO34 -> myBoardLED1_GPIO Pinmux
	GPIO_setPinConfig(GPIO_34_GPIO34);

}

//*****************************************************************************
//
// ADC Configurations
//
//*****************************************************************************
void ADC_init(){
	myADC1_init();
}

void myADC1_init(){
	//
	// ADC Initialization: Write ADC configurations and power up the ADC
	//
	// Configures the analog-to-digital converter module prescaler.
	//
	ADC_setPrescaler(myADC1_BASE, ADC_CLK_DIV_8_5);
	//
	// Configures the analog-to-digital converter resolution and signal mode.
	//
	ADC_setMode(myADC1_BASE, ADC_RESOLUTION_12BIT, ADC_MODE_SINGLE_ENDED);
	//
	// Sets the timing of the end-of-conversion pulse
	//
	ADC_setInterruptPulseMode(myADC1_BASE, ADC_PULSE_END_OF_CONV);
	//
	// Powers up the analog-to-digital converter core.
	//
	ADC_enableConverter(myADC1_BASE);
	//
	// Delay for 1ms to allow ADC time to power up
	//
	DEVICE_DELAY_US(500);
	//
	// SOC Configuration: Setup ADC EPWM channel and trigger settings
	//
	// Disables SOC burst mode.
	//
	ADC_disableBurstMode(myADC1_BASE);
	//
	// Sets the priority mode of the SOCs.
	//
	ADC_setSOCPriority(myADC1_BASE, ADC_PRI_ALL_ROUND_ROBIN);
	//
	// Start of Conversion 0 Configuration
	//
	//
	// Configures a start-of-conversion (SOC) in the ADC and its interrupt SOC trigger.
	// 	  	SOC number		: 0
	//	  	Trigger			: ADC_TRIGGER_EPWM1_SOCA
	//	  	Channel			: ADC_CH_ADCIN0
	//	 	Sample Window	: 20 SYSCLK cycles
	//		Interrupt Trigger: ADC_INT_SOC_TRIGGER_NONE
	//
	ADC_setupSOC(myADC1_BASE, ADC_SOC_NUMBER0, ADC_TRIGGER_EPWM1_SOCA, ADC_CH_ADCIN0, 20U);
	ADC_setInterruptSOCTrigger(myADC1_BASE, ADC_SOC_NUMBER0, ADC_INT_SOC_TRIGGER_NONE);
	//
	// ADC Interrupt 1 Configuration
	// 		Source	: ADC_SOC_NUMBER0
	// 		Interrupt Source: enabled
	// 		Continuous Mode	: disabled
	//
	//
	ADC_setInterruptSource(myADC1_BASE, ADC_INT_NUMBER1, ADC_SOC_NUMBER0);
	ADC_clearInterruptStatus(myADC1_BASE, ADC_INT_NUMBER1);
	ADC_disableContinuousMode(myADC1_BASE, ADC_INT_NUMBER1);
	ADC_enableInterrupt(myADC1_BASE, ADC_INT_NUMBER1);
}


//*****************************************************************************
//
// CPUTIMER Configurations
//
//*****************************************************************************
void CPUTIMER_init(){
	I2T_TIMER_0_init();
}

void I2T_TIMER_0_init(){
	CPUTimer_setEmulationMode(I2T_TIMER_0_BASE, CPUTIMER_EMULATIONMODE_STOPAFTERNEXTDECREMENT);
	CPUTimer_setPreScaler(I2T_TIMER_0_BASE, 200U);
	CPUTimer_setPeriod(I2T_TIMER_0_BASE, 1000U);
	CPUTimer_enableInterrupt(I2T_TIMER_0_BASE);
	CPUTimer_stopTimer(I2T_TIMER_0_BASE);

	CPUTimer_reloadTimerCounter(I2T_TIMER_0_BASE);
}

//*****************************************************************************
//
// EPWM Configurations
//
//*****************************************************************************
void EPWM_init(){
    EPWM_setClockPrescaler(myEPWM1_BASE, EPWM_CLOCK_DIVIDER_1, EPWM_HSCLOCK_DIVIDER_1);	
    EPWM_setTimeBasePeriod(myEPWM1_BASE, 3999);	
    EPWM_setTimeBaseCounter(myEPWM1_BASE, 0);	
    EPWM_setTimeBaseCounterMode(myEPWM1_BASE, EPWM_COUNTER_MODE_UP);	
    EPWM_disablePhaseShiftLoad(myEPWM1_BASE);	
    EPWM_setPhaseShift(myEPWM1_BASE, 0);	
    EPWM_setCounterCompareValue(myEPWM1_BASE, EPWM_COUNTER_COMPARE_A, 0);	
    EPWM_setCounterCompareShadowLoadMode(myEPWM1_BASE, EPWM_COUNTER_COMPARE_A, EPWM_COMP_LOAD_ON_CNTR_ZERO);	
    EPWM_setCounterCompareValue(myEPWM1_BASE, EPWM_COUNTER_COMPARE_B, 0);	
    EPWM_setCounterCompareShadowLoadMode(myEPWM1_BASE, EPWM_COUNTER_COMPARE_B, EPWM_COMP_LOAD_ON_CNTR_ZERO);	
    EPWM_setActionQualifierAction(myEPWM1_BASE, EPWM_AQ_OUTPUT_A, EPWM_AQ_OUTPUT_NO_CHANGE, EPWM_AQ_OUTPUT_ON_TIMEBASE_ZERO);	
    EPWM_setActionQualifierAction(myEPWM1_BASE, EPWM_AQ_OUTPUT_A, EPWM_AQ_OUTPUT_NO_CHANGE, EPWM_AQ_OUTPUT_ON_TIMEBASE_PERIOD);	
    EPWM_setActionQualifierAction(myEPWM1_BASE, EPWM_AQ_OUTPUT_A, EPWM_AQ_OUTPUT_NO_CHANGE, EPWM_AQ_OUTPUT_ON_TIMEBASE_UP_CMPA);	
    EPWM_setActionQualifierAction(myEPWM1_BASE, EPWM_AQ_OUTPUT_A, EPWM_AQ_OUTPUT_NO_CHANGE, EPWM_AQ_OUTPUT_ON_TIMEBASE_DOWN_CMPA);	
    EPWM_setActionQualifierAction(myEPWM1_BASE, EPWM_AQ_OUTPUT_A, EPWM_AQ_OUTPUT_NO_CHANGE, EPWM_AQ_OUTPUT_ON_TIMEBASE_UP_CMPB);	
    EPWM_setActionQualifierAction(myEPWM1_BASE, EPWM_AQ_OUTPUT_A, EPWM_AQ_OUTPUT_NO_CHANGE, EPWM_AQ_OUTPUT_ON_TIMEBASE_DOWN_CMPB);	
    EPWM_setActionQualifierAction(myEPWM1_BASE, EPWM_AQ_OUTPUT_B, EPWM_AQ_OUTPUT_NO_CHANGE, EPWM_AQ_OUTPUT_ON_TIMEBASE_ZERO);	
    EPWM_setActionQualifierAction(myEPWM1_BASE, EPWM_AQ_OUTPUT_B, EPWM_AQ_OUTPUT_NO_CHANGE, EPWM_AQ_OUTPUT_ON_TIMEBASE_PERIOD);	
    EPWM_setActionQualifierAction(myEPWM1_BASE, EPWM_AQ_OUTPUT_B, EPWM_AQ_OUTPUT_NO_CHANGE, EPWM_AQ_OUTPUT_ON_TIMEBASE_UP_CMPA);	
    EPWM_setActionQualifierAction(myEPWM1_BASE, EPWM_AQ_OUTPUT_B, EPWM_AQ_OUTPUT_NO_CHANGE, EPWM_AQ_OUTPUT_ON_TIMEBASE_DOWN_CMPA);	
    EPWM_setActionQualifierAction(myEPWM1_BASE, EPWM_AQ_OUTPUT_B, EPWM_AQ_OUTPUT_NO_CHANGE, EPWM_AQ_OUTPUT_ON_TIMEBASE_UP_CMPB);	
    EPWM_setActionQualifierAction(myEPWM1_BASE, EPWM_AQ_OUTPUT_B, EPWM_AQ_OUTPUT_NO_CHANGE, EPWM_AQ_OUTPUT_ON_TIMEBASE_DOWN_CMPB);	
    EPWM_setRisingEdgeDelayCountShadowLoadMode(myEPWM1_BASE, EPWM_RED_LOAD_ON_CNTR_ZERO);	
    EPWM_disableRisingEdgeDelayCountShadowLoadMode(myEPWM1_BASE);	
    EPWM_setFallingEdgeDelayCountShadowLoadMode(myEPWM1_BASE, EPWM_FED_LOAD_ON_CNTR_ZERO);	
    EPWM_disableFallingEdgeDelayCountShadowLoadMode(myEPWM1_BASE);	
    EPWM_enableInterrupt(myEPWM1_BASE);	
    EPWM_enableADCTrigger(myEPWM1_BASE, EPWM_SOC_A);	
    EPWM_setADCTriggerSource(myEPWM1_BASE, EPWM_SOC_A, EPWM_SOC_TBCTR_PERIOD);	
    EPWM_setADCTriggerEventPrescale(myEPWM1_BASE, EPWM_SOC_A, 1);	
}

//*****************************************************************************
//
// GPIO Configurations
//
//*****************************************************************************
void GPIO_init(){
	EN1_M1_init();
	EN2_M1_init();
	EN1_M2_init();
	EN2_M2_init();
	myBoardLED0_GPIO_init();
	myBoardLED1_GPIO_init();
}

void EN1_M1_init(){
	GPIO_writePin(EN1_M1, 0);
	GPIO_setPadConfig(EN1_M1, GPIO_PIN_TYPE_STD);
	GPIO_setQualificationMode(EN1_M1, GPIO_QUAL_SYNC);
	GPIO_setDirectionMode(EN1_M1, GPIO_DIR_MODE_OUT);
	GPIO_setControllerCore(EN1_M1, GPIO_CORE_CPU1);
}
void EN2_M1_init(){
	GPIO_writePin(EN2_M1, 1);
	GPIO_setPadConfig(EN2_M1, GPIO_PIN_TYPE_STD);
	GPIO_setQualificationMode(EN2_M1, GPIO_QUAL_SYNC);
	GPIO_setDirectionMode(EN2_M1, GPIO_DIR_MODE_OUT);
	GPIO_setControllerCore(EN2_M1, GPIO_CORE_CPU1);
}
void EN1_M2_init(){
	GPIO_writePin(EN1_M2, 0);
	GPIO_setPadConfig(EN1_M2, GPIO_PIN_TYPE_STD);
	GPIO_setQualificationMode(EN1_M2, GPIO_QUAL_SYNC);
	GPIO_setDirectionMode(EN1_M2, GPIO_DIR_MODE_IN);
	GPIO_setControllerCore(EN1_M2, GPIO_CORE_CPU1);
}
void EN2_M2_init(){
	GPIO_writePin(EN2_M2, 1);
	GPIO_setPadConfig(EN2_M2, GPIO_PIN_TYPE_STD);
	GPIO_setQualificationMode(EN2_M2, GPIO_QUAL_SYNC);
	GPIO_setDirectionMode(EN2_M2, GPIO_DIR_MODE_IN);
	GPIO_setControllerCore(EN2_M2, GPIO_CORE_CPU1);
}
void myBoardLED0_GPIO_init(){
	GPIO_writePin(myBoardLED0_GPIO, 0);
	GPIO_setPadConfig(myBoardLED0_GPIO, GPIO_PIN_TYPE_STD);
	GPIO_setQualificationMode(myBoardLED0_GPIO, GPIO_QUAL_SYNC);
	GPIO_setDirectionMode(myBoardLED0_GPIO, GPIO_DIR_MODE_OUT);
	GPIO_setControllerCore(myBoardLED0_GPIO, GPIO_CORE_CPU1);
}
void myBoardLED1_GPIO_init(){
	GPIO_writePin(myBoardLED1_GPIO, 1);
	GPIO_setPadConfig(myBoardLED1_GPIO, GPIO_PIN_TYPE_STD);
	GPIO_setQualificationMode(myBoardLED1_GPIO, GPIO_QUAL_SYNC);
	GPIO_setDirectionMode(myBoardLED1_GPIO, GPIO_DIR_MODE_OUT);
	GPIO_setControllerCore(myBoardLED1_GPIO, GPIO_CORE_CPU1);
}

//*****************************************************************************
//
// INTERRUPT Configurations
//
//*****************************************************************************
void INTERRUPT_init(){
	
	// Interrupt Setings for INT_myADC1_1
	Interrupt_register(INT_myADC1_1, &INT_myADC1_1_ISR);
	Interrupt_enable(INT_myADC1_1);
	
	// Interrupt Setings for INT_I2T_TIMER_0
	Interrupt_register(INT_I2T_TIMER_0, &INT_I2T_TIMER_0_ISR);
	Interrupt_enable(INT_I2T_TIMER_0);
}
//*****************************************************************************
//
// SYNC Scheme Configurations
//
//*****************************************************************************
void SYNC_init(){
	SysCtl_setSyncOutputConfig(SYSCTL_SYNC_OUT_SRC_EPWM1SYNCOUT);
	//
	// For EPWM1, the sync input is: SYSCTL_SYNC_IN_SRC_EXTSYNCIN1
	//
	SysCtl_setSyncInputConfig(SYSCTL_SYNC_IN_EPWM4, SYSCTL_SYNC_IN_SRC_EPWM1SYNCOUT);
	SysCtl_setSyncInputConfig(SYSCTL_SYNC_IN_EPWM7, SYSCTL_SYNC_IN_SRC_EPWM1SYNCOUT);
	SysCtl_setSyncInputConfig(SYSCTL_SYNC_IN_EPWM10, SYSCTL_SYNC_IN_SRC_EPWM1SYNCOUT);
	SysCtl_setSyncInputConfig(SYSCTL_SYNC_IN_ECAP1, SYSCTL_SYNC_IN_SRC_EPWM1SYNCOUT);
	SysCtl_setSyncInputConfig(SYSCTL_SYNC_IN_ECAP4, SYSCTL_SYNC_IN_SRC_EPWM1SYNCOUT);
	//
	// SOCA
	//
	SysCtl_enableExtADCSOCSource(0);
	//
	// SOCB
	//
	SysCtl_enableExtADCSOCSource(0);
}
