EE23DP003/eFuse/DSP+PIC codes/Fixed tripping/E-Fuse_HVMCU.X/efuse.h

/* 
 * File:   efuse.h
 * Author: C52935
 *
 * Created on October 27, 2021, 9:57 AM
 */

#ifndef EFUSE_H
#define	EFUSE_H

#ifdef	__cplusplus
extern "C" {
#endif

extern uint16_t ticks_1ms; // updated in timer0 ISR

// LIN configurable variables
extern uint8_t  dac_i_hw_trip;
extern uint16_t isense_max;
extern uint8_t  reduced_drive_time;
extern uint16_t  tcc_sample_time;
extern uint8_t  triggerType;


// LIN read-only variables
extern uint16_t adcVccSense_curr;
extern uint16_t adcISense_curr;
extern uint16_t adcTSense_curr;
extern uint16_t adcISense_corr;
extern uint16_t iSenseOffset;
extern uint8_t  outputState;
extern uint8_t  overCurrentFault;
extern uint8_t  uvloFault;

enum EFUSE_STATES {OUTPUT_OFF, OUTPUT_ON};

void CmdOutput(uint8_t);
void EFuse(void);
void EFuseInit(void);
void ProcessAnalogInputs(void);


#ifdef	__cplusplus
}
#endif

#endif	/* EFUSE_H */
