EE23DP003/eFuse/DSP+PIC codes/Fixed tripping/E-Fuse_HVMCU.X/main.h

/* 
 * File:   main.h
 * Author: C52935
 *
 * Created on October 27, 2021, 8:07 AM
 */

#ifndef MAIN_H
#define	MAIN_H

#ifdef	__cplusplus
extern "C" {
#endif




#ifdef	__cplusplus
}
#endif

#endif	/* MAIN_H */
